erebus-labs/PSU-VOC-SENSOR-2K14/README.md

PSU VOC SENSOR PROJECT
==============

The PSU VOC SENSOR PROJECT is a multi-board and software approach to sensor data collection, specifically targetting K20 classrooms - All on an open source HW/SW stack.

The mutli-board solution allows for the independant and decoupled developement of custom sensors, while the open software stack allows custom interpolation of sensor readings. 

- [ ] Note that Some USB Drivers/custom communication drivers still need to be reworked before the entire project can be released under some flavor of Open Source Licensing (e.g. GPL v3?)

All of the Hardware and Software developed is available, keeping in mind that future revisions and use must maintain open source licensing.

#Schematics

##Main Board
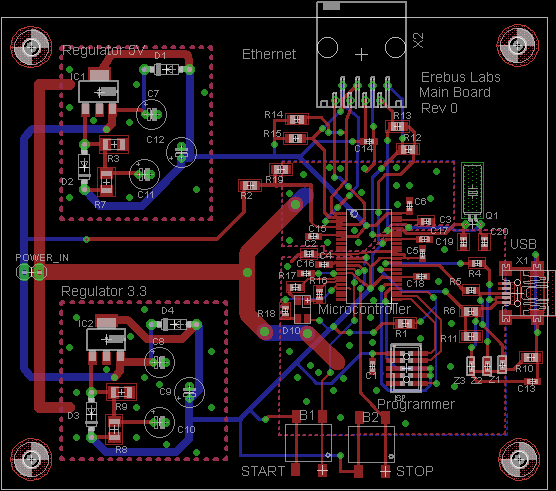
[picture p1: Schematics/LDO/LDO_Layout.png]
Main Board Main Board Schematic


##Sensor Boards
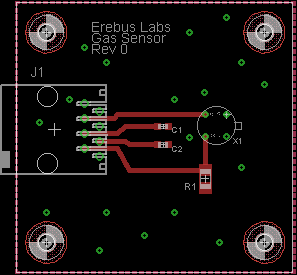
[picture p2: Schematics/Gas_Sensor/Gas_Sensor_layout.png]
Gas Sensor Gas Sensor Schematic


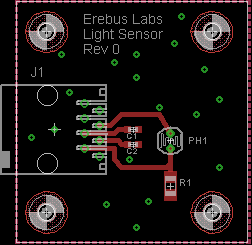
[picture p3: Schematics/Ligth_Sensor/Light_Sensor_Layout.png]
Light Sensor Light Sensor Schematic


#Code

##uC 

##GUI
