erebus-labs/PSU-VOC-SENSOR-2K14/Documents/Poster.pptx

Erebus Labs STEM Sensor

Department of Electrical and Computer Engineering

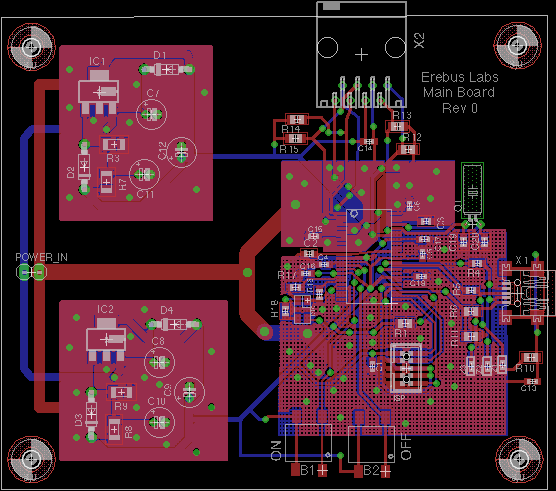
[picture p5: figure]
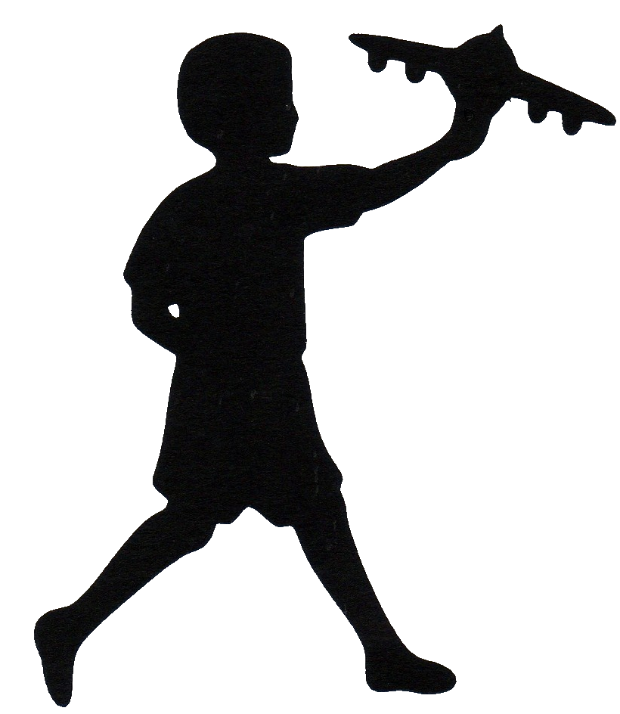
[picture p6: figure]
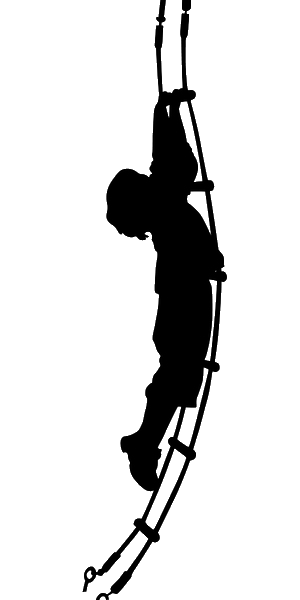
[picture p7: figure]
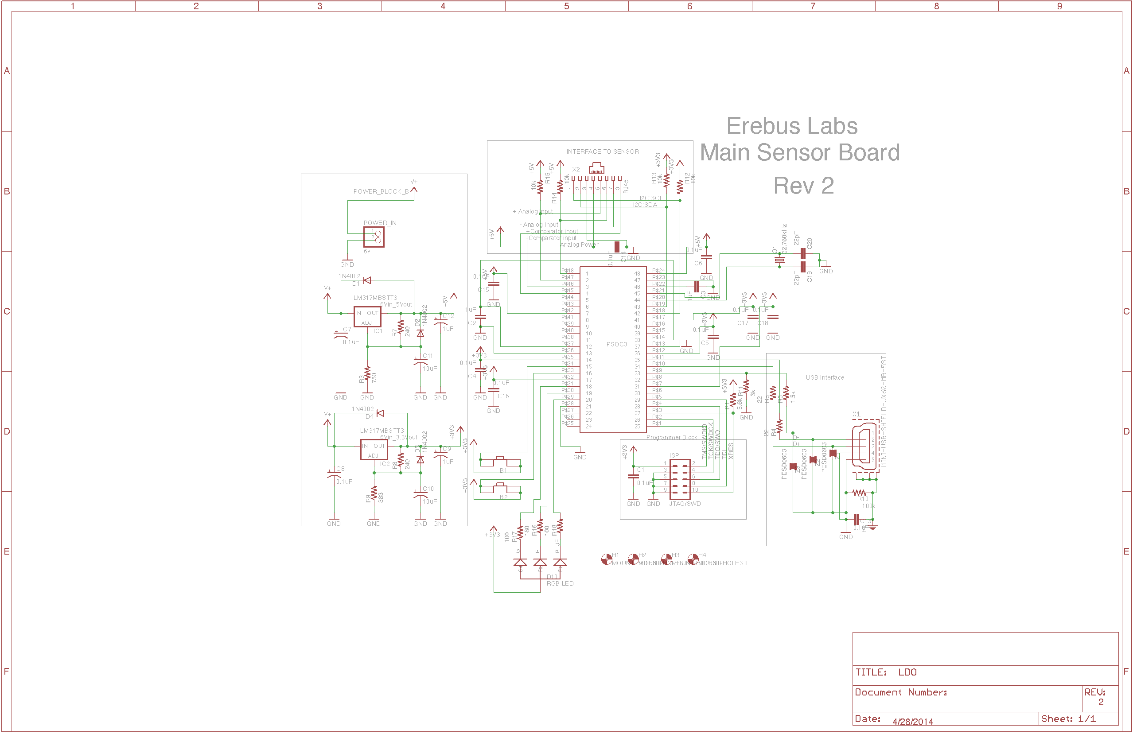
[picture p8: figure]

Meet The Team

Scott Lawson:
Computer Engineering
Max Cope:
Electrical Engineering
Chris Clary:
Electrical Engineering
Bryan Button:
Electrical Engineering
Mike Borowczak, Ph.D.:
Sponsor
Andrea Burrows, Ed.D.:
Assistant Professor of Secondary Education, UW
Sponsor
James E. Morris, Ph.D.:
Professor or Electrical and Computer Engineering
Advisor
