erebus-labs/PSU-VOC-SENSOR-2K14/Documents/source_documents/Presentation.pptx

## Erebus Labs STEM Sensor

Scott Lawson – CpE
Chris Clary – EE
Max Cope – EE
Bryan Button – EE

## Slide 2

Erebus Labs STEM Sensor

- Introduction

Objective
Hardware
Software
Lessons Learned
Thoughts for Rev. 2
Q&A

## Slide 3

- Introduction

- Objective

- Create an Environmental Sensor System
  - Hardware/Software
  - Documentation
- Keep it Simple
- Keep it Open
- Keep it Cheap
- Get Kids Interested in STEM!

Notes: Talking points:

%16 of American high school seniors are proficient in mathematics and interested in a STEM career

## Hardware

## Slide 5

- Hardware

- Hardware Overview

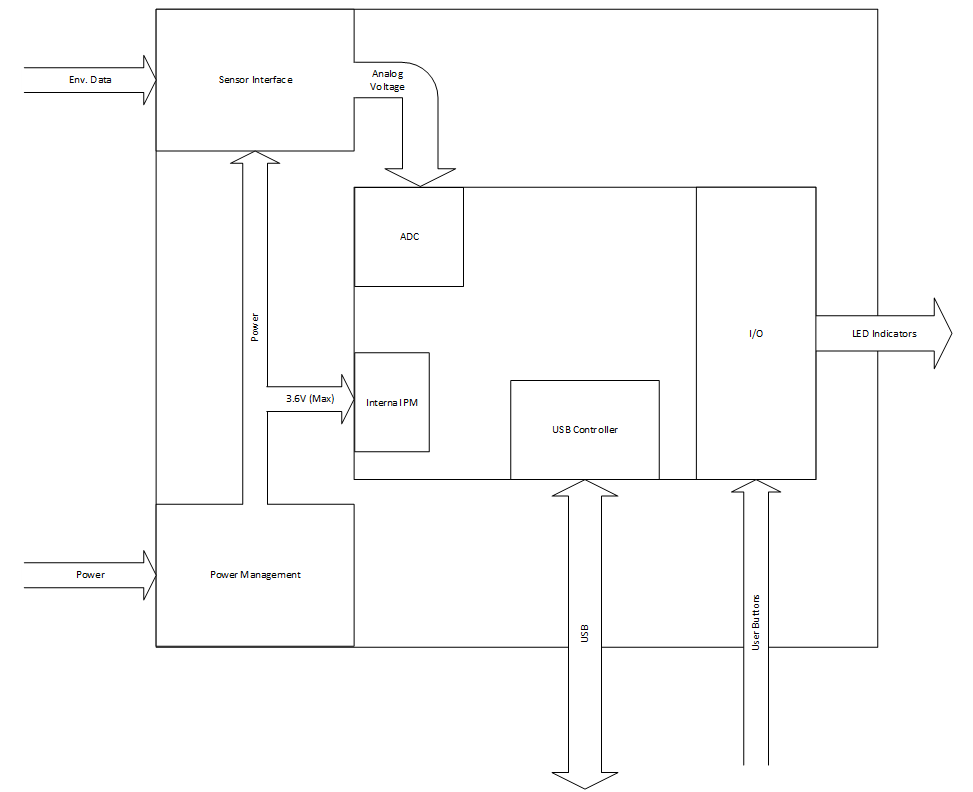
[picture p47: figure]

## Slide 6

- Hardware

- Main Board (Base Station)

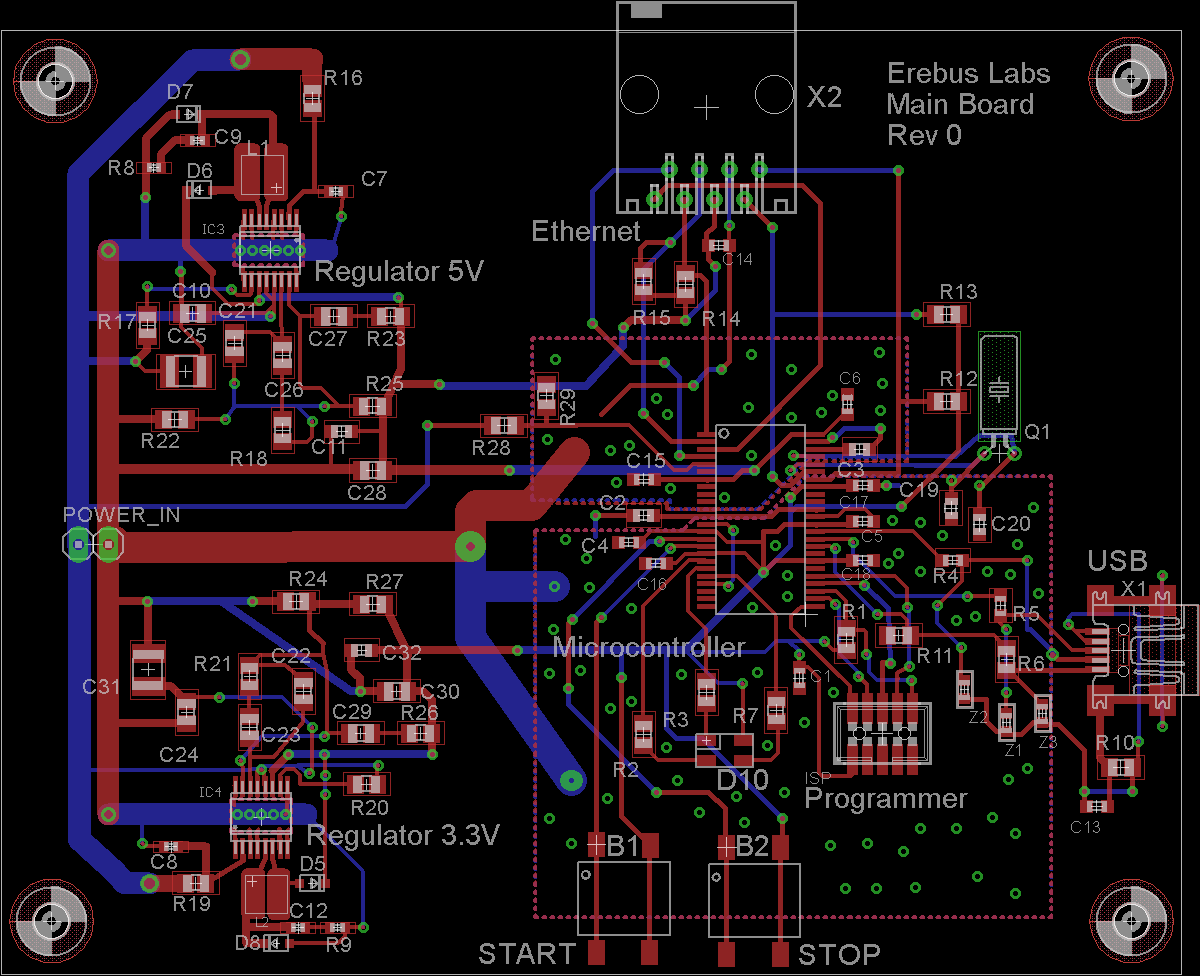
[picture p48: figure]

Sensor Port

PSoC 3 Microcontroller

USB Interface

Switching Power Supply

Notes: Chris starts
Discuss GPs
Note power and interface and discuss in detail when they come up

## Slide 7

- Hardware

- Power Supply

- Linear Power Supply
  - Less Noise
  - Lower Battery Life
- Switching Power Supply
  - Noise Not An Issue
  - Better Battery Life
  - One Part for 3V and 5V
  - More Complex

Notes: Tradeoffs (LDO vs Swiching)

Switching regulators didn’t work on breadboard

## Slide 8

- Hardware

- Interfaces

- Ethernet for Sensor Port
  - Cheap Cables
  - Easy to Work With
  - Many Lengths Available
- USB
  - Standard for Most Computer Interface Applications
  - Micro USB = Small Footprint


Notes: Ethernet:
Cheap cables are important for keeping costs low.
Easy to work with in consideration of use by children (not to hard to make your own cable).
Length kept in mind for future applications (e.g. sensor in a well)
More sensors could be put onto a single module

USB:

## Slide 9

- Hardware

- Low-Oxygen Sensor

- Figaro TGS 2600
- Technically “Air Contaminant Sensor”
- Resemblance to VOC Sensor
- Easy to Find Applications or Experiments


Notes: Labeled as an air contaminant sensor, the device senses contaminants due to the displacement of oxygen (or just normal breathing air) causing a change in the flow of electrons. Different sensitivity characteristics for different gasses.

Wanted to do a sensor that detected the quality of a substance similar to the original request for a VOC sensor for wells.

Experiments include things such as detecting change in air quality in high traffic areas over certain times or seeing how rapidly the quality of air changes when enclosed with a burning candle (and how long it takes for air to return to normal).

## Slide 10

- Hardware

- Light Sensor

- Easy to Implement
- Simple to Understand
- Many Use Cases
- Proof of Concept Sensor


## Slide 11

- Hardware

- Other

- Two Buttons (Start & Stop)
- LED System Indicator
  - Start Sampling
  - Stop Sampling
- Powered with 4x AA Batteries

## Slide 12

- Hardware

- Cypress PSoC 3

- One Chip Solution
  - Real Time Clock
  - USB Controller
  - Hardware Emulation
- Flexible Architecture
  - Universal Digital Blocks
  - Programmable Interconnects
- Development Kit – Rapid Prototyping

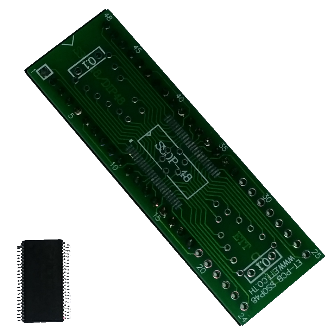
[picture p49: figure]
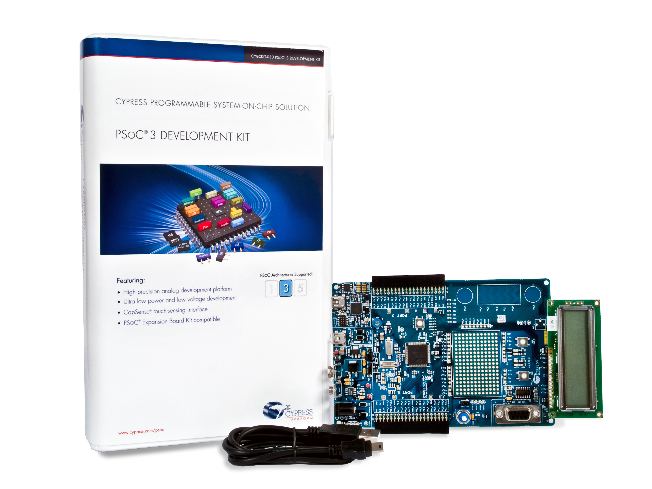
[picture p50: figure]

Notes: Max starts
One Comp E. Three with basic programming skills.
All had experience with Arduino. Simple IDEs
Needed something easy to program and could handle all we needed.

## Slide 13

- Hardware

- PSoC Architecture

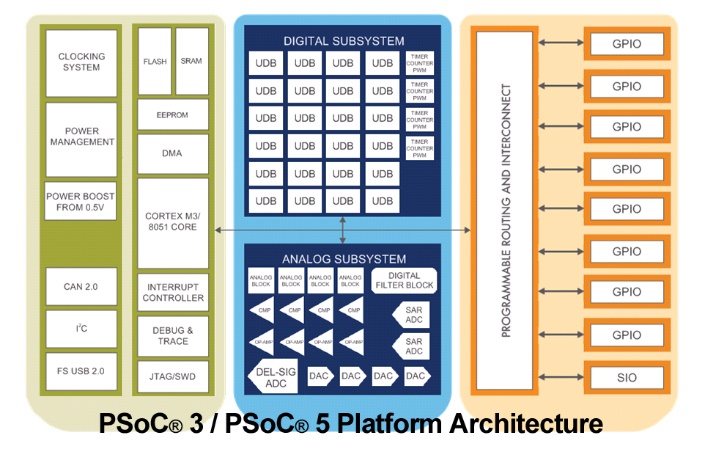
[picture p51: figure]

Notes: Universal GPIO
Analog Digital
Multiplexed ADC
Programmable Gain
Configurable Logic

## Software

## Slide 15

- Software

- PSoC Creator

- Free Development Environment
- Drag-and-Drop Programming
- Extensive APIs


Notes: EDE free to use. Graphical interface to simplify programming workload and design.
APIs. Option Windows. Build Project creates foundational code. Can modify from there.

## Slide 16

- Software

- Firmware

EX: Sample Every 3 Seconds
  - RTC Interrupts
  - Sample Counter Increments
  - If Counter == Sample Interval
    - Take Sample

Notes: Keep basic.
Wakes up every second to check for interrupt.

Pointers
Flash
Interrupts.
RTC Sampling

Buttons interrupt.
Once set up sleeps . Every second wakes up to check for flags.

## Slide 17

- Software

- Firmware

- Serial Over USB
- LED System Indicator
  - Sample
  - Error
  - USB Connected
- Max Speed 1 Sample Per Second

Notes: Will not show up as USB. Virtual COM Port.
Sample:
Blue blink
Errors:
* Low Battery (blink yellow)
Memory Full (red)
USB
Solid teal

1 Second check. No faster
Counter logic for timed samples

## Slide 18

- Software

- Firmware

- Emulated EEPROM
  - Emulated Inside Flash
  - Wear Leveling
- Power Management
  - No Power Switch
  - Minimal Current Use
- Timestamps Using Real Time Clock

Notes: Scott starts

## Slide 19

- Software

- GUI

- Simple & Minimalistic
- Sample Settings
- Reference and Documentation


## Slide 20

- Software

- Software/Hardware Interaction

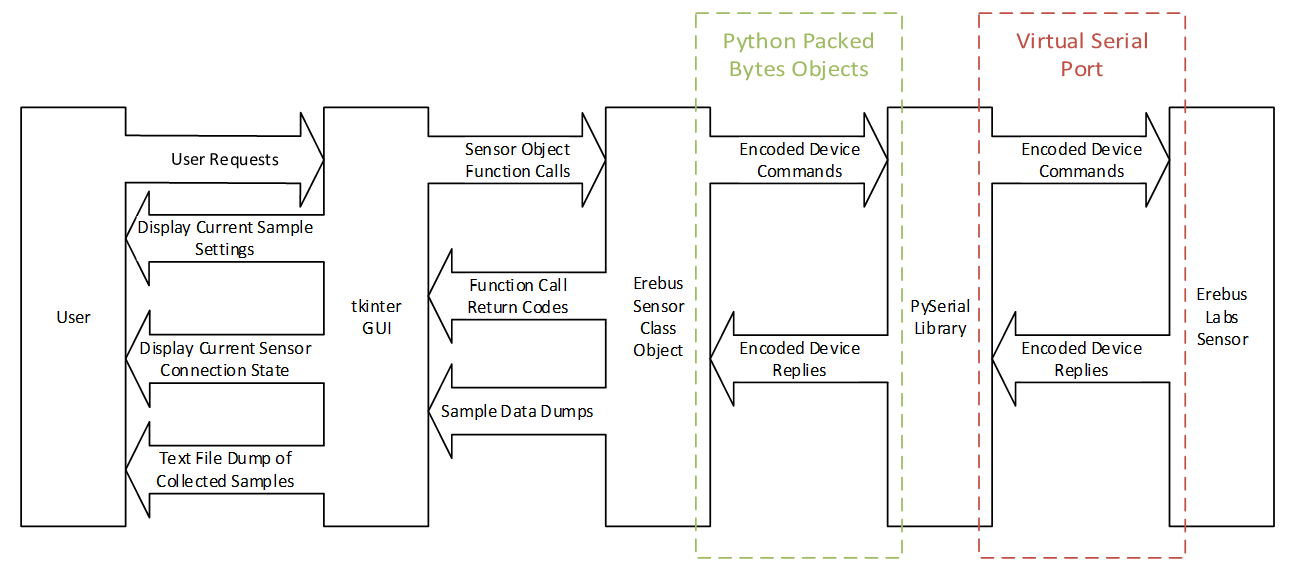
[picture p52: figure]

## Documentation

Notes: Hand out documents

Stop example experiment and process data

## Slide 22

- Documentation

- User Documents

- Technical Reference Manual
- System Architecture
- User Manual
- Fundamentals of Electronics

Notes: Start handing out documentation

## Slide 23

- Documentation

- Project Documents

- Design Specification
- Budget
- Timeline
- Requirements
- Test Plan

## Lessons Learned (Thoughts for Rev. 2)

Notes: Bryan starts

## Slide 25

- Thoughts

- Lessons Learned

- Don’t Focus on Single-Chip Solution
  - Distribution = Power Savings
- Use Separate EEPROM
  - Storage not Lost Due to Firmware Size
  - Wear Leveling
- Use Off-Chip RTC
  - Button-Cell Battery Backup

Notes: Current RTC loses time when power is lost

## Slide 26

- Thoughts

- Revision 2

- Critical Battery Shutdown
- Enclosure Mounted Buttons
- Power-Wire Strain Relief
- Weather Proof Box
- VOC Sensor
- Multiple Sensor Ports
- Jumper for Power

## Q&A

Notes: Answer questions
