erebus-labs/PSU-VOC-SENSOR-2K14/Documents/source_documents/Budget.docx

Erebus Labs

STEM Sensors

Budget

Version 1.6

6/4/2014

scott lawson

Bryan Button

Chris clary

max cope

VERSION HISTORY

Version # | Implemented By | Revision Date | Reason
1.5 | Scott Lawson | 6/4/2014 | Added Final BOM Costs
1.4 | Scott Lawson | 6/1/2014 | Removed 2.2 – Remaining Costs section Separated BOM section into Initial Estimation and Final
1.3 | Scott Lawson | 2/1/2014 | Fixed Header and cover sheet typos Split Total Anticipated Budge & Remaining Costs
1.2 | Scott Lawson | 1/31/2014 | Added development boards cost to section 2.2 Fixed type in BOM costs
1.1 | Scott Lawson | 1/30/2014 | Changed to Standardized Format Added microcontroller costs
1.0 | Scott Lawson | 1/28/2014 | Initial Release

NOTE TO READER

This is a template obtained from:

http://www2.cdc.gov/cdcup/library/templates/default.htm

Template Name: Product Design

UP Template Version: 12/31/07

TABLE OF CONTENTS

# 1 Introduction

## 1.1 Purpose of The Document

This document describes the budget allotted and cost estimations for the Erebus Labs STEM Sensor. This document is intended to be a living document. As such, it should be updated whenever new budget-related information is available. The reader should be aware that information contained in this document may change at any time.

## 1.2 Objective Statement

Encourage an interest in STEM in K-12 students by delivering a working prototype of an affordable, simple and flexible device to collect environmental data.

## 1.3 Overview

This document is divided into two sections:

1. Development Costs

This section contains estimated costs related to the development of the STEM Sensor. This section is further divided into two sections: a ledger to track purchases that have already been made, and a summary of the total anticipated development budget from the beginning of the project.

2. Bill of Materials Costs

These are costs associated with the production of a single sensor unit, excluding amortized development costs. This section contains both the final BOM cost as well as a copy of the initial estimation before many design decisions were made for comparison.

# 2 Development Costs

## 2.1 Ledger

## 2.2 Initial Estimation

Item | Cost (Ea) | Quantity | Ext. Cost | Cost Factors
Sensor | 1.00 – 25.00 | 5 – 8 | 5.00 – 50.001 | Type, Quantity of each type
μController | 1.50 – 5.00 | 5 – 8 | 7.50 – 40.00 | Onboard Features, power consumption
Batteries | 0.75 – 12.00 | 5 – 162 | 12.00 – 60.002 | Rechargeable, composition, form factor
Passives4 | 0.05 – 2.00 | 50 – 100 | 20.00 – 30.001 | Values and tolerances required
Interfaces5 | 0.50 – 8.00 | 16 – 25 | 8.00 – 50.00 | Wireless vs. Wired
PCBs6 | 4.00 – 18.00 | 4 – 6 | 24.00 – 48.00 | PCB Area, sensor requirements
Other SI7 | 0.50 – 2.00 | 16 – 30 | 8.00 – 50.001 | Battery selection, sensor output
Packaging | 3.00 – 75.00 | 2 – 3 | 9.00 – 225.00 | Materials: laser-cut acrylic vs. 3D-printer
Software | 0.00 | 0.00 | 0.00 | Only utilizing free development software
Development Boards | 10.00 – 60.00 | 4 | 40.00 – 240.00 | Options available for selected controller
| | | | | | 0.00 | 0.00 | 0.00 | Only utilizing free development software
Total: | | | | | 300.00 – 700.00

1. Extended cost does not scale linearly with quantity because it is assumed that the maximum quantity would not be entirely comprised of the most expensive components.
2. Quantity and extended cost assume either a small amount of expensive rechargeable proprietary batteries, or a larger amount of cheap (AA or 9V) batteries.
3. Resistors, capacitors, inductors, LEDs
4. Antennas, transceivers, receivers, cable jacks
5. Assumes a PCB for the base unit as well as separate PCBs for the interchangeable sensors.

Example: Minimum extended cost is based on a 2in x 2in base unit PCB with two 1in x 1in sensor PCBs at $2.00 per square inch, x2 prototypes.

6. Other semiconductors: op-amps, voltage regulators, discrete transistors

# 3 BOM Costs

## 3.1 Final

## 3.2 Initial Estimation

# Appendix A: Glossary

## A.1 Acronyms

Acronym | Meaning
ADC | Analog-to-Digital Converter
BOM | Bill of Materials
CO | Carbon Monoxide
CSV | Comma-separated-value formatted file
EEPROM | Electrically Erasable Programmable Read-Only Memory
EPL | The Portland State University Engineering and Prototyping Lab
I²C | The Inter-Integrated Circuit communication protocol
ISR | Interrupt Service Routine
K-12 | Kindergarten through 12th grade school
LED | Light Emanating Diode
PCB | Printed Circuit Board
PSoC | Programmable System On Chip
SI | Silicon
SPI | Serial Peripheral Interface Bus
STEM | Science, Technology, Engineering and Math
TRM | Technical Reference Manual
USB | Universal Serial Bus

Page 9 of 9 Portland State University ECE Capstone 2014

Portland State University ECE Capstone 2014

STEM Sensors Budget
