erebus-labs/PSU-VOC-SENSOR-2K14/Documents/System_Architecture.pdf

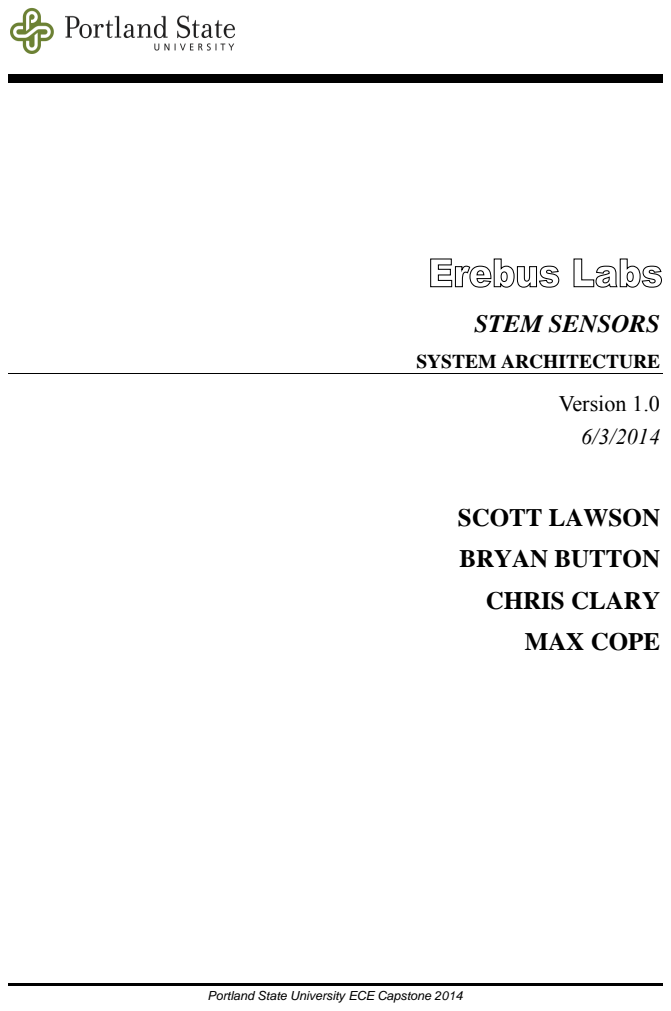
[picture p53: page 1]
STEM SENSORS; SYSTEM ARCHITECTURE; Version 1.0; SCOTT LAWSON; BRYAN BUTTON; CHRIS CLARY; MAX COPE

Portland State University ECE Capstone 2014

STEM Sensors System

SYSTEM ARCHITECTURE

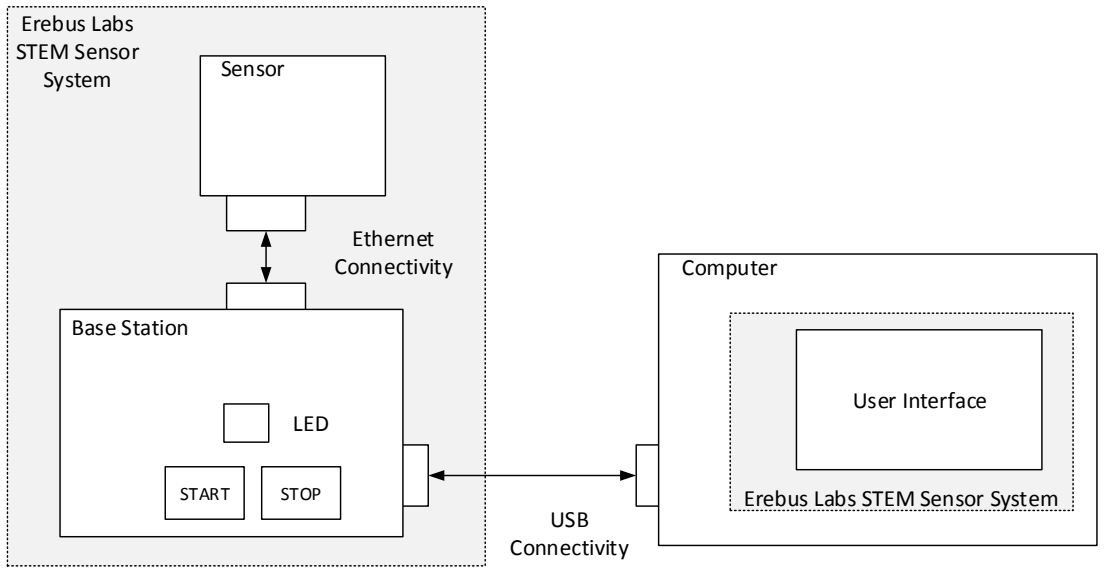
[picture p54: figure]
Ethernet Connectivity; Base Station; Sensor; Computer; USB Connectivity; Erebus Labs STEM Sensor System; START; STOP; LED; User Interface

System
The operational product comprised of base units with attached sensors and a user interface.
Base Unit
The central device that manages power, communication, and data storage, and has one or more sensors attached to it.
Sensor
The individual data collection devices such as VOC detectors and ambient light detectors that are attached to the base unit.

User Interface
The program that will be run on a laptop or desktop computer that allows the user to view and interact with the data collected.

STEM Sensors System

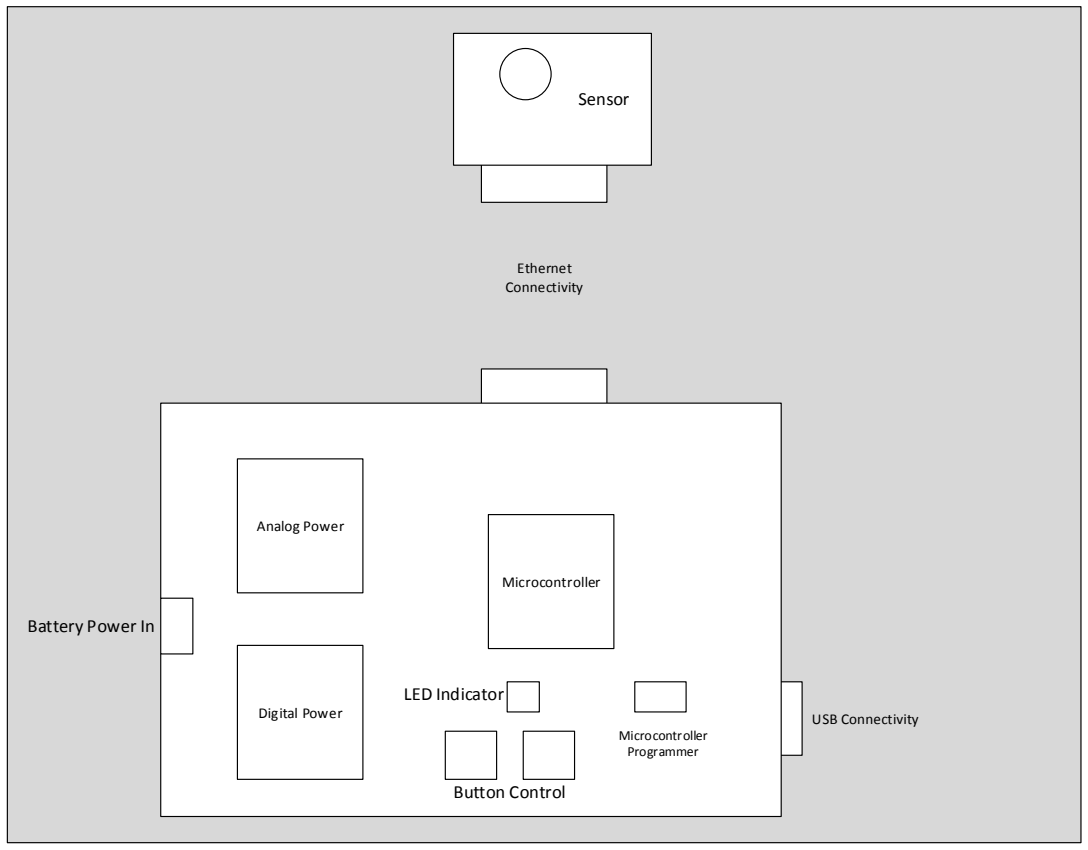
[picture p55: figure]
Microcontroller; Analog Power; Digital Power; Button Control; LED Indicator; Battery Power In; Microcontroller Programmer; Ethernet Connectivity; Sensor; USB Connectivity

Power
Provides 3.3V and 5V power for all peripherals both analog and digital. Sensors are powered from base station.
Microcontroller
System control including taking of samples and storing data. Reprogram capability.
User Control
User controllability with two buttons, Start and Stop sample collection, and an LED indicator.
