erebus-labs/PSU-VOC-SENSOR-2K14/Schematics/Board Enclosures/Erebus Labs Logo.pdf

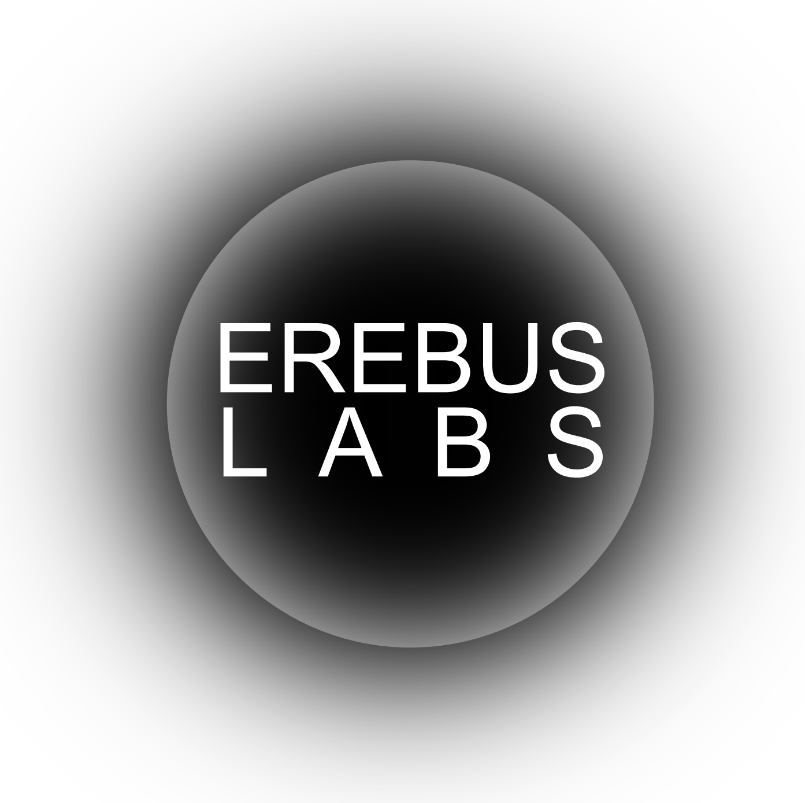
[picture p59: page 1]

L A B S

EREBUS
