erebus-labs/PSU-VOC-SENSOR-2K14/Documents/source_documents/images/schematic_MainBoard.png

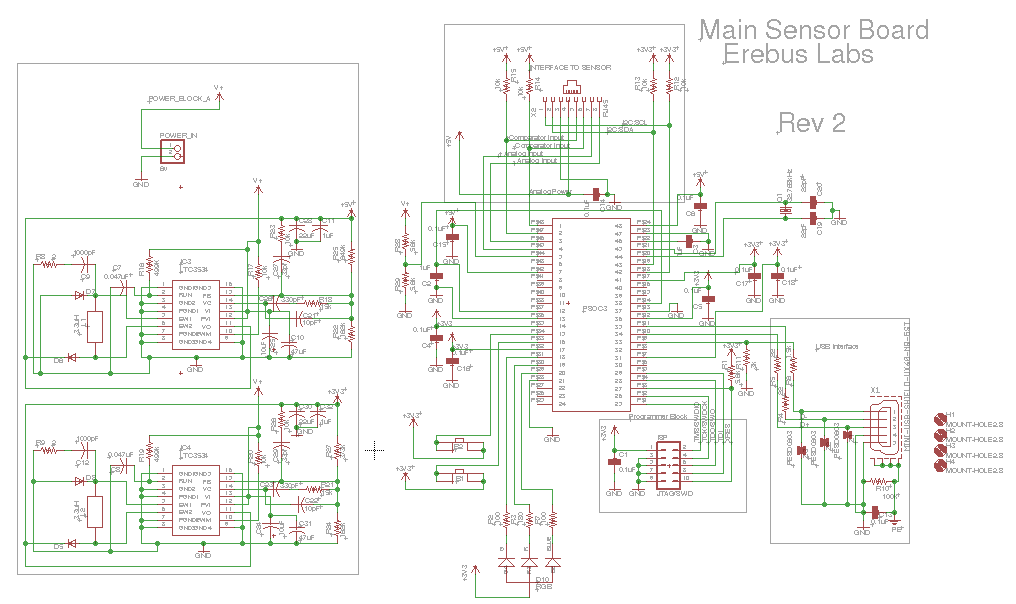
Documents/source_documents/images/schematic_MainBoard.png
