erebus-labs/PSU-VOC-SENSOR-2K14/Schematics/Dimensions/Gas Board.png

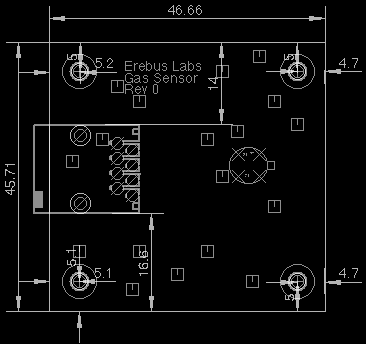
Schematics/Dimensions/Gas Board.png
