erebus-labs/PSU-VOC-SENSOR-2K14/Schematics/Dimensions/LDO.png

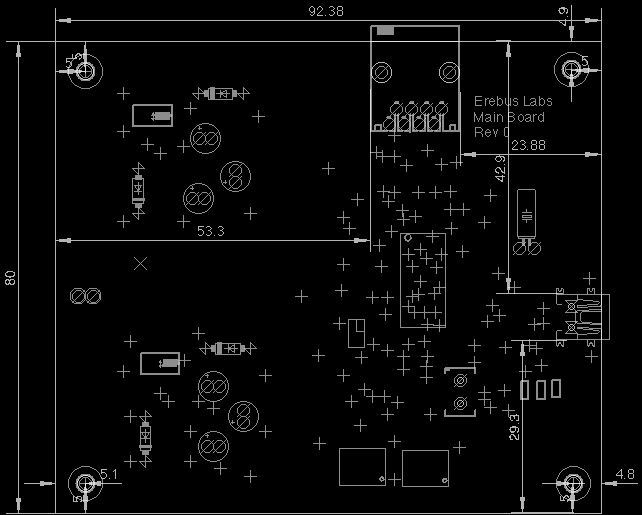
Schematics/Dimensions/LDO.png
