erebus-labs/PSU-VOC-SENSOR-2K14/Schematics/Dimensions/Light Sensor.png

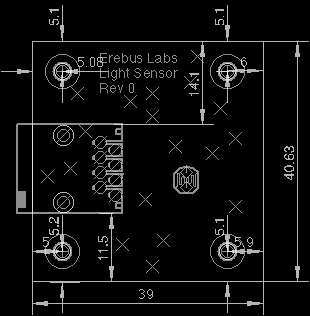
Schematics/Dimensions/Light Sensor.png
