erebus-labs/PSU-VOC-SENSOR-2K14/Schematics/Dimensions/Switching.png

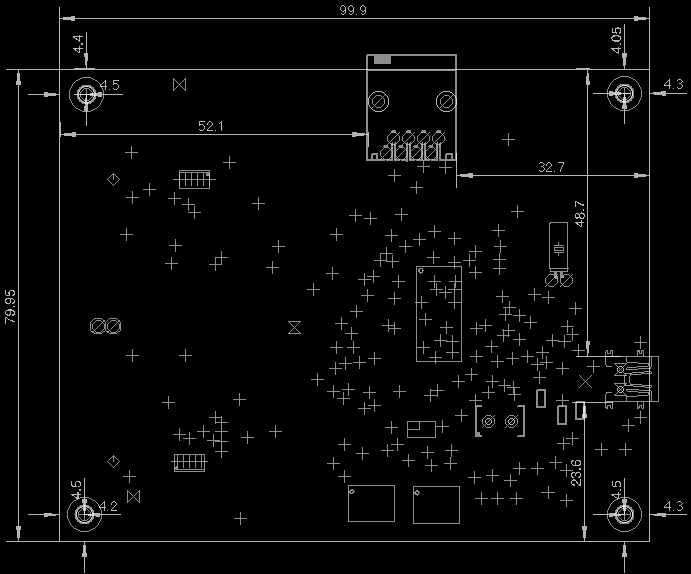
Schematics/Dimensions/Switching.png
