erebus-labs/PSU-VOC-SENSOR-2K14/Schematics/Gas_Sensor/Gas_Sensor.png

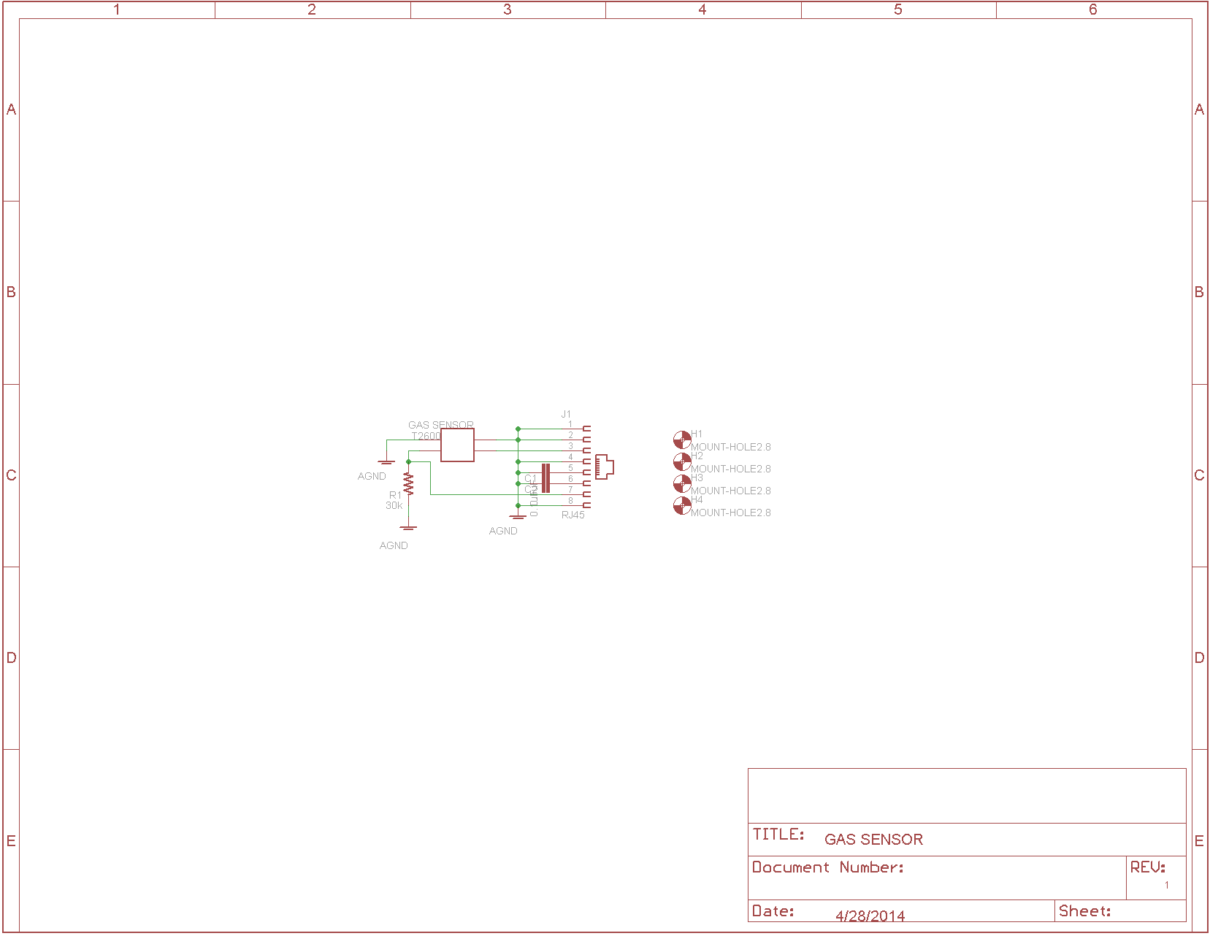
Schematics/Gas_Sensor/Gas_Sensor.png
