erebus-labs/PSU-VOC-SENSOR-2K14/Schematics/LDO/LDO_Schem.png

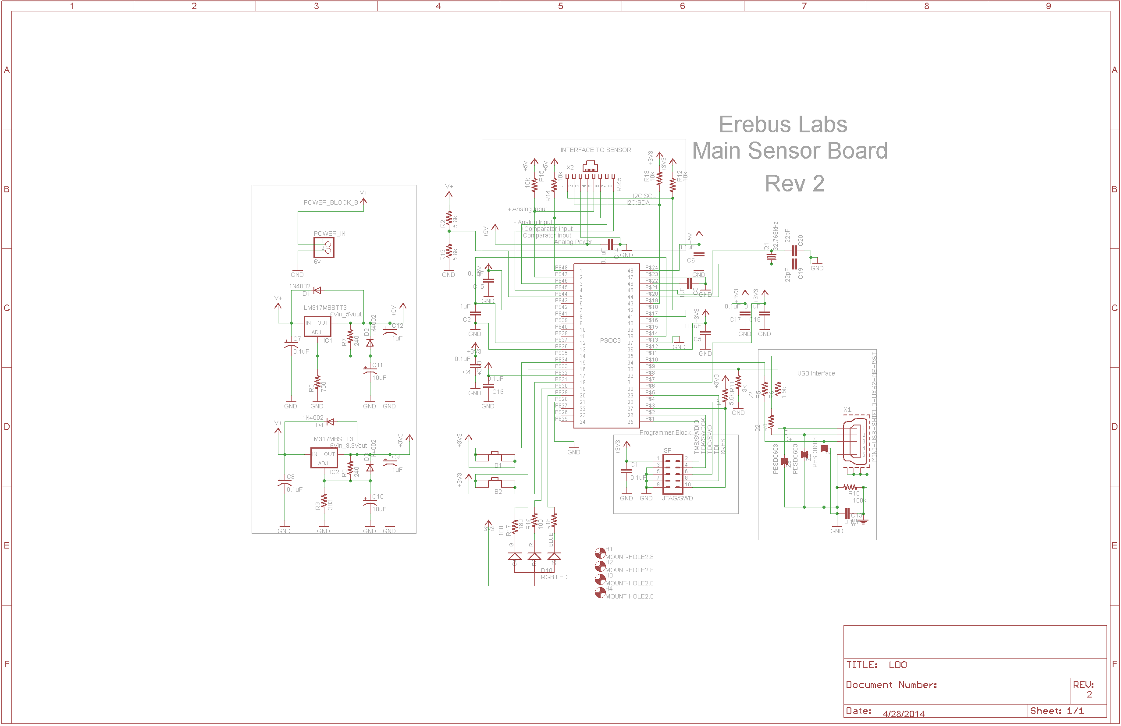
Schematics/LDO/LDO_Schem.png
