erebus-labs/PSU-VOC-SENSOR-2K14/Schematics/Ligth_Sensor/Light_Sensor_Board.png

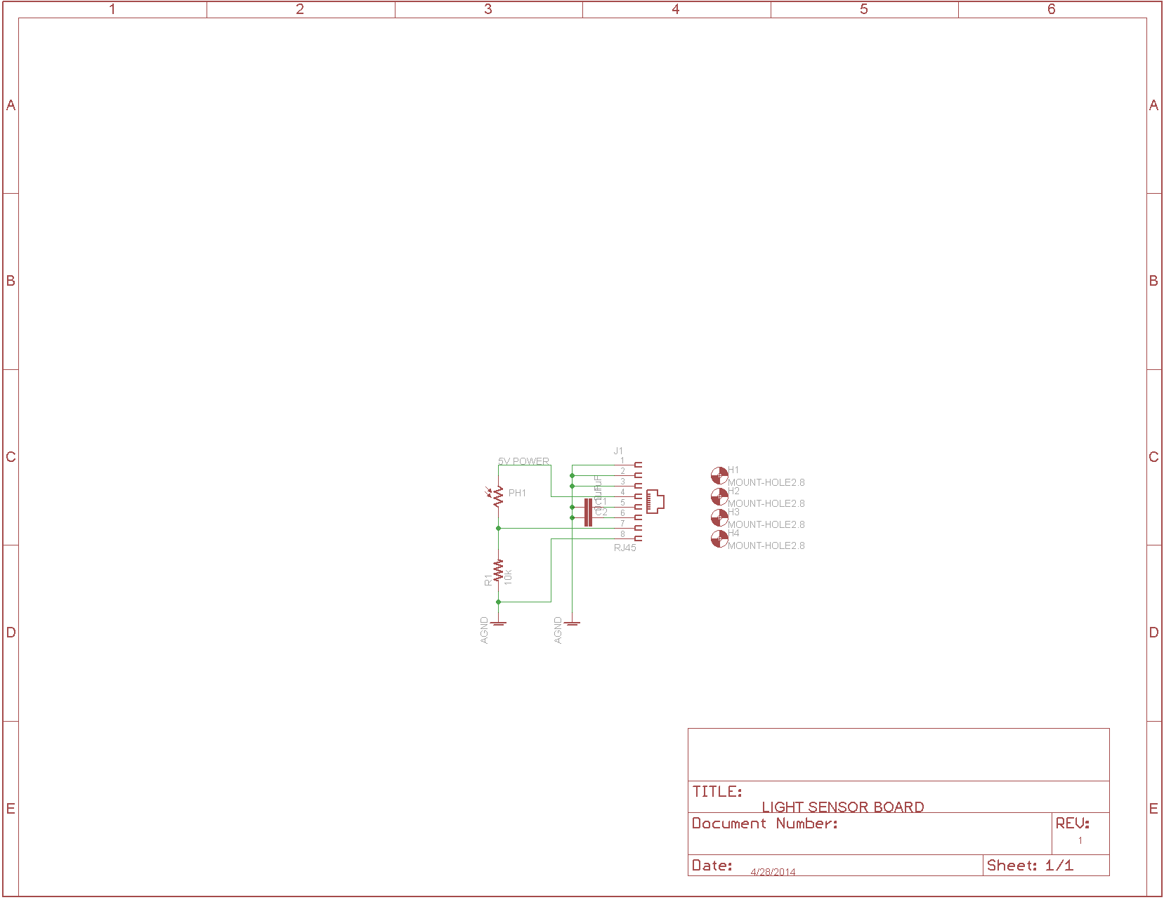
Schematics/Ligth_Sensor/Light_Sensor_Board.png
