erebus-labs/PSU-VOC-SENSOR-2K14/Schematics/Switching/Board.png

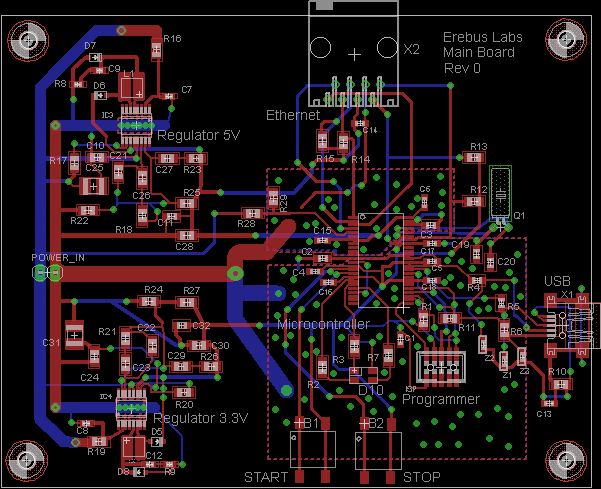
Schematics/Switching/Board.png
