erebus-labs/PSU-VOC-SENSOR-2K14/Schematics/Switching/Schematic.png

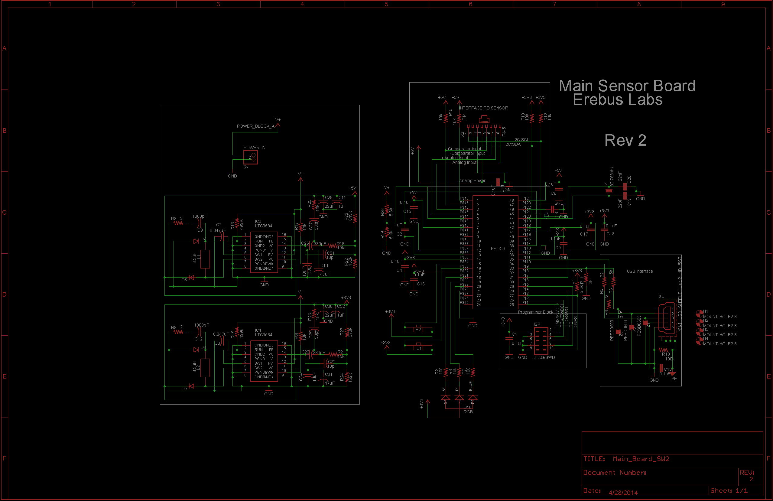
Schematics/Switching/Schematic.png
