erebus-labs/PSU-VOC-SENSOR-2K14/Documents/BOM.xls

Sheet: Switching
Erebus Labs Switching Supply BOM
Rev 1 Chris Clary Initial Build 4/1/2014
Rev 2 Chris Clary Spilt Up the Different Power Supplies 5/26/2014
Main CPU Block
Item | Qty | Reference | Value | Description | Manufacturer | Mfr Part Number
1 | 1 | PSOC3 |  | PSOC3 microprocessor | Cypress | CY8C3245PVI-150
2 | 2 | B1,B2 | SPST | SWITCH TACTILE SPST-NO 0.05A 12V | TE Connectivity | 2-1437565-9
3 | 2 | C19,C20 | 22pF | CAP CER 22pF 50V NP0 0603 | TDK | C1608C0G1H220J080AA
4 | 7 | C4,C5,C6,C15,C16,C17,C18 | 0.1uF | CAP CER 0.1uF 16V Y5V 0603 | Kemet | C0603C104Z4VACTU
5 | 2 | C2,C3 | 1uF | CAP CER 1uF 25V 10% X5R 0603 | Taiyo Yuden | TMK107BJ105KA-T
6 | 1 | D10 | RGB | WL-SBTW SMD RGB TOP LED | Wurth Electronics | 150141M173100
7 | 2 | R2,R17 | 100Ω | RES 100 OHM 1/8W 1% 0805 SMD | Yageo | RC0805FR-07100RL
8 | 1 | R3 | 180Ω | RES 180 OHM 1/8W 1% 0805 SMD | Yageo | RC0805FR-07180RL
9 | 1 | R11 | 3kΩ | RES 1.5k OHM 1/8W 5% 0805 SMD | Yageo | RC0805JR-073KL
10 | 3 | R1,R28,R29 | 5.6kΩ | RES 5.6k OHM 1/8W 5% 0805 SMD | Yageo | RC0805JR-075K6L
11 | 1 | Q1 | 32.768kHz | 32.768KHZ 12.5PF THRU | Abracon Corp. | AB38T-32.768KHZ
Programmer Block
Item | Qty | Reference | Value | Description | Manufacturer | Mfr Part Number
12 | 1 | C1 | 0.1uF | CAP CER 0.1uF 16V Y5V 0603 | Kemet | C0603C104Z4VACTU
13 | 1 | ISP |  | CON HEADER DUAL POSITION .05” SMD | Samtec | FTSH-105-01-L-DV-K
USB Interface
Item | Qty | Reference | Value | Description | Manufacturer | Mfr Part Number
14 | 1 | C13 | 0.1uF | CAP CER 0.1uF 16V Y5V 0603 | Kemet | C0603C104Z4VACTU
15 | 2 | R4,R5 | 22Ω | RES 22 OHM 1/10W 5% 0603 SMD | Yageo | RC0603JR-0722RL
16 | 1 | R6 | 1.5KΩ | RES 1.5k OHM 1/8W 5% 0805 SMD | Yageo | RC0805JR-071K5L
17 | 1 | R10 | 100KΩ | RES 100k OHM 1/8W 5% 0805 SMD | Yageo | RC0805JR-07100KL
18 | 1 | X1 | USB Mini B | CONN RECPT MINI USB2.0 5POS | Hirose | UX60-MB-5ST
19 | 1 | Z1,Z2,Z3 | ESD Diode | SUPRESSOR ESD 5VDC 0603 SMD | Bourne Inc. | CG0603MLC-05LE
Sensor Interface
Item | Qty | Reference | Value | Description | Manufacturer | Mfr Part Number
20 | 1 | C14 | 0.1uF | CAP CER 0.1uF 16V Y5V 0603 | Kemet | C0603C104Z4VACTU
21 | 4 | R12,R13,R14,R15 | 10KΩ | RES 1Ok OHM 1/8W 5% 0805 SMD | Yageo | RC0805JR-0710KL
22 | 1 | X2 | RJ-45 | CONN MOD R/A 8P8C | TE Connectivity | 5555167-1
Power Block Switching Supply
Item | Qty | Reference | Value | Description | Manufacturer | Mfr Part Number
23 | 2 | C21,C22 | 10pF | CAP CER 10pF 50V 5% NP0 0805 | Yageo | CC0805JRNPO9BN100
24 | 2 | C27,C29 | 33pF | CAP CER 33pF 50V 5% NP0 0805 | Yageo | CC0805JRNPO9BN330
25 | 2 | C23,C26 | 330pF | CAP CER 330pF 50V 10% X7R 0805 | Yageo | CC0805KRX7R9BB331
26 | 2 | C9,C12 | 1000pF | CAP CER 1000pF 50V 20% X7R 0402 | TDK Corporation | C1005X7R1H102M050BA
27 | 2 | C8,C7 | 0.047uF | CAP CER 0.047 16V 10% X5R 0402 | AVX Corporation | 0402YD473KAT2A
28 | 2 | C11,C32 | 1uF | CAP CER 1uF 6.3V 20% X5R 0603 | Murata Electronics | GRM188R60J105MA01D
29 | 2 | C24,C25 | 10uF | CAP CER 10uF 16V 10% X5R 0805 | TDK Corporation | C2012X5R1C106K085AC
30 | 2 | C28,C30 | 22uF | CAP CER 22uF 16V 10% X5R 0805 | TDK Corporation | C2012X5R1C226K125AC
31 | 2 | C10,C31 | 47uF | CAP TANT 47uF 10V 20% 1210 | AVX Corporation | TAJB476M010RNJ
32 | 4 | D5,D6,D7,D8 | Schottkey Diode | DIODE SCHOTTKY 20V 1 A SOD323 | NXP Semiconductor | PMEG2010EA,115
33 | 2 | IC3,IC4 | Switching Regulator | IC REG BUCK BOOST SYNC 0.5A 16SSOP | Linear Technology | LTC3534EGN#PBF
34 | 2 | L1,L2 | 3.3uH | INDUCTOR POWER 3.3UH 1.3A SMD | TDK Corporation | VLS3015ET-3R3M
35 | 2 | R8,R9 | 2Ω | RES 2 OHM 1/16 5% 0402 SMD | Vishay Dale | CRCW04022RD00JNED
36 | 4 | R17,R20,R23,R26 | 10KΩ | RES 10k OHM 1/8W 5% 0805 SMD | Yageo | RC0805JR-0710KL
37 | 2 | R18,R21 | 15KΩ | RES 15k OHM 1/8W 5% 0805 SMD | Yageo | RC0805JR-0715KL
38 | 2 | R22,R24 | 162KΩ | RES 162k OHM 1/8W 1% 0805 SMD | Yageo | RC0805FR-07162KL
39 | 2 | R16,R19 | 499KΩ | RES 499k OHM 1/8W 1% 0805 SMD | Yageo | RC0805FR-07499KL
40 | 1 | R27 | 374KΩ | RES 374k OHM 1/8W 1% 0805 SMD | Yageo | RC0805FR-07374KL
41 | 1 | R25 | 649kΩ | RES 649k OHM 1/8W 1% 0805 SMD | Yageo | RC0805FR-07649KL
42 | 4 |  | 1.5V | BATTERY IND ALKALINE AA SIZE | Panasonic | LR6XWA/2SB
43 | 1 |  | Batter Case | HOLDER 4AA BATTERY CELLS WILRE LDS | MPD | BC4AAw
Light Sensor
Item | Qty | Reference | Value | Description | Manufacturer | Mfr Part Number
44 | 2 | C33,C34 | 0.1uF | CAP CER 0.1uF 16V Y5V 0603 | Kemet | C0603C104Z4VACTU
45 | 1 | J2 | RJ-45 | CONN MOD R/A 8P8C | TE Connectivity | 5555167-1
46 | 1 | PH1 | Photo Cell | PHOTOCELL 4-11K OHM 4.20 MM | Advanced Photonix | PDV-P9001
47 | 1 | R31 | 10KΩ | YAGEO 10K OHM 1/4W 5% 1206 | Yageo | RC1206JR-0710KL
Gas Sensor
Item | Qty | Reference | Value | Description | Manufacturer | Mfr Part Number
48 | 2 | C35,C36 | 0.1uF | CAP CER 0.1uF 16V Y5V 0603 | Kemet | C0603C104Z4VACTU
49 | 1 | J3 | RJ-45 | CONN MOD R/A 8P8C | TE Connectivity | 5555167-1
50 | 1 | R30 | 30KΩ | RES 30.0K OHM1/4W 1% 1206 | Yageo | RC1206FR-0730KL
51 | 1 | X1 | T2600 | GAS SENSOR INDOOR POLLUTANT T-05 | Figaro | T200
Interconnects
Item | Qty | Reference | Value | Description | Manufacturer | Mfr Part Number
52 | 1 |  | Cat 5e | CABLE CAT 5E SHEILDED BLUE 1M | Assmann WSW Comp. | A-MCSP-80010/B-R
53 | 1 |  | A Male-Mini B | USB A MALE-MINI B 5 PIN 1M | CNC Tech | 102-1031-GR-00100

Sheet: LDO
Erebus Labs LDO BOM
Rev 1 Chris Clary Initial Build 4/1/2014
Rev 2 Chris Clary Spilt Up the Different Power Supplies 5/26/2014
Main CPU Block
Item | Qty | Reference | Value | Description | Manufacturer | Mfr Part Number
1 | 1 | PSOC3 |  | PSOC3 microprocessor | Cypress | CY8C3245PVI-150
2 | 2 | B1,B2 | SPST | SWITCH TACTILE SPST-NO 0.05A 12V | TE Connectivity | 2-1437565-9
3 | 2 | C19,C20 | 22pF | CAP CER 22pF 50V NP0 0603 | TDK | C1608C0G1H220J080AA
4 | 7 | C4,C5,C6,C15,C16,C17,C18 | 0.1uF | CAP CER 0.1uF 16V Y5V 0603 | Kemet | C0603C104Z4VACTU
5 | 2 | C2,C3 | 1uF | CAP CER 1uF 25V 10% X5R 0603 | Taiyo Yuden | TMK107BJ105KA-T
6 | 1 | D10 | RGB | WL-SBTW SMD RGB TOP LED | Wurth Electronics | 150141M173100
7 | 2 | R17,R18 | 100Ω | RES 100 OHM 1/8W 1% 0805 SMD | Yageo | RC0805FR-07100RL
8 | 1 | R16 | 180Ω | RES 180 OHM 1/8W 1% 0805 SMD | Yageo | RC0805FR-07180RL
9 | 1 | R11 | 3kΩ | RES 1.5k OHM 1/8W 5% 0805 SMD | Yageo | RC0805JR-073KL
10 | 3 | R1,R2,R19 | 5.6kΩ | RES 5.6k OHM 1/8W 5% 0805 SMD | Yageo | RC0805JR-075K6L
11 | 1 | Q1 | 32.768kHz | 32.768KHZ 12.5PF THRU | Abracon Corp. | AB38T-32.768KHZ
Programmer Block
Item | Qty | Reference | Value | Description | Manufacturer | Mfr Part Number
12 | 1 | C1 | 0.1uF | CAP CER 0.1uF 16V Y5V 0603 | Kemet | C0603C104Z4VACTU
13 | 1 | ISP |  | CON HEADER DUAL POSITION .05” SMD | Samtec | FTSH-105-01-L-DV-K
USB Interface
Item | Qty | Reference | Value | Description | Manufacturer | Mfr Part Number
14 | 1 | C13 | 0.1uF | CAP CER 0.1uF 16V Y5V 0603 | Kemet | C0603C104Z4VACTU
15 | 2 | R4,R5 | 22Ω | RES 22 OHM 1/10W 5% 0603 SMD | Yageo | RC0603JR-0722RL
16 | 1 | R6 | 1.5KΩ | RES 1.5k OHM 1/8W 5% 0805 SMD | Yageo | RC0805JR-071K5L
17 | 1 | R10 | 100KΩ | RES 100k OHM 1/8W 5% 0805 SMD | Yageo | RC0805JR-07100KL
18 | 1 | X1 | USB Mini B | CONN RECPT MINI USB2.0 5POS | Hirose | UX60-MB-5ST
19 | 1 | Z1,Z2,Z3 | ESD Diode | SUPRESSOR ESD 5VDC 0603 SMD | Bourne Inc. | CG0603MLC-05LE
Sensor Interface
Item | Qty | Reference | Value | Description | Manufacturer | Mfr Part Number
20 | 1 | C14 | 0.1uF | CAP CER 0.1uF 16V Y5V 0603 | Kemet | C0603C104Z4VACTU
21 | 4 | R12,R13,R14,R15 | 10KΩ | RES 1Ok OHM 1/8W 5% 0805 SMD | Yageo | RC0805JR-0710KL
22 | 1 | X2 | RJ-45 | CONN MOD R/A 8P8C | TE Connectivity | 5555167-1
Power Block LDO
Item | Qty | Reference | Value | Description | Manufacturer | Mfr Part Number
23 | 2 | C8,C7 | 0.1uF | CAP ALUM 0.1uF 50V 20% RADIAL | Nichicon | UVR1H0R1MDD
24 | 2 | C9,C12 | 1uF | CAP ALUM 1uF 100V 20% RADIAL | Nichicon | UPS2A010MDD1TD
25 | 2 | C10,C11 | 10uF | CAP ALUM 10uF 50V 20% RADIAL | Panasonic | ECA1HHG100
26 | 4 | D1,D2,D3,D4 | Diode | DIODE GEN PURPOSE 100V 1A DO-41 | Fairchild Semi. | 1N4002
27 | 2 | IC1,IC2 | LDO | IC REG LDO ADJ 0.5A SOT-223 | On Semiconductor | LM317MBSTT3GOSCT-ND
28 | 2 | R7,R8 | 240Ω | RES 240 OHM 1/4W 5% 1206 SMD | Yageo | RC1206JR-07240RL
29 | 1 | R9 | 383Ω | RES 383 OHM 1/4W 1% 1206 SMD | Yageo | RC1206FR-07383RL
30 | 1 | R3 | 750Ω | RES 750 OHM 1/4W 5% 1206 SMD | Yageo | RC1206JR-07750RL
31 | 4 |  | 1.5V | BATTERY IND ALKALINE AA SIZE | Panasonic | lLR6WA/B
32 | 1 |  | Battery Case | HOLDER 4AA BATTERY CELLS WIRE LDS | MPD | BC4AAW
Light Sensor
Item | Qty | Reference | Value | Description | Manufacturer | Mfr Part Number
33 | 2 | C33,C34 | 0.1uF | CAP CER 0.1uF 16V Y5V 0603 | Kemet | C0603C104Z4VACTU
34 | 1 | J1 | RJ-45 | CONN MOD R/A 8P8C | TE Connectivity | 5555167-1
35 | 1 | PH1 | Photo Cell | PHOTOCELL 4-11K OHM 4.20 MM | Advanced Photonix | PDV-P9001
36 | 1 | R31 | 10KΩ | YAGEO 10K OHM 1/4W 5% 1206 | Yageo | RC1206JR-0710KL
Gas Sensor
Item | Qty | Reference | Value | Description | Manufacturer | Mfr Part Number
37 | 2 | C35,C36 | 0.1uF | CAP CER 0.1uF 16V Y5V 0603 | Kemet | C0603C104Z4VACTU
38 | 1 | J1 | RJ-45 | CONN MOD R/A 8P8C | TE Connectivity | 5555167-1
39 | 1 | R30 | 30KΩ | RES 30.0K OHM1/4W 1% 1206 | Yageo | RC1206FR-0730KL
40 | 1 | X1 | T2600 | GAS SENSOR INDOOR POLLUTANT T-05 | Figaro | T200
Interconnects
Item | Qty | Reference | Value | Description | Manufacturer | Mfr Part Number
41 | 1 |  | Cat 5e | CABLE CAT 5E SHEILDED BLUE 1M | Assmann WSW Comp. | A-MCSP-80010/B-R
42 | 1 |  | A Male-Mini B | USB A MALE-MINI B 5 PIN 1M | CNC Tech | 102-1031-GR-00100
