erebus-labs/PSU-VOC-SENSOR-2K14/Documents/source_documents/TestPlanTestSheets.xlsx

Sheet: 5.1.1
Test Writer: Max Cope
Test Case Name: |  | Power Supply Voltage |  |  |  | Test ID #: | 5.1.1
Description: |  | Checks to make sure that Power is being supplied to the board at the correct voltages. All measured voltages must be +- 5% of desired voltage to pass test. A multimeter will be used to measure voltage. |  |  |  | Type: | White Box
Tester Information
Name of Tester: |  |  |  |  |  | Date
Hardware Ver: |  |  |  |  |  | Time
Setup: |  | Power section on PCB should be set up with power supply attached and switch on. Set power supply voltage to 7V
Step | Action | Expected Results | Pass | Fail | N/A | Comments
1 | With the supply at 7V, Measure voltage out of 5V regulator | Voltage of 4.75-5.25V
2 | Measure voltage out of 3.3V regulator | Voltage of 3.14-3.47V
3 | With the supply at 6V, Measure voltage out of 5V regulator | Voltage of 4.75-5.25V
 | Measure voltage out of 3.3V regulator | Voltage of 3.14-3.47V
 | With the supply at 5V, Measure voltage out of 5V regulator | Voltage of 4.75-5.25V
 | Measure voltage out of 3.3V regulator | Voltage of 3.14-3.47V
 | With the supply at 4V, Measure voltage out of 5V regulator | Voltage of 4.75-5.25V
 | Measure voltage out of 3.3V regulator | Voltage of 3.14-3.47V
 | With the supply at 3V, Measure voltage out of 5V regulator | Voltage of 4.75-5.25V
 | Measure voltage out of 3.3V regulator | Voltage of 3.14-3.47V
 | With the supply at 3V, observe the LED | Low Battery Indicator should be illuminated.
Overall test result:

Sheet: 5.2.1
Test Writer: Max Cope
Test Case Name: |  | Button Power and Function |  |  |  | Test ID #: | 5.2.1
Description: |  | This tests measures for the correct voltage supplied to the push buttons and if they are functioning correctly. |  |  |  | Type: | Black Box
Tester Information
Name of Tester: |  |  |  |  |  | Date
Hardware Ver: |  |  |  |  |  | Time
Setup: |  | Board is fully powered on and microcontroller programmed.
Step | Action | Expected Results | Pass | Fail | N/A | Comments
1 | Measure the Voltage on both the start and stop buttons | A voltage of 0 volts
2 | Engage each button to verify and active high response | a Voltage of 3.3V
Overall test result:

Sheet: 5.3.1
Test Writer: Max Cope
Test Case Name: |  | LED Indication |  |  |  | Test ID #: | 5.3.1
Description: |  | This test is to make sure that the LED indicator is fully functional. |  |  |  | Type: | White Box
Tester Information
Name of Tester: |  |  |  |  |  | Date
Hardware Ver: |  |  |  |  |  | Time
Setup: |  | Board is powered with power supply and set to 5.5 Volts.
Step | Action | Expected Results | Pass | Fail | N/A | Comments
1 | With unit stopped, engage start button. | LED should flash green.
2 | With unit started, engage stop button | LED should flash red.
3 | Attach unit to a computer via USB | LED should display purple.
4 | With User Interface Select a sample time of 1 second then disconnect USB and engage start | LED should flash blue every second to indicate sample taken.
5 | Set power supply voltage to 3V | LED should flash yellow to indicate low battery.
Overall test result:

Sheet: 5.4.1
Test Writer: Max Cope
Test Case Name: |  | Power to and from Sensor Module |  |  |  | Test ID #: | 5.4.1
Description: |  | This test will measure the voltage being supplied to the sensor modules via Ethernet connectivity. It will also measure the return voltage being sent back to the base station. |  |  |  | Type: | Black Box
Tester Information
Name of Tester: |  |  |  |  |  | Date
Hardware Ver: |  |  |  |  |  | Time
Setup: |  | Board is powered and the photocell is connected to the base via Ethernet.
Step | Action | Expected Results | Pass | Fail | N/A | Comments
1 | Measure the Inputted voltage on the sensor module at pin 3 of the Ethernet connector. | A measured Voltage of 5 Volts.
2 | Measure returning sensor voltage on pin 7 of connector with varying levels of light being exposed to the photocell | A changing voltage between 0 and 5 volts with notable response from light exposure to photocell.
Overall test result:

Sheet: 5.4.2
Test Writer: Max Cope
Test Case Name: |  | Start/Stop Button Operation |  |  |  | Test ID #: | 5.4.2
Description: |  | Tests start and stop button's influence on device performance. |  |  |  | Type: | Black Box
Tester Information
Name of Tester: |  |  |  |  |  | Date
Hardware Ver: |  |  |  |  |  | Time
Setup: |  | Board should be fully operational with battery or test bench power.
Step | Action | Expected Results | Pass | Fail | N/A | Comments
1 | With unit in stopped mode, briefly engage start button. | Unit LED should indicate start.
2 | With unit started, briefly engage stop button. | Unit LED should indicate stop.
3 | Unit stopped, engage and hold start button for 5 seconds. | Unit LED should indicate start.
4 | Unit started, engage and hold stop button for 5 seconds. | Unit LED should indicate stop.
5 | Unit started, engage start button. | Unit should not change operation or restart.
6 | Unit started, engage and hold start button for 5 seconds | Unit should not change operation or restart.
7 | Unit stopped, engage start button. | Unit should not change operation or restart.
8 | Unit stopped, engage and hold start button for 5 seconds | Unit should not change operation or restart.
Overall test result:

Sheet: 5.4.3
Test Writer: Max Cope
Test Case Name: |  | USB and User Interface |  |  |  | Test ID #: | 5.4.3
Description: |  | Test module’s ability to both send and receive data between computer and base station via USB. Utilizes User Interface for GUI validation. |  |  |  | Type: | Black Box
Tester Information
Name of Tester: |  |  |  |  |  | Date
Hardware Ver: |  |  |  |  |  | Time
Setup: |  | Board fully powered and a computer loaded with GUI
Step | Action | Expected Results | Pass | Fail | N/A | Comments
1 | With board on and not running, connect base station to computer via USB. | LED Indicator should display Teal
2 | Disconnect USB and engage stop button | LED should stop displaying Teal
3 | With board stopped, connect USB cable with computer. | LED Indicator should display Teal
4 | With USB disconnected, open the Erebus Labs Sensor GUI | GUI window should open and display a "sensor not connected" display.
5 | Connect the base station and computer via USB. Then, engage the connect to Erebus Sensor button on the GUI. | GUI window should display a yellow "Connecting…." indicator then eventually turn green and display "Connected".
6 | Set the Sensor to "Light" with a time interval of 3 seconds and "Apply Settings" in the Sensor dropdown menu. | Popup should display "Update Successful"
7 | Disconnect USB. Connect the light sensor via Ethernet and engage start button. | LED Indicator should display Teal in 3 second increment flashes.
8 | Let sensor run and take samples for 1 minute. Then reconnect the sensor to computer. Once connected select the "Get Data" option from the sensor dropdown. menu. | Data.txt should be created with sampled data stored. Should display the correct sensor used, date, and time of operation.
9
Overall test result:
