erebus-labs/PSU-VOC-SENSOR-2K14/Documents/Timeline_GanttChart.pdf

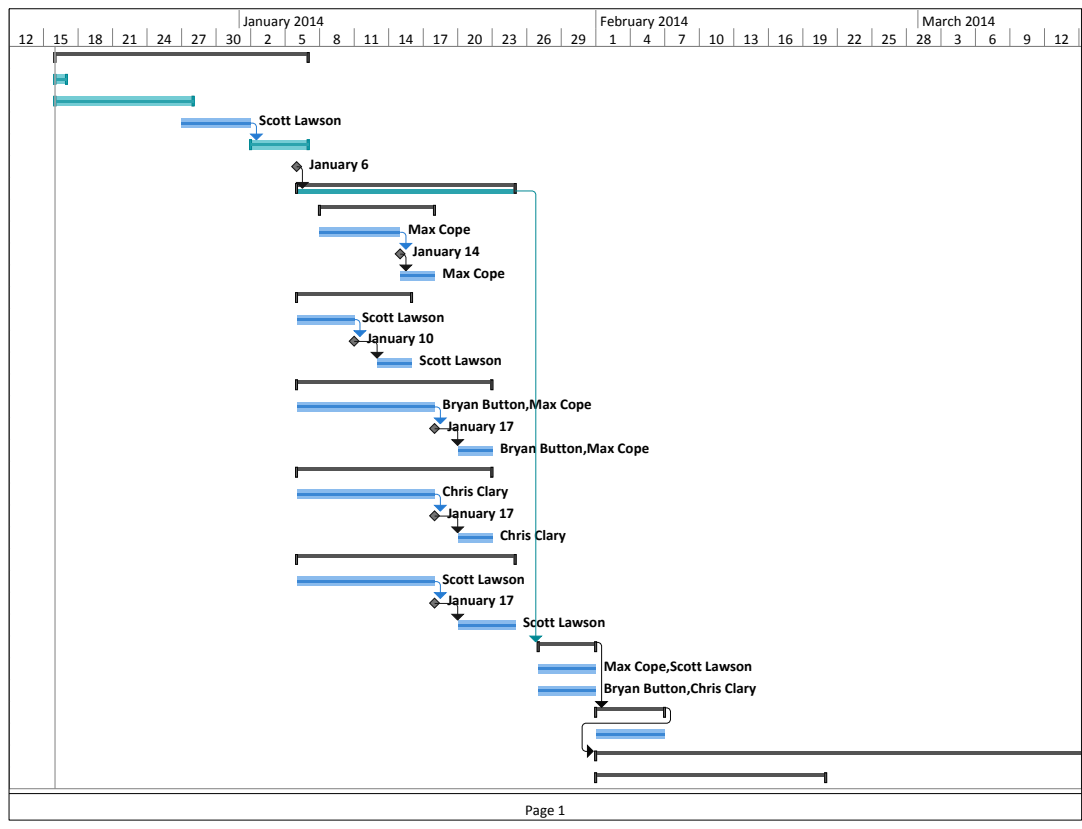
[picture p71: page 1]
Scott Lawson; January 6; Max Cope January 14 Max Cope; Scott Lawson January 10 Scott Lawson; Chris Clary January 17 Chris Clary; Scott Lawson January 17; January 2014; February 2014; March 2014

Bryan Button,Max Cope
January 17

Max Cope,Scott Lawson
Bryan Button,Chris Clary

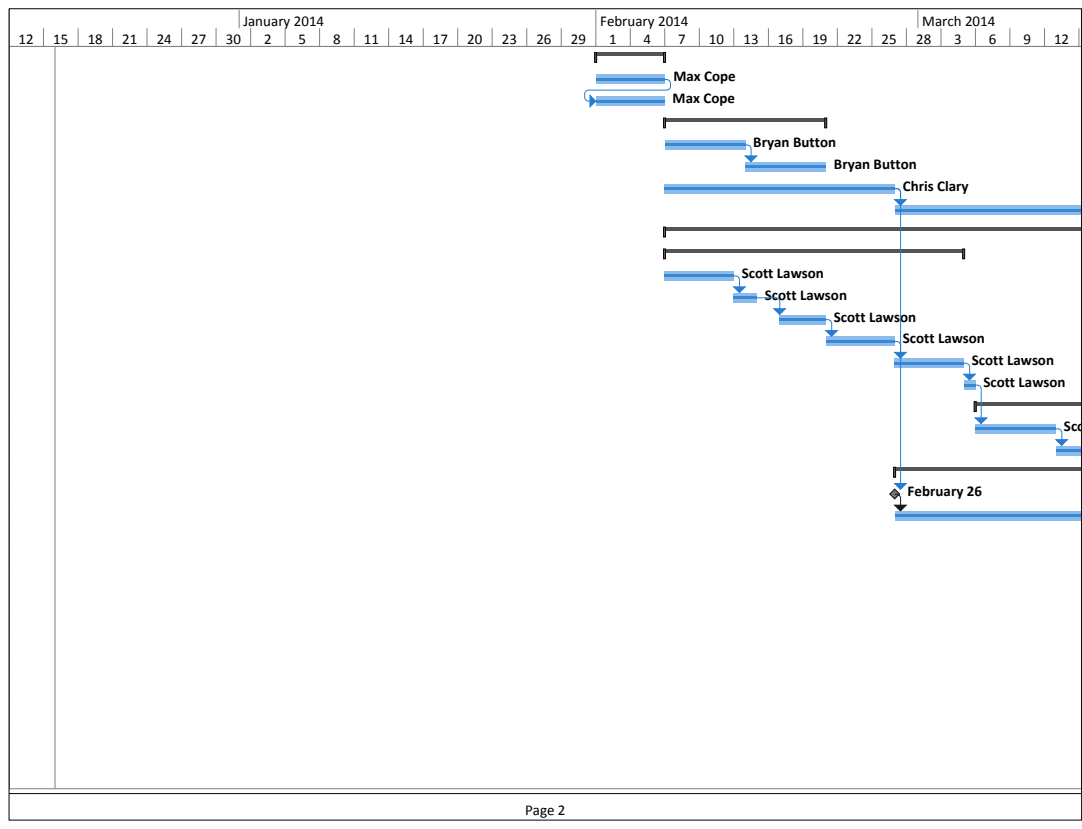
[picture p72: page 2]
Max Cope Max Cope; Bryan Button Bryan Button Chris Clary; Scott Lawson Scott Lawson Scott Lawson Scott Lawson Scott Lawson Scott Lawson; February 26

Scott Lawson,Bryan Button

15 | 18 | 21 | 24 | 27 | 30 | 2 | 5 | 8 | 11 | 14 | 17 | 20 | 23 | 26 | 29 | 2 | 5 | 8 | 11 | 14 | 17 | 20 | 23 | 26 | 29 | 1 | 4 | 7 | 10 | 13
April 2014 | May 2014 | June 2014

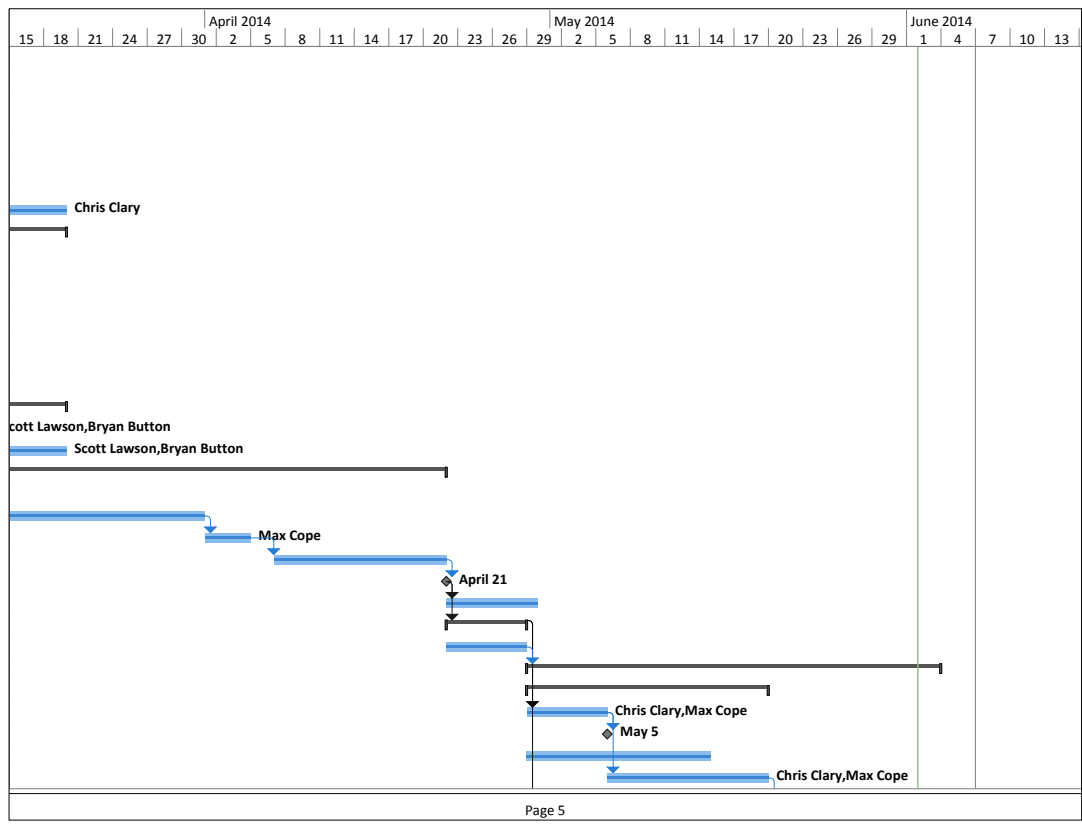
[picture p73: page 5]
Chris Clary; Scott Lawson Scott Lawson; Max Cope; April 21

Scott Lawson,Bryan Button

Chris Clary,Max Cope
May 5

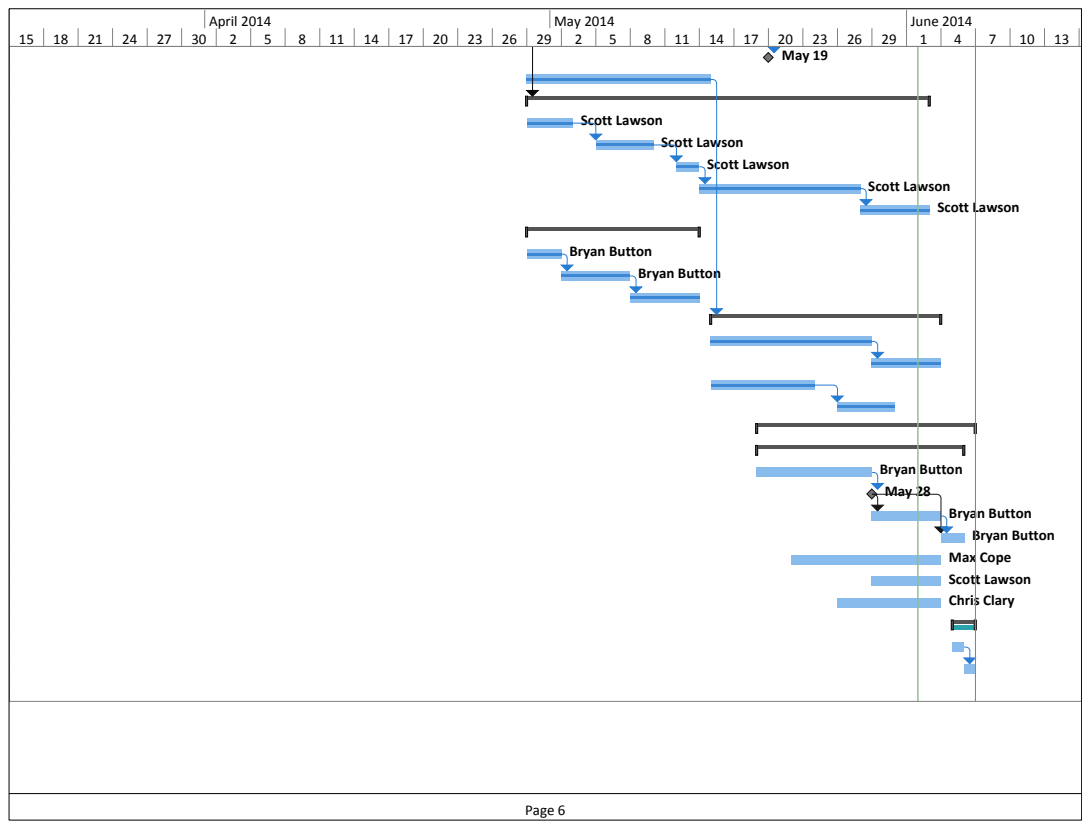
[picture p74: page 6]
Scott Lawson; Bryan Button Bryan Button; Bryan Button May 28; Bryan Button Bryan Button Max Cope Scott Lawson Chris Clary

May 19

Scott Lawson Scott Lawson Scott Lawson

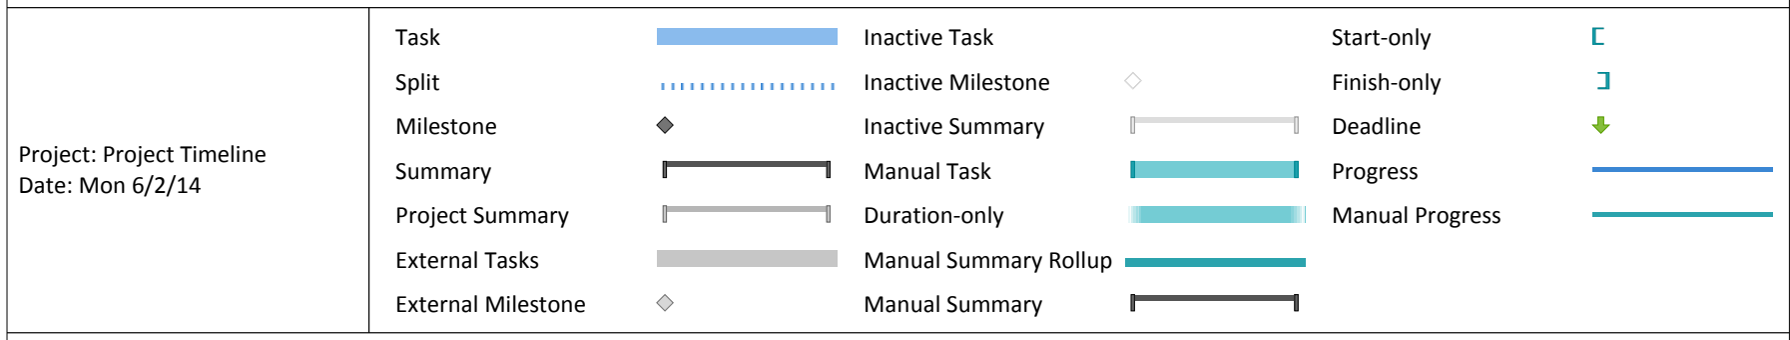
[picture p75: figure]
Task; Split; Milestone; Summary; Project Summary; External Tasks; External Milestone; Inactive Task; Inactive Milestone; Inactive Summary; Manual Task; Duration-only; Manual Summary Rollup; Manual Summary; Start-only; Finish-only; Deadline; Progress; Manual Progress; Project: Project Timeline Date: Mon 6/2/14
