erebus-labs/PSU-VOC-SENSOR-2K14/Schematics/Switching/Main_Board_SW2.pdf

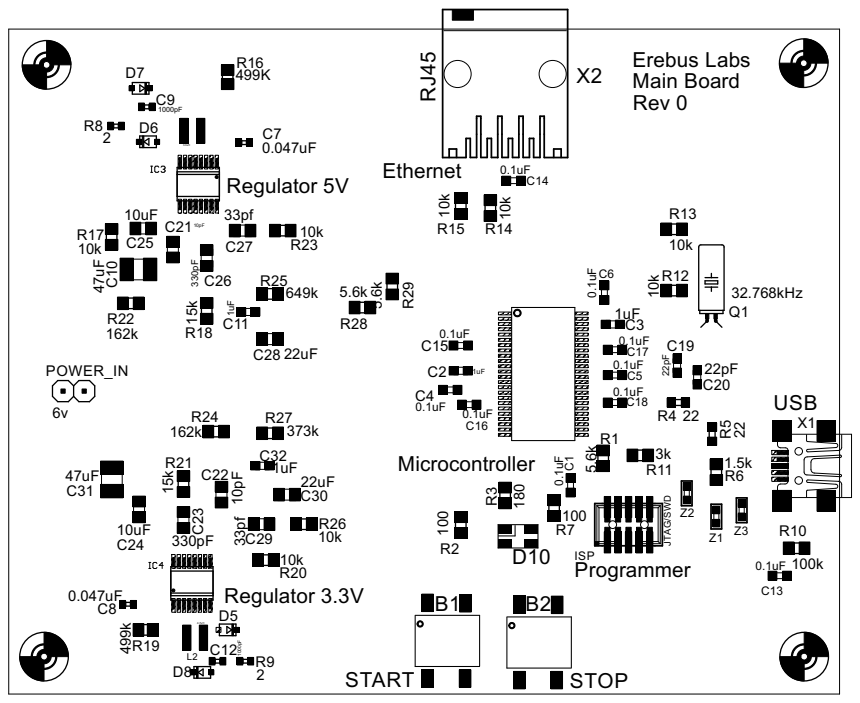
[picture p76: page 1]
