erebus-labs/PSU-VOC-SENSOR-2K14/Schematics/Switcher.asc

10pF: cap; 10pF
330pF: cap; 330pF
C2: cap; 10µF
C3: cap; 33pF
C4: cap; 22µF
C6: cap; 10µF
C7: cap; 33pF
C8: cap; 22µF
C9: cap; 330pF
C10: cap; 10pF
D1: schottky; 1N5817
D2: schottky; 1N5817
D3: schottky; 1N5817
D4: schottky; 1N5817
I1: load2; 500m
I2: load2; 500m
L1: ind; 5.5µH
L2: ind; 5.6µH
R1: res; 200k
R2: res; 10k
R3: res; 15k
R4: res; 649k
R5: res; 162k
R6: res; 200k
R7: res; 10k
R8: res; 15k
R9: res; 373k
R10: res; 162k
R11: res; 10k
R12: res; 10k
U1: LTC3534
U2: LTC3534
V1: voltage; 6
V2: voltage; 6
Named nets: 0, OUT5, OUT
.tran 10m startup
