erebus-labs/PSU-VOC-SENSOR-2K14/Schematics/Gas_Sensor/Gas_Sensor.brd

## EAGLE design Schematics/Gas_Sensor/Gas_Sensor.brd (2014-06-06)

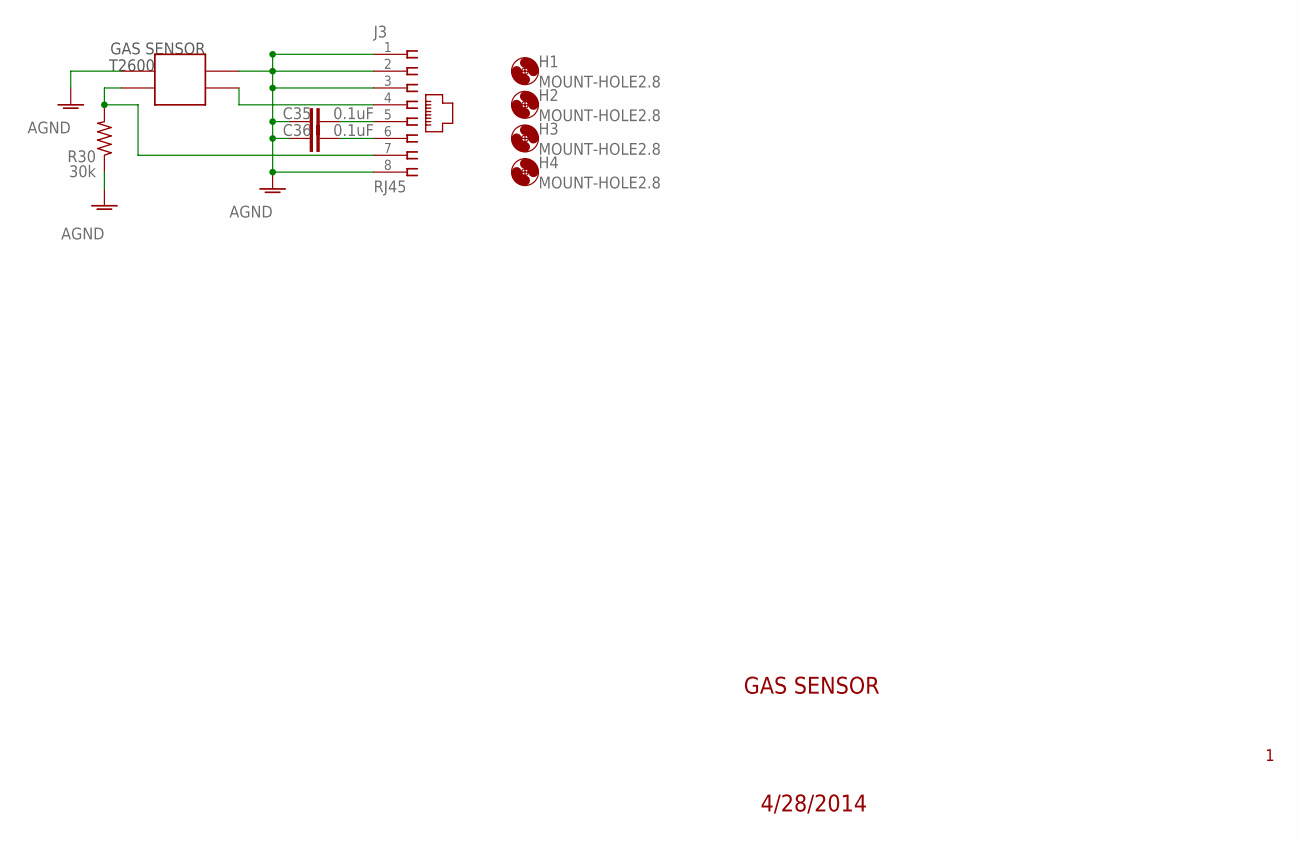
[picture p77: schematic Gas_Sensor.sch]

Parts:
C35, C36: 0.1uF; C0603K
H1, H2, H3, H4: MOUNT-HOLE2.8; 2,8
J3: RJ45; 555167-1
R30: 30k; R1206
X1: GAS_SENSOR

Connections:
AGND: C35.2, C36.2, J3.1, J3.2, J3.3, J3.8, R30.1, X1.P$1, X1.P$2
unnamed: J3.4, X1.P$3
unnamed: J3.7, R30.2, X1.P$4
unnamed: C36.1, J3.6
unnamed: C35.1, J3.5

Notes on the sheet:
GAS SENSOR
T2600
4/28/2014

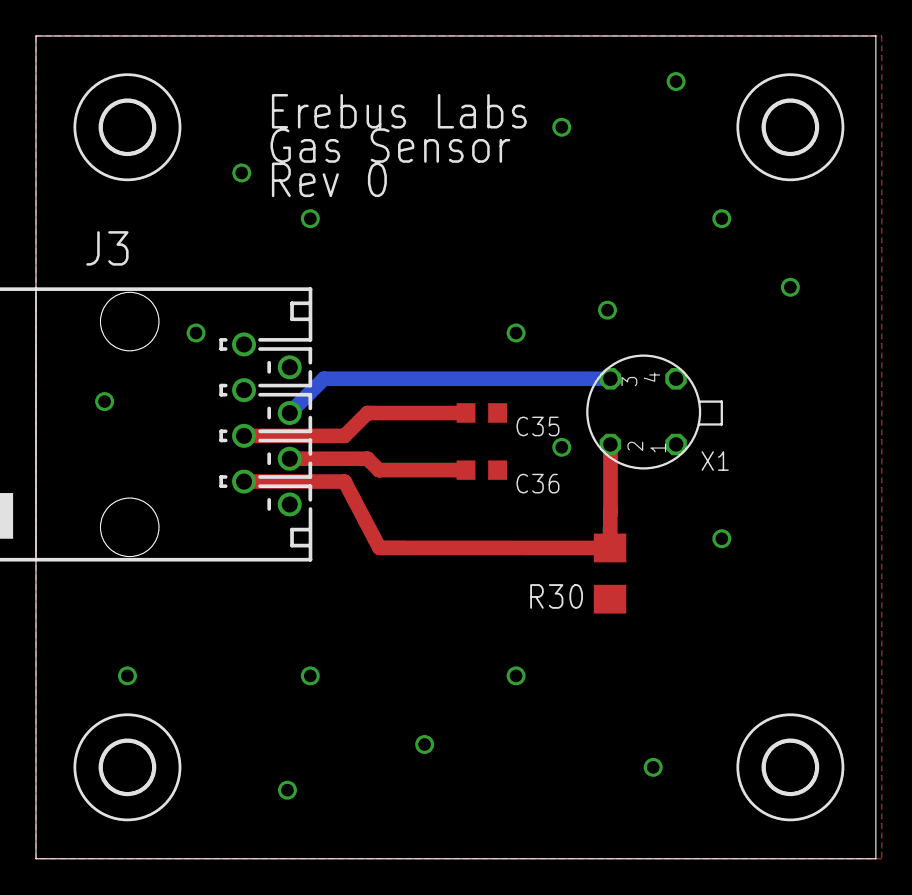
[picture p78: board Gas_Sensor.brd from above]

Board: 2 copper layers, 46.7 x 45.7 mm, 9 parts (0 on the bottom side), 5 nets.
