erebus-labs/PSU-VOC-SENSOR-2K14/Schematics/Ligth_Sensor/Light_Sensor_Layout.brd

## EAGLE design Schematics/Ligth_Sensor/Light_Sensor_Layout.brd (2014-05-26)

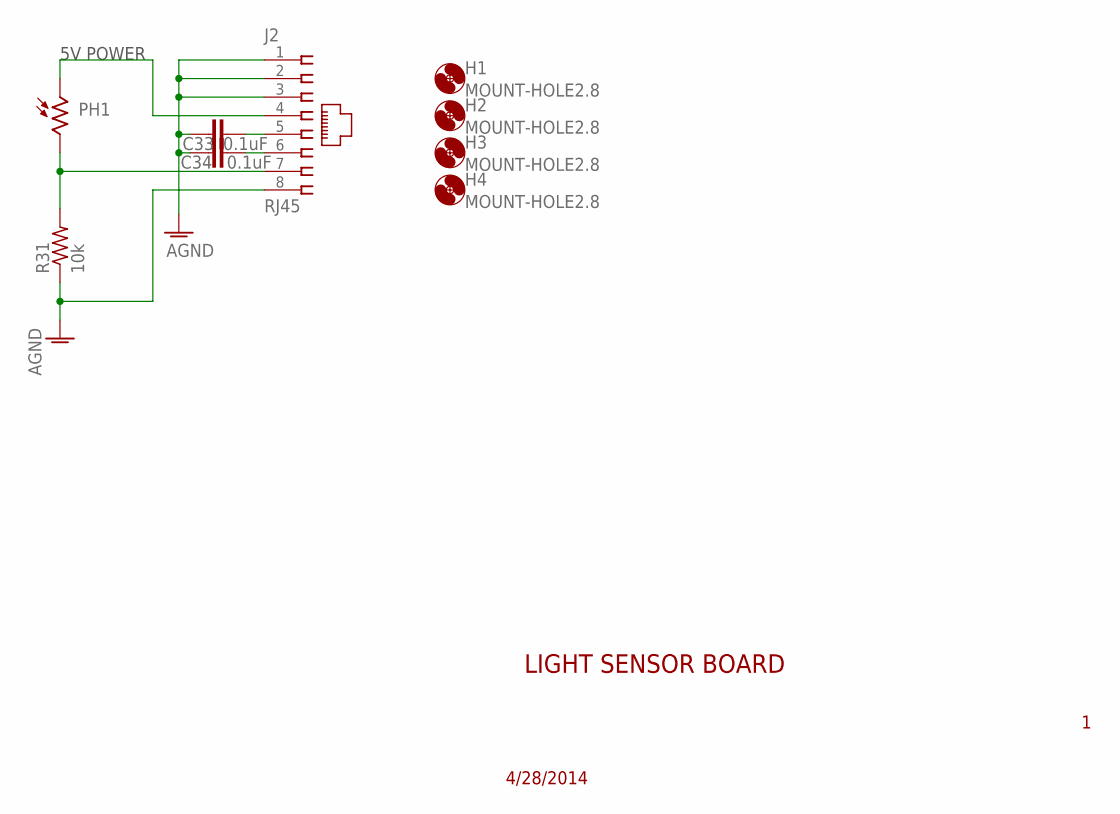
[picture p79: schematic Light_Sensor_Layout.sch]

Parts:
C33, C34: 0.1uF; C0603K
H1, H2, H3, H4: MOUNT-HOLE2.8; 2,8
J2: RJ45; 555167-1
PH1: VT90N2; VT900
R31: 10k; R1206

Connections:
AGND: C33.1, C34.1, J2.1, J2.2, J2.3, J2.8, R31.1
unnamed: J2.4, PH1.1
unnamed: J2.7, PH1.2, R31.2
unnamed: C33.2, J2.5
unnamed: C34.2, J2.6

Notes on the sheet:
5V POWER
LIGHT SENSOR BOARD
4/28/2014

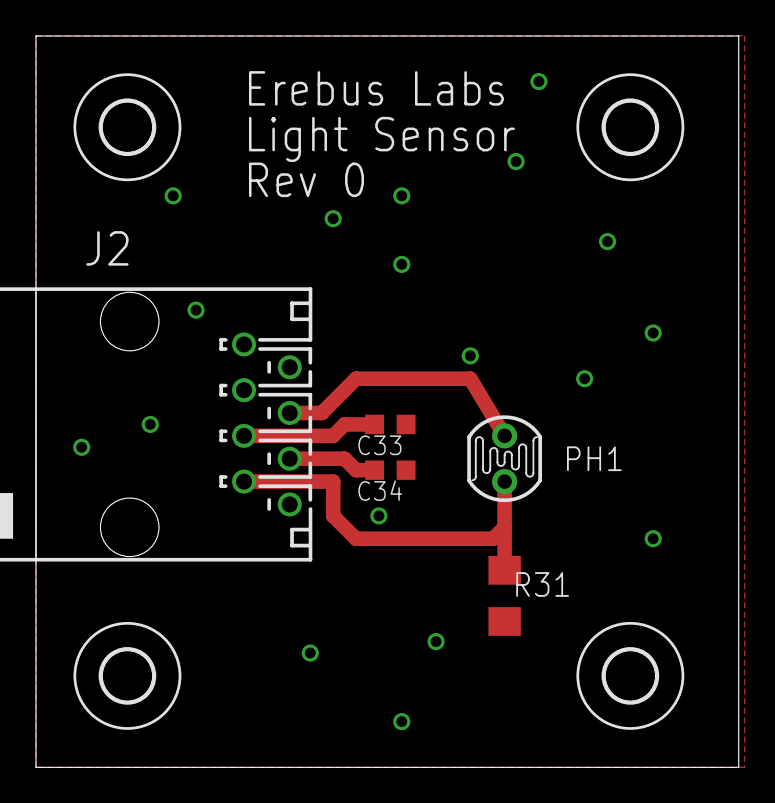
[picture p80: board Light_Sensor_Layout.brd from above]

Board: 2 copper layers, 39.0 x 40.6 mm, 9 parts (0 on the bottom side), 5 nets.
