erebus-labs/PSU-VOC-SENSOR-2K14/Schematics/LDO/LDO.brd

## EAGLE design Schematics/LDO/LDO.brd (2014-05-13)

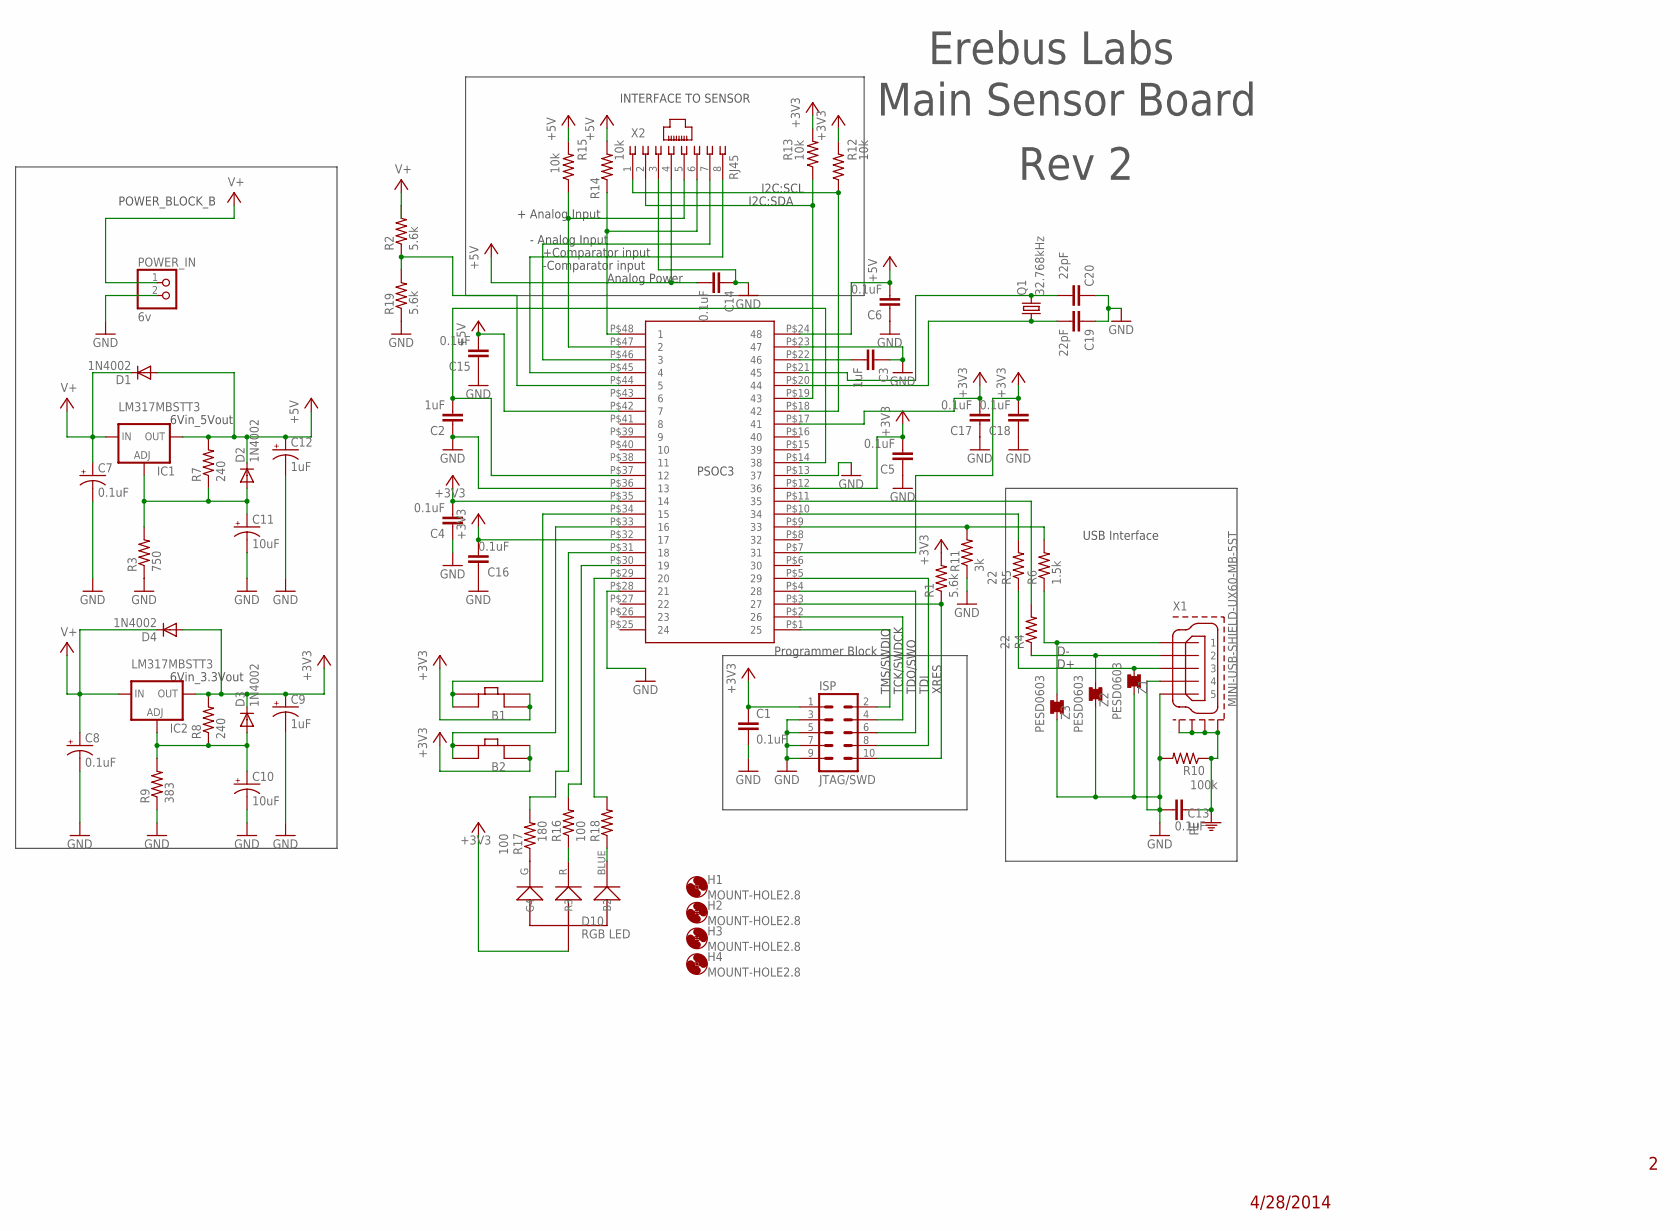
[picture p81: schematic LDO.sch]

Parts:
C1, C4, C5, C6, C13, C14, C15, C16, C17, C18: 0.1uF; C0603K
C2, C3: 1uF; C0603
C7, C8: 0.1uF; E2-5
C9, C12: 1uF; E2-5
C10, C11: 10uF; E2-5
C19, C20: 22pF; C0603
D1, D2, D3, D4: 1N4002; DO41-7.6
D6: RGB_LED
H1, H2, H3, H4: MOUNT-HOLE2.8; 2,8
IC1, IC2: LM317MBSTT3; SOT223
ISP: JTAG/SWD; FTSH-105-01-L-DV-K
POWER_IN: 6v; 1X02
Q1: 32.768kHz; TC38H
R1, R2, R19: 5.6k; R0805
R3: 750; M1206
R4, R5: 22; R0603
R6: 1.5k; R0805
R7, R8: 240; M1206
R9: 383; M1206
R10: 100k; R0805
R11: 3k; R0805
R12, R13, R14, R15: 10k; R0805
R16: 180; R0603
R17, R18: 100; R0603
U$1: PSOC_3_48PIN_SSOP
U$5, U$6: SPST
X1: MINI-USB-SHIELD-UX60-MB-5ST; UX60-MB-5ST
X2: RJ45; 555167-1
Z1, Z2, Z3: PESD0603; SMD-0603

Connections:
+3V3: C1.1, C4.2, C5.2, C9.+, C16.2, C17.2, C18.2, D3.C, D4.A, D6.VCC (VCC1), IC2.4 (OUT), ISP.1, R1.2, R8.2, R12.2, R13.2, U$1.P$7 (31), U$1.P$12 (36), U$1.P$17 (41), U$1.P$32 (17), U$1.P$35 (14), U$5.B1, U$5.B2, U$6.B1, U$6.B2
+5V: C6.2, C12.+, C14.2, C15.2, D1.A, D2.C, IC1.4 (OUT), R7.2, R14.2, R15.2, U$1.P$24 (48), U$1.P$42 (7), X2.4
ANALOGINPUT: U$1.P$46 (3), X2.7
GND: C1.2, C2.1, C3.1, C4.1, C5.1, C6.1, C7.-, C8.-, C9.-, C10.-, C11.-, C12.-, C13.2, C14.1, C15.1, C16.1, C17.1, C18.1, C19.1, C20.1, ISP.3, ISP.5, ISP.7, ISP.9, POWER_IN.2, R3.1, R9.1, R10.2, R11.1, R19.1, U$1.P$13 (37), U$1.P$23 (47), U$1.P$28 (21), U$1.P$36 (13), X1.4, X1.5, X2.3, Z1.1, Z2.1, Z3.1
unnamed: R4.2, U$1.P$11 (35)
unnamed: R5.2, U$1.P$10 (34)
unnamed: R6.2, R11.2, U$1.P$9 (33)
unnamed: ISP.2, U$1.P$1 (25)
unnamed: ISP.4, U$1.P$2 (26)
unnamed: ISP.6, U$1.P$4 (28)
unnamed: ISP.8, U$1.P$5 (29)
unnamed: ISP.10, R1.1, U$1.P$3 (27)
unnamed: C2.2, U$1.P$14 (38), U$1.P$37 (12)
unnamed: C11.+, D2.A, IC1.1 (ADJ), R3.2, R7.1
unnamed: C3.2, U$1.P$22 (46)
unnamed: R2.1, R19.2, U$1.P$44 (5)
unnamed: R5.1, X1.3, Z1.2
unnamed: R4.1, X1.2, Z2.2
unnamed: C10.+, D3.A, IC2.1 (ADJ), R8.1, R9.2
unnamed: C20.2, Q1.2, U$1.P$21 (45)
unnamed: R6.1, X1.1, Z3.2
unnamed: R15.1, U$1.P$47 (2), X2.5
unnamed: R14.1, U$1.P$48 (1), X2.6
unnamed: R13.1, U$1.P$19 (43), X2.2
unnamed: R12.1, U$1.P$18 (42), X2.1
unnamed: C19.2, Q1.1, U$1.P$20 (44)
unnamed: D6.G (G4), R17.1
unnamed: D6.R (R3), R16.1
unnamed: D6.BLUE (B2), R18.1
unnamed: U$1.P$34 (15), U$5.A1, U$5.A2
unnamed: U$1.P$45 (4), X2.8
unnamed: R17.2, U$1.P$31 (18)
unnamed: U$1.P$33 (16), U$6.A1, U$6.A2
unnamed: R16.2, U$1.P$30 (19)
unnamed: R18.2, U$1.P$29 (20)
PE: C13.1, R10.1, X1.M1 (GND1), X1.M2 (GND2), X1.M3 (GND3), X1.M4 (GND4)
V+: C7.+, C8.+, D1.C, D4.C, IC1.3 (IN), IC2.3 (IN), POWER_IN.1, R2.2

Notes on the sheet:
PSOC3
TMS/SWDIO
TCK/SWDCK
TDO/SWO
TDI
XRES
Programmer Block
POWER_BLOCK_B
6Vin_5Vout
6Vin_3.3Vout
INTERFACE TO SENSOR
USB Interface
+Comparator input
-Comparator input
- Analog Input
I2C:SCL
I2C:SDA
Erebus Labs
Main Sensor Board
Rev 2
Analog Power
+ Analog Input
4/28/2014
D10
RGB LED

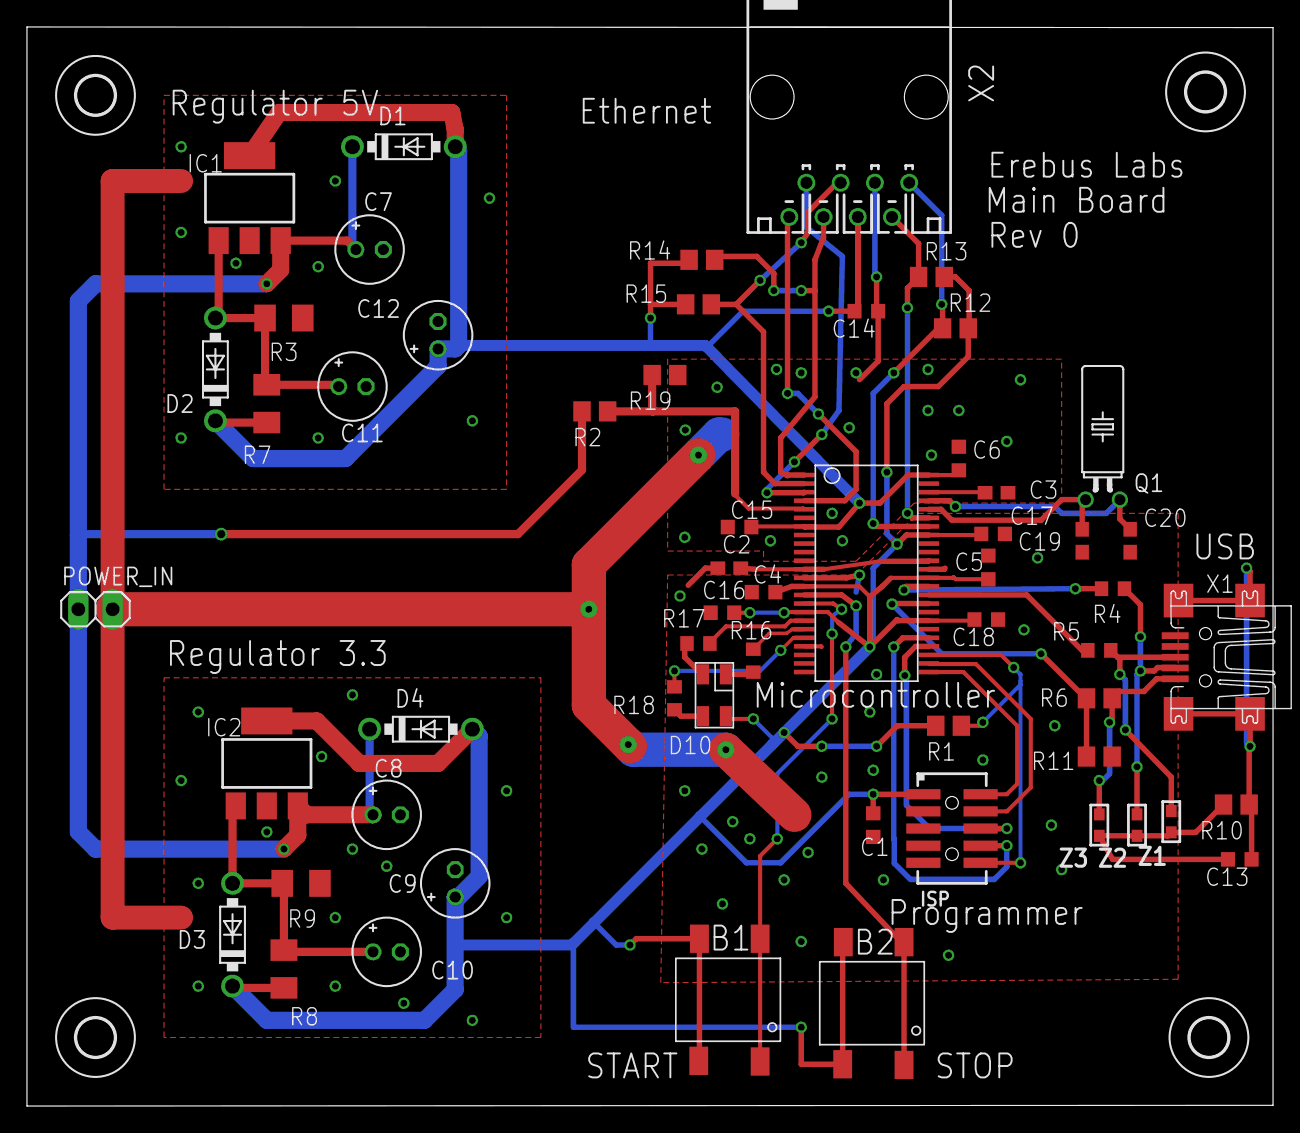
[picture p82: board LDO.brd from above]

Board: 2 copper layers, 92.4 x 80.0 mm, 61 parts (0 on the bottom side), 37 nets.
