erebus-labs/PSU-VOC-SENSOR-2K14/Code/master_pcb/Erebus_Sensor.cydsn/codegentemp/PWM0_CTRL.c

/*******************************************************************************
* File Name: PWM0_CTRL.c  
* Version 1.70
*
* Description:
*  This file contains API to enable firmware control of a Control Register.
*
* Note:
*
********************************************************************************
* Copyright 2008-2012, Cypress Semiconductor Corporation.  All rights reserved.
* You may use this file only in accordance with the license, terms, conditions, 
* disclaimers, and limitations in the end user license agreement accompanying 
* the software package with which this file was provided.
*******************************************************************************/

#include "PWM0_CTRL.h"

#if !defined(PWM0_CTRL_Sync_ctrl_reg__REMOVED) /* Check for removal by optimization */

/*******************************************************************************
* Function Name: PWM0_CTRL_Write
********************************************************************************
*
* Summary:
*  Write a byte to the Control Register.
*
* Parameters:
*  control:  The value to be assigned to the Control Register.
*
* Return:
*  None.
*
*******************************************************************************/
void PWM0_CTRL_Write(uint8 control) 
{
    PWM0_CTRL_Control = control;
}


/*******************************************************************************
* Function Name: PWM0_CTRL_Read
********************************************************************************
*
* Summary:
*  Reads the current value assigned to the Control Register.
*
* Parameters:
*  None.
*
* Return:
*  Returns the current value in the Control Register.
*
*******************************************************************************/
uint8 PWM0_CTRL_Read(void) 
{
    return PWM0_CTRL_Control;
}

#endif /* End check for removal by optimization */


/* [] END OF FILE */
