erebus-labs/PSU-VOC-SENSOR-2K14/Code/master_pcb/Erebus_Sensor.cydsn/codegentemp/USBUART.h

/*******************************************************************************
* File Name: USBUART.h
* Version 2.60
*
* Description:
*  Header File for the USFS component. Contains prototypes and constant values.
*
********************************************************************************
* Copyright 2008-2013, Cypress Semiconductor Corporation.  All rights reserved.
* You may use this file only in accordance with the license, terms, conditions,
* disclaimers, and limitations in the end user license agreement accompanying
* the software package with which this file was provided.
*******************************************************************************/

#if !defined(CY_USBFS_USBUART_H)
#define CY_USBFS_USBUART_H

#include "cytypes.h"
#include "cydevice_trm.h"
#include "cyfitter.h"
#include "CyLib.h"


/***************************************
* Conditional Compilation Parameters
***************************************/

/* Check to see if required defines such as CY_PSOC5LP are available */
/* They are defined starting with cy_boot v3.0 */
#if !defined (CY_PSOC5LP)
    #error Component USBFS_v2_60 requires cy_boot v3.0 or later
#endif /* (CY_PSOC5LP) */


/***************************************
*  Memory Type Definitions
***************************************/

/* Renamed Type Definitions for backward compatibility.
*  Should not be used in new designs.
*/
#define USBUART_CODE CYCODE
#define USBUART_FAR CYFAR
#if defined(__C51__) || defined(__CX51__)
    #define USBUART_DATA data
    #define USBUART_XDATA xdata
#else
    #define USBUART_DATA
    #define USBUART_XDATA
#endif /* End __C51__ */
#define USBUART_NULL       NULL


/***************************************
* Enumerated Types and Parameters
***************************************/

#define USBUART__EP_MANUAL 0
#define USBUART__EP_DMAMANUAL 1
#define USBUART__EP_DMAAUTO 2

#define USBUART__MA_STATIC 0
#define USBUART__MA_DYNAMIC 1



/***************************************
*    Initial Parameter Constants
***************************************/

#define USBUART_NUM_DEVICES   (1u)
#define USBUART_ENABLE_CDC_CLASS   
#define USBUART_ENABLE_DESCRIPTOR_STRINGS   
#define USBUART_ENABLE_MSOS_STRING   
#define USBUART_ENABLE_SN_STRING   
#define USBUART_ENABLE_IDSN_STRING   
#define USBUART_ENABLE_STRINGS   
#define USBUART_MAX_REPORTID_NUMBER   (0u)

#define USBUART_MON_VBUS                       (0u)
#define USBUART_EXTERN_VBUS                    (0u)
#define USBUART_EXTERN_VND                     (0u)
#define USBUART_EXTERN_CLS                     (0u)
#define USBUART_MAX_INTERFACES_NUMBER          (2u)
#define USBUART_EP0_ISR_REMOVE                 (0u)
#define USBUART_EP1_ISR_REMOVE                 (0u)
#define USBUART_EP2_ISR_REMOVE                 (0u)
#define USBUART_EP3_ISR_REMOVE                 (0u)
#define USBUART_EP4_ISR_REMOVE                 (1u)
#define USBUART_EP5_ISR_REMOVE                 (1u)
#define USBUART_EP6_ISR_REMOVE                 (1u)
#define USBUART_EP7_ISR_REMOVE                 (1u)
#define USBUART_EP8_ISR_REMOVE                 (1u)
#define USBUART_EP_MM                          (0u)
#define USBUART_EP_MA                          (0u)
#define USBUART_DMA1_REMOVE                    (1u)
#define USBUART_DMA2_REMOVE                    (1u)
#define USBUART_DMA3_REMOVE                    (1u)
#define USBUART_DMA4_REMOVE                    (1u)
#define USBUART_DMA5_REMOVE                    (1u)
#define USBUART_DMA6_REMOVE                    (1u)
#define USBUART_DMA7_REMOVE                    (1u)
#define USBUART_DMA8_REMOVE                    (1u)
#define USBUART_SOF_ISR_REMOVE                 (0u)
#define USBUART_ARB_ISR_REMOVE                 (0u)
#define USBUART_DP_ISR_REMOVE                  (0u)
#define USBUART_ENABLE_CDC_CLASS_API           (1u)
#define USBUART_ENABLE_MIDI_API                (1u)
#define USBUART_MIDI_EXT_MODE                  (0u)


/***************************************
*    Data Struct Definition
***************************************/

typedef struct
{
    uint8  attrib;
    uint8  apiEpState;
    uint8  hwEpState;
    uint8  epToggle;
    uint8  addr;
    uint8  epMode;
    uint16 buffOffset;
    uint16 bufferSize;
    uint8  interface;
} T_USBUART_EP_CTL_BLOCK;

typedef struct
{
    uint8  interface;
    uint8  altSetting;
    uint8  addr;
    uint8  attributes;
    uint16 bufferSize;
    uint8  bMisc;
} T_USBUART_EP_SETTINGS_BLOCK;

typedef struct
{
    uint8  status;
    uint16 length;
} T_USBUART_XFER_STATUS_BLOCK;

typedef struct
{
    uint16  count;
    volatile uint8 *pData;
    T_USBUART_XFER_STATUS_BLOCK *pStatusBlock;
} T_USBUART_TD;


typedef struct
{
    uint8   c;
    const void *p_list;
} T_USBUART_LUT;

/* Resume/Suspend API Support */
typedef struct
{
    uint8 enableState;
    uint8 mode;
} USBUART_BACKUP_STRUCT;


/* Renamed structure fields for backward compatibility.
*  Should not be used in new designs.
*/
#define wBuffOffset         buffOffset
#define wBufferSize         bufferSize
#define bStatus             status
#define wLength             length
#define wCount              count

/* Renamed global variable for backward compatibility.
*  Should not be used in new designs.
*/
#define CurrentTD           USBUART_currentTD


/***************************************
*       Function Prototypes
***************************************/

void   USBUART_Start(uint8 device, uint8 mode) ;
void   USBUART_Init(void) ;
void   USBUART_InitComponent(uint8 device, uint8 mode) ;
void   USBUART_Stop(void) ;
uint8  USBUART_CheckActivity(void) ;
uint8  USBUART_GetConfiguration(void) ;
uint8  USBUART_IsConfigurationChanged(void) ;
uint8  USBUART_GetInterfaceSetting(uint8 interfaceNumber)
                                                        ;
uint8  USBUART_GetEPState(uint8 epNumber) ;
uint16 USBUART_GetEPCount(uint8 epNumber) ;
void   USBUART_LoadInEP(uint8 epNumber, const uint8 pData[], uint16 length)
                                                                    ;
uint16 USBUART_ReadOutEP(uint8 epNumber, uint8 pData[], uint16 length)
                                                                    ;
void   USBUART_EnableOutEP(uint8 epNumber) ;
void   USBUART_DisableOutEP(uint8 epNumber) ;
void   USBUART_Force(uint8 bState) ;
uint8  USBUART_GetEPAckState(uint8 epNumber) ;
void   USBUART_SetPowerStatus(uint8 powerStatus) ;
uint8  USBUART_RWUEnabled(void) ;
void   USBUART_TerminateEP(uint8 ep) ;

void   USBUART_Suspend(void) ;
void   USBUART_Resume(void) ;

#if defined(USBUART_ENABLE_FWSN_STRING)
    void   USBUART_SerialNumString(uint8 snString[]) ;
#endif  /* USBUART_ENABLE_FWSN_STRING */
#if (USBUART_MON_VBUS == 1u)
    uint8  USBUART_VBusPresent(void) ;
#endif /* End USBUART_MON_VBUS */

#if defined(CYDEV_BOOTLOADER_IO_COMP) && ((CYDEV_BOOTLOADER_IO_COMP == CyBtldr_USBUART) || \
                                          (CYDEV_BOOTLOADER_IO_COMP == CyBtldr_Custom_Interface))

    void USBUART_CyBtldrCommStart(void) ;
    void USBUART_CyBtldrCommStop(void) ;
    void USBUART_CyBtldrCommReset(void) ;
    cystatus USBUART_CyBtldrCommWrite(uint8 *pData, uint16 size, uint16 *count, uint8 timeOut) CYSMALL
                                                        ;
    cystatus USBUART_CyBtldrCommRead( uint8 *pData, uint16 size, uint16 *count, uint8 timeOut) CYSMALL
                                                        ;

    #define USBUART_BTLDR_SIZEOF_WRITE_BUFFER      (64u)    /* EP 1 OUT */
    #define USBUART_BTLDR_SIZEOF_READ_BUFFER       (64u)    /* EP 2 IN */
    #define USBUART_BTLDR_MAX_PACKET_SIZE          USBUART_BTLDR_SIZEOF_WRITE_BUFFER

    /* These defines active if used USBFS interface as an
    *  IO Component for bootloading. When Custom_Interface selected
    *  in Bootloder configuration as the IO Component, user must
    *  provide these functions
    */
    #if (CYDEV_BOOTLOADER_IO_COMP == CyBtldr_USBUART)
        #define CyBtldrCommStart        USBUART_CyBtldrCommStart
        #define CyBtldrCommStop         USBUART_CyBtldrCommStop
        #define CyBtldrCommReset        USBUART_CyBtldrCommReset
        #define CyBtldrCommWrite        USBUART_CyBtldrCommWrite
        #define CyBtldrCommRead         USBUART_CyBtldrCommRead
    #endif  /*End   CYDEV_BOOTLOADER_IO_COMP == CyBtldr_USBUART */

#endif /* End CYDEV_BOOTLOADER_IO_COMP  */

#if(USBUART_EP_MM != USBUART__EP_MANUAL)
    void USBUART_InitEP_DMA(uint8 epNumber, const uint8 *pData)
                                                    ;
    void USBUART_Stop_DMA(uint8 epNumber) ;
#endif /* End USBUART_EP_MM != USBUART__EP_MANUAL) */

#if defined(USBUART_ENABLE_MIDI_STREAMING) && (USBUART_ENABLE_MIDI_API != 0u)
    void USBUART_MIDI_EP_Init(void) ;

    #if (USBUART_MIDI_IN_BUFF_SIZE > 0)
        void USBUART_MIDI_IN_Service(void) ;
        uint8 USBUART_PutUsbMidiIn(uint8 ic, const uint8 midiMsg[], uint8 cable)
                                                                ;
    #endif /* USBUART_MIDI_IN_BUFF_SIZE > 0 */

    #if (USBUART_MIDI_OUT_BUFF_SIZE > 0)
        void USBUART_MIDI_OUT_EP_Service(void) ;
    #endif /* USBUART_MIDI_OUT_BUFF_SIZE > 0 */

#endif /* End USBUART_ENABLE_MIDI_API != 0u */

/* Renamed Functions for backward compatibility.
*  Should not be used in new designs.
*/

#define USBUART_bCheckActivity             USBUART_CheckActivity
#define USBUART_bGetConfiguration          USBUART_GetConfiguration
#define USBUART_bGetInterfaceSetting       USBUART_GetInterfaceSetting
#define USBUART_bGetEPState                USBUART_GetEPState
#define USBUART_wGetEPCount                USBUART_GetEPCount
#define USBUART_bGetEPAckState             USBUART_GetEPAckState
#define USBUART_bRWUEnabled                USBUART_RWUEnabled
#define USBUART_bVBusPresent               USBUART_VBusPresent

#define USBUART_bConfiguration             USBUART_configuration
#define USBUART_bInterfaceSetting          USBUART_interfaceSetting
#define USBUART_bDeviceAddress             USBUART_deviceAddress
#define USBUART_bDeviceStatus              USBUART_deviceStatus
#define USBUART_bDevice                    USBUART_device
#define USBUART_bTransferState             USBUART_transferState
#define USBUART_bLastPacketSize            USBUART_lastPacketSize

#define USBUART_LoadEP                     USBUART_LoadInEP
#define USBUART_LoadInISOCEP               USBUART_LoadInEP
#define USBUART_EnableOutISOCEP            USBUART_EnableOutEP

#define USBUART_SetVector                  CyIntSetVector
#define USBUART_SetPriority                CyIntSetPriority
#define USBUART_EnableInt                  CyIntEnable


/***************************************
*          API Constants
***************************************/

#define USBUART_EP0                        (0u)
#define USBUART_EP1                        (1u)
#define USBUART_EP2                        (2u)
#define USBUART_EP3                        (3u)
#define USBUART_EP4                        (4u)
#define USBUART_EP5                        (5u)
#define USBUART_EP6                        (6u)
#define USBUART_EP7                        (7u)
#define USBUART_EP8                        (8u)
#define USBUART_MAX_EP                     (9u)

#define USBUART_TRUE                       (1u)
#define USBUART_FALSE                      (0u)

#define USBUART_NO_EVENT_ALLOWED           (2u)
#define USBUART_EVENT_PENDING              (1u)
#define USBUART_NO_EVENT_PENDING           (0u)

#define USBUART_IN_BUFFER_FULL             USBUART_NO_EVENT_PENDING
#define USBUART_IN_BUFFER_EMPTY            USBUART_EVENT_PENDING
#define USBUART_OUT_BUFFER_FULL            USBUART_EVENT_PENDING
#define USBUART_OUT_BUFFER_EMPTY           USBUART_NO_EVENT_PENDING

#define USBUART_FORCE_J                    (0xA0u)
#define USBUART_FORCE_K                    (0x80u)
#define USBUART_FORCE_SE0                  (0xC0u)
#define USBUART_FORCE_NONE                 (0x00u)

#define USBUART_IDLE_TIMER_RUNNING         (0x02u)
#define USBUART_IDLE_TIMER_EXPIRED         (0x01u)
#define USBUART_IDLE_TIMER_INDEFINITE      (0x00u)

#define USBUART_DEVICE_STATUS_BUS_POWERED  (0x00u)
#define USBUART_DEVICE_STATUS_SELF_POWERED (0x01u)

#define USBUART_3V_OPERATION               (0x00u)
#define USBUART_5V_OPERATION               (0x01u)
#define USBUART_DWR_VDDD_OPERATION         (0x02u)

#define USBUART_MODE_DISABLE               (0x00u)
#define USBUART_MODE_NAK_IN_OUT            (0x01u)
#define USBUART_MODE_STATUS_OUT_ONLY       (0x02u)
#define USBUART_MODE_STALL_IN_OUT          (0x03u)
#define USBUART_MODE_RESERVED_0100         (0x04u)
#define USBUART_MODE_ISO_OUT               (0x05u)
#define USBUART_MODE_STATUS_IN_ONLY        (0x06u)
#define USBUART_MODE_ISO_IN                (0x07u)
#define USBUART_MODE_NAK_OUT               (0x08u)
#define USBUART_MODE_ACK_OUT               (0x09u)
#define USBUART_MODE_RESERVED_1010         (0x0Au)
#define USBUART_MODE_ACK_OUT_STATUS_IN     (0x0Bu)
#define USBUART_MODE_NAK_IN                (0x0Cu)
#define USBUART_MODE_ACK_IN                (0x0Du)
#define USBUART_MODE_RESERVED_1110         (0x0Eu)
#define USBUART_MODE_ACK_IN_STATUS_OUT     (0x0Fu)
#define USBUART_MODE_MASK                  (0x0Fu)
#define USBUART_MODE_STALL_DATA_EP         (0x80u)

#define USBUART_MODE_ACKD                  (0x10u)
#define USBUART_MODE_OUT_RCVD              (0x20u)
#define USBUART_MODE_IN_RCVD               (0x40u)
#define USBUART_MODE_SETUP_RCVD            (0x80u)

#define USBUART_RQST_TYPE_MASK             (0x60u)
#define USBUART_RQST_TYPE_STD              (0x00u)
#define USBUART_RQST_TYPE_CLS              (0x20u)
#define USBUART_RQST_TYPE_VND              (0x40u)
#define USBUART_RQST_DIR_MASK              (0x80u)
#define USBUART_RQST_DIR_D2H               (0x80u)
#define USBUART_RQST_DIR_H2D               (0x00u)
#define USBUART_RQST_RCPT_MASK             (0x03u)
#define USBUART_RQST_RCPT_DEV              (0x00u)
#define USBUART_RQST_RCPT_IFC              (0x01u)
#define USBUART_RQST_RCPT_EP               (0x02u)
#define USBUART_RQST_RCPT_OTHER            (0x03u)

/* USB Class Codes */
#define USBUART_CLASS_DEVICE               (0x00u)     /* Use class code info from Interface Descriptors */
#define USBUART_CLASS_AUDIO                (0x01u)     /* Audio device */
#define USBUART_CLASS_CDC                  (0x02u)     /* Communication device class */
#define USBUART_CLASS_HID                  (0x03u)     /* Human Interface Device */
#define USBUART_CLASS_PDC                  (0x05u)     /* Physical device class */
#define USBUART_CLASS_IMAGE                (0x06u)     /* Still Imaging device */
#define USBUART_CLASS_PRINTER              (0x07u)     /* Printer device  */
#define USBUART_CLASS_MSD                  (0x08u)     /* Mass Storage device  */
#define USBUART_CLASS_HUB                  (0x09u)     /* Full/Hi speed Hub */
#define USBUART_CLASS_CDC_DATA             (0x0Au)     /* CDC data device */
#define USBUART_CLASS_SMART_CARD           (0x0Bu)     /* Smart Card device */
#define USBUART_CLASS_CSD                  (0x0Du)     /* Content Security device */
#define USBUART_CLASS_VIDEO                (0x0Eu)     /* Video device */
#define USBUART_CLASS_PHD                  (0x0Fu)     /* Personal Healthcare device */
#define USBUART_CLASS_WIRELESSD            (0xDCu)     /* Wireless Controller */
#define USBUART_CLASS_MIS                  (0xE0u)     /* Miscellaneous */
#define USBUART_CLASS_APP                  (0xEFu)     /* Application Specific */
#define USBUART_CLASS_VENDOR               (0xFFu)     /* Vendor specific */


/* Standard Request Types (Table 9-4) */
#define USBUART_GET_STATUS                 (0x00u)
#define USBUART_CLEAR_FEATURE              (0x01u)
#define USBUART_SET_FEATURE                (0x03u)
#define USBUART_SET_ADDRESS                (0x05u)
#define USBUART_GET_DESCRIPTOR             (0x06u)
#define USBUART_SET_DESCRIPTOR             (0x07u)
#define USBUART_GET_CONFIGURATION          (0x08u)
#define USBUART_SET_CONFIGURATION          (0x09u)
#define USBUART_GET_INTERFACE              (0x0Au)
#define USBUART_SET_INTERFACE              (0x0Bu)
#define USBUART_SYNCH_FRAME                (0x0Cu)

/* Vendor Specific Request Types */
/* Request for Microsoft OS String Descriptor */
#define USBUART_GET_EXTENDED_CONFIG_DESCRIPTOR (0x01u)

/* Descriptor Types (Table 9-5) */
#define USBUART_DESCR_DEVICE                   (1u)
#define USBUART_DESCR_CONFIG                   (2u)
#define USBUART_DESCR_STRING                   (3u)
#define USBUART_DESCR_INTERFACE                (4u)
#define USBUART_DESCR_ENDPOINT                 (5u)
#define USBUART_DESCR_DEVICE_QUALIFIER         (6u)
#define USBUART_DESCR_OTHER_SPEED              (7u)
#define USBUART_DESCR_INTERFACE_POWER          (8u)

/* Device Descriptor Defines */
#define USBUART_DEVICE_DESCR_LENGTH            (18u)
#define USBUART_DEVICE_DESCR_SN_SHIFT          (16u)

/* Config Descriptor Shifts and Masks */
#define USBUART_CONFIG_DESCR_LENGTH                (0u)
#define USBUART_CONFIG_DESCR_TYPE                  (1u)
#define USBUART_CONFIG_DESCR_TOTAL_LENGTH_LOW      (2u)
#define USBUART_CONFIG_DESCR_TOTAL_LENGTH_HI       (3u)
#define USBUART_CONFIG_DESCR_NUM_INTERFACES        (4u)
#define USBUART_CONFIG_DESCR_CONFIG_VALUE          (5u)
#define USBUART_CONFIG_DESCR_CONFIGURATION         (6u)
#define USBUART_CONFIG_DESCR_ATTRIB                (7u)
#define USBUART_CONFIG_DESCR_ATTRIB_SELF_POWERED   (0x40u)
#define USBUART_CONFIG_DESCR_ATTRIB_RWU_EN         (0x20u)

/* Feature Selectors (Table 9-6) */
#define USBUART_DEVICE_REMOTE_WAKEUP           (0x01u)
#define USBUART_ENDPOINT_HALT                  (0x00u)
#define USBUART_TEST_MODE                      (0x02u)

/* USB Device Status (Figure 9-4) */
#define USBUART_DEVICE_STATUS_BUS_POWERED      (0x00u)
#define USBUART_DEVICE_STATUS_SELF_POWERED     (0x01u)
#define USBUART_DEVICE_STATUS_REMOTE_WAKEUP    (0x02u)

/* USB Endpoint Status (Figure 9-4) */
#define USBUART_ENDPOINT_STATUS_HALT           (0x01u)

/* USB Endpoint Directions */
#define USBUART_DIR_IN                         (0x80u)
#define USBUART_DIR_OUT                        (0x00u)
#define USBUART_DIR_UNUSED                     (0x7Fu)

/* USB Endpoint Attributes */
#define USBUART_EP_TYPE_CTRL                   (0x00u)
#define USBUART_EP_TYPE_ISOC                   (0x01u)
#define USBUART_EP_TYPE_BULK                   (0x02u)
#define USBUART_EP_TYPE_INT                    (0x03u)
#define USBUART_EP_TYPE_MASK                   (0x03u)

#define USBUART_EP_SYNC_TYPE_NO_SYNC           (0x00u)
#define USBUART_EP_SYNC_TYPE_ASYNC             (0x04u)
#define USBUART_EP_SYNC_TYPE_ADAPTIVE          (0x08u)
#define USBUART_EP_SYNC_TYPE_SYNCHRONOUS       (0x0Cu)
#define USBUART_EP_SYNC_TYPE_MASK              (0x0Cu)

#define USBUART_EP_USAGE_TYPE_DATA             (0x00u)
#define USBUART_EP_USAGE_TYPE_FEEDBACK         (0x10u)
#define USBUART_EP_USAGE_TYPE_IMPLICIT         (0x20u)
#define USBUART_EP_USAGE_TYPE_RESERVED         (0x30u)
#define USBUART_EP_USAGE_TYPE_MASK             (0x30u)

/* Endpoint Status defines */
#define USBUART_EP_STATUS_LENGTH               (0x02u)

/* Endpoint Device defines */
#define USBUART_DEVICE_STATUS_LENGTH           (0x02u)

#define USBUART_STATUS_LENGTH_MAX \
                 ( (USBUART_EP_STATUS_LENGTH > USBUART_DEVICE_STATUS_LENGTH) ? \
                    USBUART_EP_STATUS_LENGTH : USBUART_DEVICE_STATUS_LENGTH )
/* Transfer Completion Notification */
#define USBUART_XFER_IDLE                      (0x00u)
#define USBUART_XFER_STATUS_ACK                (0x01u)
#define USBUART_XFER_PREMATURE                 (0x02u)
#define USBUART_XFER_ERROR                     (0x03u)

/* Driver State defines */
#define USBUART_TRANS_STATE_IDLE               (0x00u)
#define USBUART_TRANS_STATE_CONTROL_READ       (0x02u)
#define USBUART_TRANS_STATE_CONTROL_WRITE      (0x04u)
#define USBUART_TRANS_STATE_NO_DATA_CONTROL    (0x06u)

/* String Descriptor defines */
#define USBUART_STRING_MSOS                    (0xEEu)
#define USBUART_MSOS_DESCRIPTOR_LENGTH         (18u)
#define USBUART_MSOS_CONF_DESCR_LENGTH         (40u)

#if(USBUART_EP_MM == USBUART__EP_DMAMANUAL)
    /* DMA manual mode defines */
    #define USBUART_DMA_BYTES_PER_BURST        (0u)
    #define USBUART_DMA_REQUEST_PER_BURST      (0u)
#endif /* End USBUART_EP_MM == USBUART__EP_DMAMANUAL */
#if(USBUART_EP_MM == USBUART__EP_DMAAUTO)
    /* DMA automatic mode defines */
    #define USBUART_DMA_BYTES_PER_BURST        (32u)
    /* BUF_SIZE-BYTES_PER_BURST examples: 55-32 bytes  44-16 bytes 33-8 bytes 22-4 bytes 11-2 bytes */
    #define USBUART_DMA_BUF_SIZE               (0x55u)
    #define USBUART_DMA_REQUEST_PER_BURST      (1u)
#endif /* End USBUART_EP_MM == USBUART__EP_DMAAUTO */

/* DIE ID string descriptor defines */
#if defined(USBUART_ENABLE_IDSN_STRING)
    #define USBUART_IDSN_DESCR_LENGTH          (0x22u)
#endif /* USBUART_ENABLE_IDSN_STRING */


/***************************************
* External data references
***************************************/

extern uint8 USBUART_initVar;
extern volatile uint8 USBUART_device;
extern volatile uint8 USBUART_transferState;
extern volatile uint8 USBUART_configuration;
extern volatile uint8 USBUART_configurationChanged;
extern volatile uint8 USBUART_deviceStatus;

/* HID Variables */
#if defined(USBUART_ENABLE_HID_CLASS)
    extern volatile uint8 USBUART_hidProtocol[USBUART_MAX_INTERFACES_NUMBER];
    extern volatile uint8 USBUART_hidIdleRate[USBUART_MAX_INTERFACES_NUMBER];
    extern volatile uint8 USBUART_hidIdleTimer[USBUART_MAX_INTERFACES_NUMBER];
#endif /* USBUART_ENABLE_HID_CLASS */


/***************************************
*              Registers
***************************************/

#define USBUART_ARB_CFG_PTR        (  (reg8 *) USBUART_USB__ARB_CFG)
#define USBUART_ARB_CFG_REG        (* (reg8 *) USBUART_USB__ARB_CFG)

#define USBUART_ARB_EP1_CFG_PTR    (  (reg8 *) USBUART_USB__ARB_EP1_CFG)
#define USBUART_ARB_EP1_CFG_REG    (* (reg8 *) USBUART_USB__ARB_EP1_CFG)
#define USBUART_ARB_EP1_CFG_IND    USBUART_USB__ARB_EP1_CFG
#define USBUART_ARB_EP1_INT_EN_PTR (  (reg8 *) USBUART_USB__ARB_EP1_INT_EN)
#define USBUART_ARB_EP1_INT_EN_REG (* (reg8 *) USBUART_USB__ARB_EP1_INT_EN)
#define USBUART_ARB_EP1_INT_EN_IND USBUART_USB__ARB_EP1_INT_EN
#define USBUART_ARB_EP1_SR_PTR     (  (reg8 *) USBUART_USB__ARB_EP1_SR)
#define USBUART_ARB_EP1_SR_REG     (* (reg8 *) USBUART_USB__ARB_EP1_SR)
#define USBUART_ARB_EP1_SR_IND     USBUART_USB__ARB_EP1_SR

#define USBUART_ARB_EP2_CFG_PTR    (  (reg8 *) USBUART_USB__ARB_EP2_CFG)
#define USBUART_ARB_EP2_CFG_REG    (* (reg8 *) USBUART_USB__ARB_EP2_CFG)
#define USBUART_ARB_EP2_INT_EN_PTR (  (reg8 *) USBUART_USB__ARB_EP2_INT_EN)
#define USBUART_ARB_EP2_INT_EN_REG (* (reg8 *) USBUART_USB__ARB_EP2_INT_EN)
#define USBUART_ARB_EP2_SR_PTR     (  (reg8 *) USBUART_USB__ARB_EP2_SR)
#define USBUART_ARB_EP2_SR_REG     (* (reg8 *) USBUART_USB__ARB_EP2_SR)

#define USBUART_ARB_EP3_CFG_PTR    (  (reg8 *) USBUART_USB__ARB_EP3_CFG)
#define USBUART_ARB_EP3_CFG_REG    (* (reg8 *) USBUART_USB__ARB_EP3_CFG)
#define USBUART_ARB_EP3_INT_EN_PTR (  (reg8 *) USBUART_USB__ARB_EP3_INT_EN)
#define USBUART_ARB_EP3_INT_EN_REG (* (reg8 *) USBUART_USB__ARB_EP3_INT_EN)
#define USBUART_ARB_EP3_SR_PTR     (  (reg8 *) USBUART_USB__ARB_EP3_SR)
#define USBUART_ARB_EP3_SR_REG     (* (reg8 *) USBUART_USB__ARB_EP3_SR)

#define USBUART_ARB_EP4_CFG_PTR    (  (reg8 *) USBUART_USB__ARB_EP4_CFG)
#define USBUART_ARB_EP4_CFG_REG    (* (reg8 *) USBUART_USB__ARB_EP4_CFG)
#define USBUART_ARB_EP4_INT_EN_PTR (  (reg8 *) USBUART_USB__ARB_EP4_INT_EN)
#define USBUART_ARB_EP4_INT_EN_REG (* (reg8 *) USBUART_USB__ARB_EP4_INT_EN)
#define USBUART_ARB_EP4_SR_PTR     (  (reg8 *) USBUART_USB__ARB_EP4_SR)
#define USBUART_ARB_EP4_SR_REG     (* (reg8 *) USBUART_USB__ARB_EP4_SR)

#define USBUART_ARB_EP5_CFG_PTR    (  (reg8 *) USBUART_USB__ARB_EP5_CFG)
#define USBUART_ARB_EP5_CFG_REG    (* (reg8 *) USBUART_USB__ARB_EP5_CFG)
#define USBUART_ARB_EP5_INT_EN_PTR (  (reg8 *) USBUART_USB__ARB_EP5_INT_EN)
#define USBUART_ARB_EP5_INT_EN_REG (* (reg8 *) USBUART_USB__ARB_EP5_INT_EN)
#define USBUART_ARB_EP5_SR_PTR     (  (reg8 *) USBUART_USB__ARB_EP5_SR)
#define USBUART_ARB_EP5_SR_REG     (* (reg8 *) USBUART_USB__ARB_EP5_SR)

#define USBUART_ARB_EP6_CFG_PTR    (  (reg8 *) USBUART_USB__ARB_EP6_CFG)
#define USBUART_ARB_EP6_CFG_REG    (* (reg8 *) USBUART_USB__ARB_EP6_CFG)
#define USBUART_ARB_EP6_INT_EN_PTR (  (reg8 *) USBUART_USB__ARB_EP6_INT_EN)
#define USBUART_ARB_EP6_INT_EN_REG (* (reg8 *) USBUART_USB__ARB_EP6_INT_EN)
#define USBUART_ARB_EP6_SR_PTR     (  (reg8 *) USBUART_USB__ARB_EP6_SR)
#define USBUART_ARB_EP6_SR_REG     (* (reg8 *) USBUART_USB__ARB_EP6_SR)

#define USBUART_ARB_EP7_CFG_PTR    (  (reg8 *) USBUART_USB__ARB_EP7_CFG)
#define USBUART_ARB_EP7_CFG_REG    (* (reg8 *) USBUART_USB__ARB_EP7_CFG)
#define USBUART_ARB_EP7_INT_EN_PTR (  (reg8 *) USBUART_USB__ARB_EP7_INT_EN)
#define USBUART_ARB_EP7_INT_EN_REG (* (reg8 *) USBUART_USB__ARB_EP7_INT_EN)
#define USBUART_ARB_EP7_SR_PTR     (  (reg8 *) USBUART_USB__ARB_EP7_SR)
#define USBUART_ARB_EP7_SR_REG     (* (reg8 *) USBUART_USB__ARB_EP7_SR)

#define USBUART_ARB_EP8_CFG_PTR    (  (reg8 *) USBUART_USB__ARB_EP8_CFG)
#define USBUART_ARB_EP8_CFG_REG    (* (reg8 *) USBUART_USB__ARB_EP8_CFG)
#define USBUART_ARB_EP8_INT_EN_PTR (  (reg8 *) USBUART_USB__ARB_EP8_INT_EN)
#define USBUART_ARB_EP8_INT_EN_REG (* (reg8 *) USBUART_USB__ARB_EP8_INT_EN)
#define USBUART_ARB_EP8_SR_PTR     (  (reg8 *) USBUART_USB__ARB_EP8_SR)
#define USBUART_ARB_EP8_SR_REG     (* (reg8 *) USBUART_USB__ARB_EP8_SR)

#define USBUART_ARB_INT_EN_PTR     (  (reg8 *) USBUART_USB__ARB_INT_EN)
#define USBUART_ARB_INT_EN_REG     (* (reg8 *) USBUART_USB__ARB_INT_EN)
#define USBUART_ARB_INT_SR_PTR     (  (reg8 *) USBUART_USB__ARB_INT_SR)
#define USBUART_ARB_INT_SR_REG     (* (reg8 *) USBUART_USB__ARB_INT_SR)

#define USBUART_ARB_RW1_DR_PTR     ((reg8 *) USBUART_USB__ARB_RW1_DR)
#define USBUART_ARB_RW1_DR_IND     USBUART_USB__ARB_RW1_DR
#define USBUART_ARB_RW1_RA_PTR     ((reg8 *) USBUART_USB__ARB_RW1_RA)
#define USBUART_ARB_RW1_RA_IND     USBUART_USB__ARB_RW1_RA
#define USBUART_ARB_RW1_RA_MSB_PTR ((reg8 *) USBUART_USB__ARB_RW1_RA_MSB)
#define USBUART_ARB_RW1_RA_MSB_IND USBUART_USB__ARB_RW1_RA_MSB
#define USBUART_ARB_RW1_WA_PTR     ((reg8 *) USBUART_USB__ARB_RW1_WA)
#define USBUART_ARB_RW1_WA_IND     USBUART_USB__ARB_RW1_WA
#define USBUART_ARB_RW1_WA_MSB_PTR ((reg8 *) USBUART_USB__ARB_RW1_WA_MSB)
#define USBUART_ARB_RW1_WA_MSB_IND USBUART_USB__ARB_RW1_WA_MSB

#define USBUART_ARB_RW2_DR_PTR     ((reg8 *) USBUART_USB__ARB_RW2_DR)
#define USBUART_ARB_RW2_RA_PTR     ((reg8 *) USBUART_USB__ARB_RW2_RA)
#define USBUART_ARB_RW2_RA_MSB_PTR ((reg8 *) USBUART_USB__ARB_RW2_RA_MSB)
#define USBUART_ARB_RW2_WA_PTR     ((reg8 *) USBUART_USB__ARB_RW2_WA)
#define USBUART_ARB_RW2_WA_MSB_PTR ((reg8 *) USBUART_USB__ARB_RW2_WA_MSB)

#define USBUART_ARB_RW3_DR_PTR     ((reg8 *) USBUART_USB__ARB_RW3_DR)
#define USBUART_ARB_RW3_RA_PTR     ((reg8 *) USBUART_USB__ARB_RW3_RA)
#define USBUART_ARB_RW3_RA_MSB_PTR ((reg8 *) USBUART_USB__ARB_RW3_RA_MSB)
#define USBUART_ARB_RW3_WA_PTR     ((reg8 *) USBUART_USB__ARB_RW3_WA)
#define USBUART_ARB_RW3_WA_MSB_PTR ((reg8 *) USBUART_USB__ARB_RW3_WA_MSB)

#define USBUART_ARB_RW4_DR_PTR     ((reg8 *) USBUART_USB__ARB_RW4_DR)
#define USBUART_ARB_RW4_RA_PTR     ((reg8 *) USBUART_USB__ARB_RW4_RA)
#define USBUART_ARB_RW4_RA_MSB_PTR ((reg8 *) USBUART_USB__ARB_RW4_RA_MSB)
#define USBUART_ARB_RW4_WA_PTR     ((reg8 *) USBUART_USB__ARB_RW4_WA)
#define USBUART_ARB_RW4_WA_MSB_PTR ((reg8 *) USBUART_USB__ARB_RW4_WA_MSB)

#define USBUART_ARB_RW5_DR_PTR     ((reg8 *) USBUART_USB__ARB_RW5_DR)
#define USBUART_ARB_RW5_RA_PTR     ((reg8 *) USBUART_USB__ARB_RW5_RA)
#define USBUART_ARB_RW5_RA_MSB_PTR ((reg8 *) USBUART_USB__ARB_RW5_RA_MSB)
#define USBUART_ARB_RW5_WA_PTR     ((reg8 *) USBUART_USB__ARB_RW5_WA)
#define USBUART_ARB_RW5_WA_MSB_PTR ((reg8 *) USBUART_USB__ARB_RW5_WA_MSB)

#define USBUART_ARB_RW6_DR_PTR     ((reg8 *) USBUART_USB__ARB_RW6_DR)
#define USBUART_ARB_RW6_RA_PTR     ((reg8 *) USBUART_USB__ARB_RW6_RA)
#define USBUART_ARB_RW6_RA_MSB_PTR ((reg8 *) USBUART_USB__ARB_RW6_RA_MSB)
#define USBUART_ARB_RW6_WA_PTR     ((reg8 *) USBUART_USB__ARB_RW6_WA)
#define USBUART_ARB_RW6_WA_MSB_PTR ((reg8 *) USBUART_USB__ARB_RW6_WA_MSB)

#define USBUART_ARB_RW7_DR_PTR     ((reg8 *) USBUART_USB__ARB_RW7_DR)
#define USBUART_ARB_RW7_RA_PTR     ((reg8 *) USBUART_USB__ARB_RW7_RA)
#define USBUART_ARB_RW7_RA_MSB_PTR ((reg8 *) USBUART_USB__ARB_RW7_RA_MSB)
#define USBUART_ARB_RW7_WA_PTR     ((reg8 *) USBUART_USB__ARB_RW7_WA)
#define USBUART_ARB_RW7_WA_MSB_PTR ((reg8 *) USBUART_USB__ARB_RW7_WA_MSB)

#define USBUART_ARB_RW8_DR_PTR     ((reg8 *) USBUART_USB__ARB_RW8_DR)
#define USBUART_ARB_RW8_RA_PTR     ((reg8 *) USBUART_USB__ARB_RW8_RA)
#define USBUART_ARB_RW8_RA_MSB_PTR ((reg8 *) USBUART_USB__ARB_RW8_RA_MSB)
#define USBUART_ARB_RW8_WA_PTR     ((reg8 *) USBUART_USB__ARB_RW8_WA)
#define USBUART_ARB_RW8_WA_MSB_PTR ((reg8 *) USBUART_USB__ARB_RW8_WA_MSB)

#define USBUART_BUF_SIZE_PTR       (  (reg8 *) USBUART_USB__BUF_SIZE)
#define USBUART_BUF_SIZE_REG       (* (reg8 *) USBUART_USB__BUF_SIZE)
#define USBUART_BUS_RST_CNT_PTR    (  (reg8 *) USBUART_USB__BUS_RST_CNT)
#define USBUART_BUS_RST_CNT_REG    (* (reg8 *) USBUART_USB__BUS_RST_CNT)
#define USBUART_CWA_PTR            (  (reg8 *) USBUART_USB__CWA)
#define USBUART_CWA_REG            (* (reg8 *) USBUART_USB__CWA)
#define USBUART_CWA_MSB_PTR        (  (reg8 *) USBUART_USB__CWA_MSB)
#define USBUART_CWA_MSB_REG        (* (reg8 *) USBUART_USB__CWA_MSB)
#define USBUART_CR0_PTR            (  (reg8 *) USBUART_USB__CR0)
#define USBUART_CR0_REG            (* (reg8 *) USBUART_USB__CR0)
#define USBUART_CR1_PTR            (  (reg8 *) USBUART_USB__CR1)
#define USBUART_CR1_REG            (* (reg8 *) USBUART_USB__CR1)

#define USBUART_DMA_THRES_PTR      (  (reg8 *) USBUART_USB__DMA_THRES)
#define USBUART_DMA_THRES_REG      (* (reg8 *) USBUART_USB__DMA_THRES)
#define USBUART_DMA_THRES_MSB_PTR  (  (reg8 *) USBUART_USB__DMA_THRES_MSB)
#define USBUART_DMA_THRES_MSB_REG  (* (reg8 *) USBUART_USB__DMA_THRES_MSB)

#define USBUART_EP_ACTIVE_PTR      (  (reg8 *) USBUART_USB__EP_ACTIVE)
#define USBUART_EP_ACTIVE_REG      (* (reg8 *) USBUART_USB__EP_ACTIVE)
#define USBUART_EP_TYPE_PTR        (  (reg8 *) USBUART_USB__EP_TYPE)
#define USBUART_EP_TYPE_REG        (* (reg8 *) USBUART_USB__EP_TYPE)

#define USBUART_EP0_CNT_PTR        (  (reg8 *) USBUART_USB__EP0_CNT)
#define USBUART_EP0_CNT_REG        (* (reg8 *) USBUART_USB__EP0_CNT)
#define USBUART_EP0_CR_PTR         (  (reg8 *) USBUART_USB__EP0_CR)
#define USBUART_EP0_CR_REG         (* (reg8 *) USBUART_USB__EP0_CR)
#define USBUART_EP0_DR0_PTR        (  (reg8 *) USBUART_USB__EP0_DR0)
#define USBUART_EP0_DR0_REG        (* (reg8 *) USBUART_USB__EP0_DR0)
#define USBUART_EP0_DR0_IND        USBUART_USB__EP0_DR0
#define USBUART_EP0_DR1_PTR        (  (reg8 *) USBUART_USB__EP0_DR1)
#define USBUART_EP0_DR1_REG        (* (reg8 *) USBUART_USB__EP0_DR1)
#define USBUART_EP0_DR2_PTR        (  (reg8 *) USBUART_USB__EP0_DR2)
#define USBUART_EP0_DR2_REG        (* (reg8 *) USBUART_USB__EP0_DR2)
#define USBUART_EP0_DR3_PTR        (  (reg8 *) USBUART_USB__EP0_DR3)
#define USBUART_EP0_DR3_REG        (* (reg8 *) USBUART_USB__EP0_DR3)
#define USBUART_EP0_DR4_PTR        (  (reg8 *) USBUART_USB__EP0_DR4)
#define USBUART_EP0_DR4_REG        (* (reg8 *) USBUART_USB__EP0_DR4)
#define USBUART_EP0_DR5_PTR        (  (reg8 *) USBUART_USB__EP0_DR5)
#define USBUART_EP0_DR5_REG        (* (reg8 *) USBUART_USB__EP0_DR5)
#define USBUART_EP0_DR6_PTR        (  (reg8 *) USBUART_USB__EP0_DR6)
#define USBUART_EP0_DR6_REG        (* (reg8 *) USBUART_USB__EP0_DR6)
#define USBUART_EP0_DR7_PTR        (  (reg8 *) USBUART_USB__EP0_DR7)
#define USBUART_EP0_DR7_REG        (* (reg8 *) USBUART_USB__EP0_DR7)

#define USBUART_OSCLK_DR0_PTR      (  (reg8 *) USBUART_USB__OSCLK_DR0)
#define USBUART_OSCLK_DR0_REG      (* (reg8 *) USBUART_USB__OSCLK_DR0)
#define USBUART_OSCLK_DR1_PTR      (  (reg8 *) USBUART_USB__OSCLK_DR1)
#define USBUART_OSCLK_DR1_REG      (* (reg8 *) USBUART_USB__OSCLK_DR1)

#define USBUART_PM_ACT_CFG_PTR     (  (reg8 *) USBUART_USB__PM_ACT_CFG)
#define USBUART_PM_ACT_CFG_REG     (* (reg8 *) USBUART_USB__PM_ACT_CFG)
#define USBUART_PM_STBY_CFG_PTR    (  (reg8 *) USBUART_USB__PM_STBY_CFG)
#define USBUART_PM_STBY_CFG_REG    (* (reg8 *) USBUART_USB__PM_STBY_CFG)

#define USBUART_SIE_EP_INT_EN_PTR  (  (reg8 *) USBUART_USB__SIE_EP_INT_EN)
#define USBUART_SIE_EP_INT_EN_REG  (* (reg8 *) USBUART_USB__SIE_EP_INT_EN)
#define USBUART_SIE_EP_INT_SR_PTR  (  (reg8 *) USBUART_USB__SIE_EP_INT_SR)
#define USBUART_SIE_EP_INT_SR_REG  (* (reg8 *) USBUART_USB__SIE_EP_INT_SR)

#define USBUART_SIE_EP1_CNT0_PTR   (  (reg8 *) USBUART_USB__SIE_EP1_CNT0)
#define USBUART_SIE_EP1_CNT0_REG   (* (reg8 *) USBUART_USB__SIE_EP1_CNT0)
#define USBUART_SIE_EP1_CNT0_IND   USBUART_USB__SIE_EP1_CNT0
#define USBUART_SIE_EP1_CNT1_PTR   (  (reg8 *) USBUART_USB__SIE_EP1_CNT1)
#define USBUART_SIE_EP1_CNT1_REG   (* (reg8 *) USBUART_USB__SIE_EP1_CNT1)
#define USBUART_SIE_EP1_CNT1_IND   USBUART_USB__SIE_EP1_CNT1
#define USBUART_SIE_EP1_CR0_PTR    (  (reg8 *) USBUART_USB__SIE_EP1_CR0)
#define USBUART_SIE_EP1_CR0_REG    (* (reg8 *) USBUART_USB__SIE_EP1_CR0)
#define USBUART_SIE_EP1_CR0_IND    USBUART_USB__SIE_EP1_CR0

#define USBUART_SIE_EP2_CNT0_PTR   (  (reg8 *) USBUART_USB__SIE_EP2_CNT0)
#define USBUART_SIE_EP2_CNT0_REG   (* (reg8 *) USBUART_USB__SIE_EP2_CNT0)
#define USBUART_SIE_EP2_CNT1_PTR   (  (reg8 *) USBUART_USB__SIE_EP2_CNT1)
#define USBUART_SIE_EP2_CNT1_REG   (* (reg8 *) USBUART_USB__SIE_EP2_CNT1)
#define USBUART_SIE_EP2_CR0_PTR    (  (reg8 *) USBUART_USB__SIE_EP2_CR0)
#define USBUART_SIE_EP2_CR0_REG    (* (reg8 *) USBUART_USB__SIE_EP2_CR0)

#define USBUART_SIE_EP3_CNT0_PTR   (  (reg8 *) USBUART_USB__SIE_EP3_CNT0)
#define USBUART_SIE_EP3_CNT0_REG   (* (reg8 *) USBUART_USB__SIE_EP3_CNT0)
#define USBUART_SIE_EP3_CNT1_PTR   (  (reg8 *) USBUART_USB__SIE_EP3_CNT1)
#define USBUART_SIE_EP3_CNT1_REG   (* (reg8 *) USBUART_USB__SIE_EP3_CNT1)
#define USBUART_SIE_EP3_CR0_PTR    (  (reg8 *) USBUART_USB__SIE_EP3_CR0)
#define USBUART_SIE_EP3_CR0_REG    (* (reg8 *) USBUART_USB__SIE_EP3_CR0)

#define USBUART_SIE_EP4_CNT0_PTR   (  (reg8 *) USBUART_USB__SIE_EP4_CNT0)
#define USBUART_SIE_EP4_CNT0_REG   (* (reg8 *) USBUART_USB__SIE_EP4_CNT0)
#define USBUART_SIE_EP4_CNT1_PTR   (  (reg8 *) USBUART_USB__SIE_EP4_CNT1)
#define USBUART_SIE_EP4_CNT1_REG   (* (reg8 *) USBUART_USB__SIE_EP4_CNT1)
#define USBUART_SIE_EP4_CR0_PTR    (  (reg8 *) USBUART_USB__SIE_EP4_CR0)
#define USBUART_SIE_EP4_CR0_REG    (* (reg8 *) USBUART_USB__SIE_EP4_CR0)

#define USBUART_SIE_EP5_CNT0_PTR   (  (reg8 *) USBUART_USB__SIE_EP5_CNT0)
#define USBUART_SIE_EP5_CNT0_REG   (* (reg8 *) USBUART_USB__SIE_EP5_CNT0)
#define USBUART_SIE_EP5_CNT1_PTR   (  (reg8 *) USBUART_USB__SIE_EP5_CNT1)
#define USBUART_SIE_EP5_CNT1_REG   (* (reg8 *) USBUART_USB__SIE_EP5_CNT1)
#define USBUART_SIE_EP5_CR0_PTR    (  (reg8 *) USBUART_USB__SIE_EP5_CR0)
#define USBUART_SIE_EP5_CR0_REG    (* (reg8 *) USBUART_USB__SIE_EP5_CR0)

#define USBUART_SIE_EP6_CNT0_PTR   (  (reg8 *) USBUART_USB__SIE_EP6_CNT0)
#define USBUART_SIE_EP6_CNT0_REG   (* (reg8 *) USBUART_USB__SIE_EP6_CNT0)
#define USBUART_SIE_EP6_CNT1_PTR   (  (reg8 *) USBUART_USB__SIE_EP6_CNT1)
#define USBUART_SIE_EP6_CNT1_REG   (* (reg8 *) USBUART_USB__SIE_EP6_CNT1)
#define USBUART_SIE_EP6_CR0_PTR    (  (reg8 *) USBUART_USB__SIE_EP6_CR0)
#define USBUART_SIE_EP6_CR0_REG    (* (reg8 *) USBUART_USB__SIE_EP6_CR0)

#define USBUART_SIE_EP7_CNT0_PTR   (  (reg8 *) USBUART_USB__SIE_EP7_CNT0)
#define USBUART_SIE_EP7_CNT0_REG   (* (reg8 *) USBUART_USB__SIE_EP7_CNT0)
#define USBUART_SIE_EP7_CNT1_PTR   (  (reg8 *) USBUART_USB__SIE_EP7_CNT1)
#define USBUART_SIE_EP7_CNT1_REG   (* (reg8 *) USBUART_USB__SIE_EP7_CNT1)
#define USBUART_SIE_EP7_CR0_PTR    (  (reg8 *) USBUART_USB__SIE_EP7_CR0)
#define USBUART_SIE_EP7_CR0_REG    (* (reg8 *) USBUART_USB__SIE_EP7_CR0)

#define USBUART_SIE_EP8_CNT0_PTR   (  (reg8 *) USBUART_USB__SIE_EP8_CNT0)
#define USBUART_SIE_EP8_CNT0_REG   (* (reg8 *) USBUART_USB__SIE_EP8_CNT0)
#define USBUART_SIE_EP8_CNT1_PTR   (  (reg8 *) USBUART_USB__SIE_EP8_CNT1)
#define USBUART_SIE_EP8_CNT1_REG   (* (reg8 *) USBUART_USB__SIE_EP8_CNT1)
#define USBUART_SIE_EP8_CR0_PTR    (  (reg8 *) USBUART_USB__SIE_EP8_CR0)
#define USBUART_SIE_EP8_CR0_REG    (* (reg8 *) USBUART_USB__SIE_EP8_CR0)

#define USBUART_SOF0_PTR           (  (reg8 *) USBUART_USB__SOF0)
#define USBUART_SOF0_REG           (* (reg8 *) USBUART_USB__SOF0)
#define USBUART_SOF1_PTR           (  (reg8 *) USBUART_USB__SOF1)
#define USBUART_SOF1_REG           (* (reg8 *) USBUART_USB__SOF1)

#define USBUART_USB_CLK_EN_PTR     (  (reg8 *) USBUART_USB__USB_CLK_EN)
#define USBUART_USB_CLK_EN_REG     (* (reg8 *) USBUART_USB__USB_CLK_EN)

#define USBUART_USBIO_CR0_PTR      (  (reg8 *) USBUART_USB__USBIO_CR0)
#define USBUART_USBIO_CR0_REG      (* (reg8 *) USBUART_USB__USBIO_CR0)
#define USBUART_USBIO_CR1_PTR      (  (reg8 *) USBUART_USB__USBIO_CR1)
#define USBUART_USBIO_CR1_REG      (* (reg8 *) USBUART_USB__USBIO_CR1)
#if(!CY_PSOC5LP)
    #define USBUART_USBIO_CR2_PTR      (  (reg8 *) USBUART_USB__USBIO_CR2)
    #define USBUART_USBIO_CR2_REG      (* (reg8 *) USBUART_USB__USBIO_CR2)
#endif /* End CY_PSOC5LP */

#define USBUART_DIE_ID             CYDEV_FLSHID_CUST_TABLES_BASE

#define USBUART_PM_USB_CR0_PTR     (  (reg8 *) CYREG_PM_USB_CR0)
#define USBUART_PM_USB_CR0_REG     (* (reg8 *) CYREG_PM_USB_CR0)
#define USBUART_DYN_RECONFIG_PTR   (  (reg8 *) USBUART_USB__DYN_RECONFIG)
#define USBUART_DYN_RECONFIG_REG   (* (reg8 *) USBUART_USB__DYN_RECONFIG)

#define USBUART_DM_INP_DIS_PTR     (  (reg8 *) USBUART_Dm__INP_DIS)
#define USBUART_DM_INP_DIS_REG     (* (reg8 *) USBUART_Dm__INP_DIS)
#define USBUART_DP_INP_DIS_PTR     (  (reg8 *) USBUART_Dp__INP_DIS)
#define USBUART_DP_INP_DIS_REG     (* (reg8 *) USBUART_Dp__INP_DIS)
#define USBUART_DP_INTSTAT_PTR     (  (reg8 *) USBUART_Dp__INTSTAT)
#define USBUART_DP_INTSTAT_REG     (* (reg8 *) USBUART_Dp__INTSTAT)

#if (USBUART_MON_VBUS == 1u)
    #if (USBUART_EXTERN_VBUS == 0u)
        #define USBUART_VBUS_DR_PTR        (  (reg8 *) USBUART_VBUS__DR)
        #define USBUART_VBUS_DR_REG        (* (reg8 *) USBUART_VBUS__DR)
        #define USBUART_VBUS_PS_PTR        (  (reg8 *) USBUART_VBUS__PS)
        #define USBUART_VBUS_PS_REG        (* (reg8 *) USBUART_VBUS__PS)
        #define USBUART_VBUS_MASK          USBUART_VBUS__MASK
    #else
        #define USBUART_VBUS_PS_PTR        (  (reg8 *) USBUART_Vbus_ps_sts_sts_reg__STATUS_REG )
        #define USBUART_VBUS_MASK          (0x01u)
    #endif /* End USBUART_EXTERN_VBUS == 0u */
#endif /* End USBUART_MON_VBUS */

/* Renamed Registers for backward compatibility.
*  Should not be used in new designs.
*/
#define USBUART_ARB_CFG        USBUART_ARB_CFG_PTR

#define USBUART_ARB_EP1_CFG    USBUART_ARB_EP1_CFG_PTR
#define USBUART_ARB_EP1_INT_EN USBUART_ARB_EP1_INT_EN_PTR
#define USBUART_ARB_EP1_SR     USBUART_ARB_EP1_SR_PTR

#define USBUART_ARB_EP2_CFG    USBUART_ARB_EP2_CFG_PTR
#define USBUART_ARB_EP2_INT_EN USBUART_ARB_EP2_INT_EN_PTR
#define USBUART_ARB_EP2_SR     USBUART_ARB_EP2_SR_PTR

#define USBUART_ARB_EP3_CFG    USBUART_ARB_EP3_CFG_PTR
#define USBUART_ARB_EP3_INT_EN USBUART_ARB_EP3_INT_EN_PTR
#define USBUART_ARB_EP3_SR     USBUART_ARB_EP3_SR_PTR

#define USBUART_ARB_EP4_CFG    USBUART_ARB_EP4_CFG_PTR
#define USBUART_ARB_EP4_INT_EN USBUART_ARB_EP4_INT_EN_PTR
#define USBUART_ARB_EP4_SR     USBUART_ARB_EP4_SR_PTR

#define USBUART_ARB_EP5_CFG    USBUART_ARB_EP5_CFG_PTR
#define USBUART_ARB_EP5_INT_EN USBUART_ARB_EP5_INT_EN_PTR
#define USBUART_ARB_EP5_SR     USBUART_ARB_EP5_SR_PTR

#define USBUART_ARB_EP6_CFG    USBUART_ARB_EP6_CFG_PTR
#define USBUART_ARB_EP6_INT_EN USBUART_ARB_EP6_INT_EN_PTR
#define USBUART_ARB_EP6_SR     USBUART_ARB_EP6_SR_PTR

#define USBUART_ARB_EP7_CFG    USBUART_ARB_EP7_CFG_PTR
#define USBUART_ARB_EP7_INT_EN USBUART_ARB_EP7_INT_EN_PTR
#define USBUART_ARB_EP7_SR     USBUART_ARB_EP7_SR_PTR

#define USBUART_ARB_EP8_CFG    USBUART_ARB_EP8_CFG_PTR
#define USBUART_ARB_EP8_INT_EN USBUART_ARB_EP8_INT_EN_PTR
#define USBUART_ARB_EP8_SR     USBUART_ARB_EP8_SR_PTR

#define USBUART_ARB_INT_EN     USBUART_ARB_INT_EN_PTR
#define USBUART_ARB_INT_SR     USBUART_ARB_INT_SR_PTR

#define USBUART_ARB_RW1_DR     USBUART_ARB_RW1_DR_PTR
#define USBUART_ARB_RW1_RA     USBUART_ARB_RW1_RA_PTR
#define USBUART_ARB_RW1_RA_MSB USBUART_ARB_RW1_RA_MSB_PTR
#define USBUART_ARB_RW1_WA     USBUART_ARB_RW1_WA_PTR
#define USBUART_ARB_RW1_WA_MSB USBUART_ARB_RW1_WA_MSB_PTR

#define USBUART_ARB_RW2_DR     USBUART_ARB_RW2_DR_PTR
#define USBUART_ARB_RW2_RA     USBUART_ARB_RW2_RA_PTR
#define USBUART_ARB_RW2_RA_MSB USBUART_ARB_RW2_RA_MSB_PTR
#define USBUART_ARB_RW2_WA     USBUART_ARB_RW2_WA_PTR
#define USBUART_ARB_RW2_WA_MSB USBUART_ARB_RW2_WA_MSB_PTR

#define USBUART_ARB_RW3_DR     USBUART_ARB_RW3_DR_PTR
#define USBUART_ARB_RW3_RA     USBUART_ARB_RW3_RA_PTR
#define USBUART_ARB_RW3_RA_MSB USBUART_ARB_RW3_RA_MSB_PTR
#define USBUART_ARB_RW3_WA     USBUART_ARB_RW3_WA_PTR
#define USBUART_ARB_RW3_WA_MSB USBUART_ARB_RW3_WA_MSB_PTR

#define USBUART_ARB_RW4_DR     USBUART_ARB_RW4_DR_PTR
#define USBUART_ARB_RW4_RA     USBUART_ARB_RW4_RA_PTR
#define USBUART_ARB_RW4_RA_MSB USBUART_ARB_RW4_RA_MSB_PTR
#define USBUART_ARB_RW4_WA     USBUART_ARB_RW4_WA_PTR
#define USBUART_ARB_RW4_WA_MSB USBUART_ARB_RW4_WA_MSB_PTR

#define USBUART_ARB_RW5_DR     USBUART_ARB_RW5_DR_PTR
#define USBUART_ARB_RW5_RA     USBUART_ARB_RW5_RA_PTR
#define USBUART_ARB_RW5_RA_MSB USBUART_ARB_RW5_RA_MSB_PTR
#define USBUART_ARB_RW5_WA     USBUART_ARB_RW5_WA_PTR
#define USBUART_ARB_RW5_WA_MSB USBUART_ARB_RW5_WA_MSB_PTR

#define USBUART_ARB_RW6_DR     USBUART_ARB_RW6_DR_PTR
#define USBUART_ARB_RW6_RA     USBUART_ARB_RW6_RA_PTR
#define USBUART_ARB_RW6_RA_MSB USBUART_ARB_RW6_RA_MSB_PTR
#define USBUART_ARB_RW6_WA     USBUART_ARB_RW6_WA_PTR
#define USBUART_ARB_RW6_WA_MSB USBUART_ARB_RW6_WA_MSB_PTR

#define USBUART_ARB_RW7_DR     USBUART_ARB_RW7_DR_PTR
#define USBUART_ARB_RW7_RA     USBUART_ARB_RW7_RA_PTR
#define USBUART_ARB_RW7_RA_MSB USBUART_ARB_RW7_RA_MSB_PTR
#define USBUART_ARB_RW7_WA     USBUART_ARB_RW7_WA_PTR
#define USBUART_ARB_RW7_WA_MSB USBUART_ARB_RW7_WA_MSB_PTR

#define USBUART_ARB_RW8_DR     USBUART_ARB_RW8_DR_PTR
#define USBUART_ARB_RW8_RA     USBUART_ARB_RW8_RA_PTR
#define USBUART_ARB_RW8_RA_MSB USBUART_ARB_RW8_RA_MSB_PTR
#define USBUART_ARB_RW8_WA     USBUART_ARB_RW8_WA_PTR
#define USBUART_ARB_RW8_WA_MSB USBUART_ARB_RW8_WA_MSB_PTR

#define USBUART_BUF_SIZE       USBUART_BUF_SIZE_PTR
#define USBUART_BUS_RST_CNT    USBUART_BUS_RST_CNT_PTR
#define USBUART_CR0            USBUART_CR0_PTR
#define USBUART_CR1            USBUART_CR1_PTR
#define USBUART_CWA            USBUART_CWA_PTR
#define USBUART_CWA_MSB        USBUART_CWA_MSB_PTR

#define USBUART_DMA_THRES      USBUART_DMA_THRES_PTR
#define USBUART_DMA_THRES_MSB  USBUART_DMA_THRES_MSB_PTR

#define USBUART_EP_ACTIVE      USBUART_EP_ACTIVE_PTR
#define USBUART_EP_TYPE        USBUART_EP_TYPE_PTR

#define USBUART_EP0_CNT        USBUART_EP0_CNT_PTR
#define USBUART_EP0_CR         USBUART_EP0_CR_PTR
#define USBUART_EP0_DR0        USBUART_EP0_DR0_PTR
#define USBUART_EP0_DR1        USBUART_EP0_DR1_PTR
#define USBUART_EP0_DR2        USBUART_EP0_DR2_PTR
#define USBUART_EP0_DR3        USBUART_EP0_DR3_PTR
#define USBUART_EP0_DR4        USBUART_EP0_DR4_PTR
#define USBUART_EP0_DR5        USBUART_EP0_DR5_PTR
#define USBUART_EP0_DR6        USBUART_EP0_DR6_PTR
#define USBUART_EP0_DR7        USBUART_EP0_DR7_PTR

#define USBUART_OSCLK_DR0      USBUART_OSCLK_DR0_PTR
#define USBUART_OSCLK_DR1      USBUART_OSCLK_DR1_PTR

#define USBUART_PM_ACT_CFG     USBUART_PM_ACT_CFG_PTR
#define USBUART_PM_STBY_CFG    USBUART_PM_STBY_CFG_PTR

#define USBUART_SIE_EP_INT_EN  USBUART_SIE_EP_INT_EN_PTR
#define USBUART_SIE_EP_INT_SR  USBUART_SIE_EP_INT_SR_PTR

#define USBUART_SIE_EP1_CNT0   USBUART_SIE_EP1_CNT0_PTR
#define USBUART_SIE_EP1_CNT1   USBUART_SIE_EP1_CNT1_PTR
#define USBUART_SIE_EP1_CR0    USBUART_SIE_EP1_CR0_PTR

#define USBUART_SIE_EP2_CNT0   USBUART_SIE_EP2_CNT0_PTR
#define USBUART_SIE_EP2_CNT1   USBUART_SIE_EP2_CNT1_PTR
#define USBUART_SIE_EP2_CR0    USBUART_SIE_EP2_CR0_PTR

#define USBUART_SIE_EP3_CNT0   USBUART_SIE_EP3_CNT0_PTR
#define USBUART_SIE_EP3_CNT1   USBUART_SIE_EP3_CNT1_PTR
#define USBUART_SIE_EP3_CR0    USBUART_SIE_EP3_CR0_PTR

#define USBUART_SIE_EP4_CNT0   USBUART_SIE_EP4_CNT0_PTR
#define USBUART_SIE_EP4_CNT1   USBUART_SIE_EP4_CNT1_PTR
#define USBUART_SIE_EP4_CR0    USBUART_SIE_EP4_CR0_PTR

#define USBUART_SIE_EP5_CNT0   USBUART_SIE_EP5_CNT0_PTR
#define USBUART_SIE_EP5_CNT1   USBUART_SIE_EP5_CNT1_PTR
#define USBUART_SIE_EP5_CR0    USBUART_SIE_EP5_CR0_PTR

#define USBUART_SIE_EP6_CNT0   USBUART_SIE_EP6_CNT0_PTR
#define USBUART_SIE_EP6_CNT1   USBUART_SIE_EP6_CNT1_PTR
#define USBUART_SIE_EP6_CR0    USBUART_SIE_EP6_CR0_PTR

#define USBUART_SIE_EP7_CNT0   USBUART_SIE_EP7_CNT0_PTR
#define USBUART_SIE_EP7_CNT1   USBUART_SIE_EP7_CNT1_PTR
#define USBUART_SIE_EP7_CR0    USBUART_SIE_EP7_CR0_PTR

#define USBUART_SIE_EP8_CNT0   USBUART_SIE_EP8_CNT0_PTR
#define USBUART_SIE_EP8_CNT1   USBUART_SIE_EP8_CNT1_PTR
#define USBUART_SIE_EP8_CR0    USBUART_SIE_EP8_CR0_PTR

#define USBUART_SOF0           USBUART_SOF0_PTR
#define USBUART_SOF1           USBUART_SOF1_PTR

#define USBUART_USB_CLK_EN     USBUART_USB_CLK_EN_PTR

#define USBUART_USBIO_CR0      USBUART_USBIO_CR0_PTR
#define USBUART_USBIO_CR1      USBUART_USBIO_CR1_PTR
#define USBUART_USBIO_CR2      USBUART_USBIO_CR2_PTR

#define USBUART_USB_MEM        ((reg8 *) CYDEV_USB_MEM_BASE)

#if(CYDEV_CHIP_DIE_EXPECT == CYDEV_CHIP_DIE_LEOPARD)
    /* PSoC3 interrupt registers*/
    #define USBUART_USB_ISR_PRIOR  ((reg8 *) CYDEV_INTC_PRIOR0)
    #define USBUART_USB_ISR_SET_EN ((reg8 *) CYDEV_INTC_SET_EN0)
    #define USBUART_USB_ISR_CLR_EN ((reg8 *) CYDEV_INTC_CLR_EN0)
    #define USBUART_USB_ISR_VECT   ((cyisraddress *) CYDEV_INTC_VECT_MBASE)
#elif(CYDEV_CHIP_DIE_EXPECT == CYDEV_CHIP_DIE_PANTHER)
    /* PSoC5 interrupt registers*/
    #define USBUART_USB_ISR_PRIOR  ((reg8 *) CYDEV_NVIC_PRI_0)
    #define USBUART_USB_ISR_SET_EN ((reg8 *) CYDEV_NVIC_SETENA0)
    #define USBUART_USB_ISR_CLR_EN ((reg8 *) CYDEV_NVIC_CLRENA0)
    #define USBUART_USB_ISR_VECT   ((cyisraddress *) CYDEV_NVIC_VECT_OFFSET)
#endif /* End CYDEV_CHIP_DIE_EXPECT */


/***************************************
* Interrupt vectors, masks and priorities
***************************************/

#define USBUART_BUS_RESET_PRIOR    USBUART_bus_reset__INTC_PRIOR_NUM
#define USBUART_BUS_RESET_MASK     USBUART_bus_reset__INTC_MASK
#define USBUART_BUS_RESET_VECT_NUM USBUART_bus_reset__INTC_NUMBER

#define USBUART_SOF_PRIOR          USBUART_sof_int__INTC_PRIOR_NUM
#define USBUART_SOF_MASK           USBUART_sof_int__INTC_MASK
#define USBUART_SOF_VECT_NUM       USBUART_sof_int__INTC_NUMBER

#define USBUART_EP_0_PRIOR         USBUART_ep_0__INTC_PRIOR_NUM
#define USBUART_EP_0_MASK          USBUART_ep_0__INTC_MASK
#define USBUART_EP_0_VECT_NUM      USBUART_ep_0__INTC_NUMBER

#define USBUART_EP_1_PRIOR         USBUART_ep_1__INTC_PRIOR_NUM
#define USBUART_EP_1_MASK          USBUART_ep_1__INTC_MASK
#define USBUART_EP_1_VECT_NUM      USBUART_ep_1__INTC_NUMBER

#define USBUART_EP_2_PRIOR         USBUART_ep_2__INTC_PRIOR_NUM
#define USBUART_EP_2_MASK          USBUART_ep_2__INTC_MASK
#define USBUART_EP_2_VECT_NUM      USBUART_ep_2__INTC_NUMBER

#define USBUART_EP_3_PRIOR         USBUART_ep_3__INTC_PRIOR_NUM
#define USBUART_EP_3_MASK          USBUART_ep_3__INTC_MASK
#define USBUART_EP_3_VECT_NUM      USBUART_ep_3__INTC_NUMBER

#define USBUART_EP_4_PRIOR         USBUART_ep_4__INTC_PRIOR_NUM
#define USBUART_EP_4_MASK          USBUART_ep_4__INTC_MASK
#define USBUART_EP_4_VECT_NUM      USBUART_ep_4__INTC_NUMBER

#define USBUART_EP_5_PRIOR         USBUART_ep_5__INTC_PRIOR_NUM
#define USBUART_EP_5_MASK          USBUART_ep_5__INTC_MASK
#define USBUART_EP_5_VECT_NUM      USBUART_ep_5__INTC_NUMBER

#define USBUART_EP_6_PRIOR         USBUART_ep_6__INTC_PRIOR_NUM
#define USBUART_EP_6_MASK          USBUART_ep_6__INTC_MASK
#define USBUART_EP_6_VECT_NUM      USBUART_ep_6__INTC_NUMBER

#define USBUART_EP_7_PRIOR         USBUART_ep_7__INTC_PRIOR_NUM
#define USBUART_EP_7_MASK          USBUART_ep_7__INTC_MASK
#define USBUART_EP_7_VECT_NUM      USBUART_ep_7__INTC_NUMBER

#define USBUART_EP_8_PRIOR         USBUART_ep_8__INTC_PRIOR_NUM
#define USBUART_EP_8_MASK          USBUART_ep_8__INTC_MASK
#define USBUART_EP_8_VECT_NUM      USBUART_ep_8__INTC_NUMBER

#define USBUART_DP_INTC_PRIOR      USBUART_dp_int__INTC_PRIOR_NUM
#define USBUART_DP_INTC_MASK       USBUART_dp_int__INTC_MASK
#define USBUART_DP_INTC_VECT_NUM   USBUART_dp_int__INTC_NUMBER

/* ARB ISR should have higher priority from EP_X ISR, therefore it is defined to highest (0) */
#define USBUART_ARB_PRIOR          (0u)
#define USBUART_ARB_MASK           USBUART_arb_int__INTC_MASK
#define USBUART_ARB_VECT_NUM       USBUART_arb_int__INTC_NUMBER

/***************************************
 *  Endpoint 0 offsets (Table 9-2)
 **************************************/

#define USBUART_bmRequestType      USBUART_EP0_DR0_PTR
#define USBUART_bRequest           USBUART_EP0_DR1_PTR
#define USBUART_wValue             USBUART_EP0_DR2_PTR
#define USBUART_wValueHi           USBUART_EP0_DR3_PTR
#define USBUART_wValueLo           USBUART_EP0_DR2_PTR
#define USBUART_wIndex             USBUART_EP0_DR4_PTR
#define USBUART_wIndexHi           USBUART_EP0_DR5_PTR
#define USBUART_wIndexLo           USBUART_EP0_DR4_PTR
#define USBUART_length             USBUART_EP0_DR6_PTR
#define USBUART_lengthHi           USBUART_EP0_DR7_PTR
#define USBUART_lengthLo           USBUART_EP0_DR6_PTR


/***************************************
*       Register Constants
***************************************/
#define USBUART_VDDD_MV                    CYDEV_VDDD_MV
#define USBUART_3500MV                     (3500u)

#define USBUART_CR1_REG_ENABLE             (0x01u)
#define USBUART_CR1_ENABLE_LOCK            (0x02u)
#define USBUART_CR1_BUS_ACTIVITY_SHIFT     (0x02u)
#define USBUART_CR1_BUS_ACTIVITY           ((uint8)(0x01u << USBUART_CR1_BUS_ACTIVITY_SHIFT))
#define USBUART_CR1_TRIM_MSB_EN            (0x08u)

#define USBUART_EP0_CNT_DATA_TOGGLE        (0x80u)
#define USBUART_EPX_CNT_DATA_TOGGLE        (0x80u)
#define USBUART_EPX_CNT0_MASK              (0x0Fu)
#define USBUART_EPX_CNTX_MSB_MASK          (0x07u)
#define USBUART_EPX_CNTX_ADDR_SHIFT        (0x04u)
#define USBUART_EPX_CNTX_ADDR_OFFSET       (0x10u)
#define USBUART_EPX_CNTX_CRC_COUNT         (0x02u)
#define USBUART_EPX_DATA_BUF_MAX           (512u)

#define USBUART_CR0_ENABLE                 (0x80u)

/* A 100 KHz clock is used for BUS reset count. Recommended is to count 10 pulses */
#define USBUART_BUS_RST_COUNT              (0x0au)

#define USBUART_USBIO_CR1_IOMODE           (0x20u)
#define USBUART_USBIO_CR1_USBPUEN          (0x04u)
#define USBUART_USBIO_CR1_DP0              (0x02u)
#define USBUART_USBIO_CR1_DM0              (0x01u)

#define USBUART_USBIO_CR0_TEN              (0x80u)
#define USBUART_USBIO_CR0_TSE0             (0x40u)
#define USBUART_USBIO_CR0_TD               (0x20u)
#define USBUART_USBIO_CR0_RD               (0x01u)

#define USBUART_FASTCLK_IMO_CR_USBCLK_ON   (0x40u)
#define USBUART_FASTCLK_IMO_CR_XCLKEN      (0x20u)
#define USBUART_FASTCLK_IMO_CR_FX2ON       (0x10u)

#define USBUART_ARB_EPX_CFG_RESET          (0x08u)
#define USBUART_ARB_EPX_CFG_CRC_BYPASS     (0x04u)
#define USBUART_ARB_EPX_CFG_DMA_REQ        (0x02u)
#define USBUART_ARB_EPX_CFG_IN_DATA_RDY    (0x01u)

#define USBUART_ARB_EPX_SR_IN_BUF_FULL     (0x01u)
#define USBUART_ARB_EPX_SR_DMA_GNT         (0x02u)
#define USBUART_ARB_EPX_SR_BUF_OVER        (0x04u)
#define USBUART_ARB_EPX_SR_BUF_UNDER       (0x08u)

#define USBUART_ARB_CFG_AUTO_MEM           (0x10u)
#define USBUART_ARB_CFG_MANUAL_DMA         (0x20u)
#define USBUART_ARB_CFG_AUTO_DMA           (0x40u)
#define USBUART_ARB_CFG_CFG_CPM            (0x80u)

#if(USBUART_EP_MM == USBUART__EP_DMAAUTO)
    #define USBUART_ARB_EPX_INT_MASK           (0x1Du)
#else
    #define USBUART_ARB_EPX_INT_MASK           (0x1Fu)
#endif /* End USBUART_EP_MM == USBUART__EP_DMAAUTO */
#define USBUART_ARB_INT_MASK       (uint8)((USBUART_DMA1_REMOVE ^ 1u) | \
                                            (uint8)((USBUART_DMA2_REMOVE ^ 1u) << 1u) | \
                                            (uint8)((USBUART_DMA3_REMOVE ^ 1u) << 2u) | \
                                            (uint8)((USBUART_DMA4_REMOVE ^ 1u) << 3u) | \
                                            (uint8)((USBUART_DMA5_REMOVE ^ 1u) << 4u) | \
                                            (uint8)((USBUART_DMA6_REMOVE ^ 1u) << 5u) | \
                                            (uint8)((USBUART_DMA7_REMOVE ^ 1u) << 6u) | \
                                            (uint8)((USBUART_DMA8_REMOVE ^ 1u) << 7u) )

#define USBUART_SIE_EP_INT_EP1_MASK        (0x01u)
#define USBUART_SIE_EP_INT_EP2_MASK        (0x02u)
#define USBUART_SIE_EP_INT_EP3_MASK        (0x04u)
#define USBUART_SIE_EP_INT_EP4_MASK        (0x08u)
#define USBUART_SIE_EP_INT_EP5_MASK        (0x10u)
#define USBUART_SIE_EP_INT_EP6_MASK        (0x20u)
#define USBUART_SIE_EP_INT_EP7_MASK        (0x40u)
#define USBUART_SIE_EP_INT_EP8_MASK        (0x80u)

#define USBUART_PM_ACT_EN_FSUSB            USBUART_USB__PM_ACT_MSK
#define USBUART_PM_STBY_EN_FSUSB           USBUART_USB__PM_STBY_MSK
#define USBUART_PM_AVAIL_EN_FSUSBIO        (0x10u)

#define USBUART_PM_USB_CR0_REF_EN          (0x01u)
#define USBUART_PM_USB_CR0_PD_N            (0x02u)
#define USBUART_PM_USB_CR0_PD_PULLUP_N     (0x04u)

#define USBUART_USB_CLK_ENABLE             (0x01u)

#define USBUART_DM_MASK                    USBUART_Dm__0__MASK
#define USBUART_DP_MASK                    USBUART_Dp__0__MASK

#define USBUART_DYN_RECONFIG_ENABLE        (0x01u)
#define USBUART_DYN_RECONFIG_EP_SHIFT      (0x01u)
#define USBUART_DYN_RECONFIG_RDY_STS       (0x10u)


#endif /* End CY_USBFS_USBUART_H */


/* [] END OF FILE */
