erebus-labs/PSU-VOC-SENSOR-2K14/Code/master_pcb/Erebus_Sensor.cydsn/codegentemp/RTC_INT.c

/*******************************************************************************
* File Name: RTC_INT.c
* Version 2.0
*
* Description:
*  This file contains the Interrupt Service Routine (ISR) for the RTC component.
*  This interrupt routine has entry pointes to overflow on time or date.
*
********************************************************************************
* Copyright 2008-2013, Cypress Semiconductor Corporation.  All rights reserved.
* You may use this file only in accordance with the license, terms, conditions,
* disclaimers, and limitations in the end user license agreement accompanying
* the software package with which this file was provided.
*******************************************************************************/

#include "RTC.h"
#include "CyLib.h"

/* Function Prototypes */
static void RTC_EverySecondHandler(void);
static void RTC_EveryMinuteHandler(void);
static void RTC_EveryHourHandler(void);
static void RTC_EveryDayHandler(void);
static void RTC_EveryWeekHandler(void);
static void RTC_EveryMonthHandler(void);
static void RTC_EveryYearHandler(void);


/*******************************************************************************
*  Place your includes, defines and code here
*******************************************************************************/
/* `#START RTC_ISR_DEFINITION` */
#include "globals.h"
#include "sample_handler.h"
#include "utility.h"
/* `#END` */


/*******************************************************************************
* Function Name:   RTC_EverySecondHandler
********************************************************************************
*
* Summary:
*  This function is called every second.
*
* Parameters:
*  None.
*
* Return:
*  None.
*
*******************************************************************************/
static void RTC_EverySecondHandler(void)
{
    /*  Place your every second handler code here. */
    /* `#START EVERY_SECOND_HANDLER_CODE` */
       
    if (mem_full_flag){
        return;
    }
    
    if (sample_unit == SAMPLE_SEC && sample_enable_flag){
        ++sample_interrupt_count;

        if (sample_interrupt_count == sample_interval)
        {
            take_sample_waiting = 1;
            sample_interrupt_count = 0;
        }
    }
        
    ++low_batt_blink_count;
    if ((low_batt_blink_count >= LOWBATT_BLINK_INTERVAL) && low_power_flag){
        low_batt_blink_count = 0;
        low_battery_blink_waiting = 1;
    }

    
    /* `#END` */
}


/*******************************************************************************
* Function Name:   RTC_EveryMinuteHandler
********************************************************************************
*
* Summary:
*  This function is called every minute.
*
* Parameters:
*  None.
*
* Return:
*  None.
*
*******************************************************************************/
static void RTC_EveryMinuteHandler(void)
{
    /*  Place your every minute handler code here. */
    /* `#START EVERY_MINUTE_HANDLER_CODE` */
    
    if (mem_full_flag){
        return;
    }
        
    if (sample_unit == SAMPLE_MIN && sample_enable_flag){
        ++sample_interrupt_count;

        if (sample_interrupt_count == sample_interval)
        {
            take_sample_waiting = 1;
            sample_interrupt_count = 0;
        }
    }
    
    ++battery_check_count;
    if (battery_check_count == BATT_CHECK_INTERVAL){
        battery_check_count = 0;
        battery_check_waiting = 1;
    }
    
    /* `#END` */
}


/*******************************************************************************
* Function Name:   RTC_EveryHourHandler
********************************************************************************
*
* Summary:
*  This function is called every hour.
*
* Parameters:
*  None.
*
* Return:
*  None.
*
*******************************************************************************/
static void RTC_EveryHourHandler(void)
{
    /*  Place your every hour handler code here. */
    /* `#START EVERY_HOUR_HANDLER_CODE` */
    
    if (mem_full_flag){
        return;
    }
        
    if (sample_enable_flag){
        ++sample_interrupt_count;

        if (sample_interrupt_count == sample_interval)
        {
            take_sample_waiting = 1;
            sample_interrupt_count = 0;
        }
    }
    /* `#END` */
}


/*******************************************************************************
* Function Name:   RTC_EveryDayHandler
********************************************************************************
*
* Summary:
*  This function is called every day.
*
* Parameters:
*  None.
*
* Return:
*  None.
*
*******************************************************************************/
static void RTC_EveryDayHandler(void)
{
    /*  Place your everyday handler code here. */
    /* `#START EVERY_DAY_HANDLER_CODE` */
    
    if (mem_full_flag){
        return;
    }
    
    if (sample_enable_flag){
        ++sample_interrupt_count;

        if (sample_interrupt_count == sample_interval)
        {
            take_sample_waiting = 1;
            sample_interrupt_count = 0;
        }
    }
    /* `#END` */
}


/*******************************************************************************
* Function Name:   RTC_EveryWeekHandler
********************************************************************************
*
* Summary:
*  This function is called every week.
*
* Parameters:
*  None.
*
* Return:
*  None.
*
*******************************************************************************/
static void RTC_EveryWeekHandler(void)
{
    /*  Place your every week handler code here. */
    /* `#START EVERY_WEEK_HANDLER_CODE` */
    /* `#END` */
}


/*******************************************************************************
* Function Name:   RTC_EveryMonthHandler
********************************************************************************
*
* Summary:
*  This function is called every month.
*
* Parameters:
*  None.
*
* Return:
*  None.
*
*******************************************************************************/
static void RTC_EveryMonthHandler(void)
{
    /*  Place your every month handler code here. */
    /* `#START EVERY_MONTH_HANDLER_CODE` */
    /* `#END` */
}


/*******************************************************************************
* Function Name:   RTC_EveryYearHandler
********************************************************************************
*
* Summary:
*  This function is called every year.
*
* Parameters:
*  None.
*
* Return:
*  None.
*
*******************************************************************************/
static void RTC_EveryYearHandler(void)
{
    /*  Place your every year handler code here. */
    /* `#START EVERY_YEAR_HANDLER_CODE` */
    /* `#END` */
}


/*******************************************************************************
* Function Name: RTC_ISR
********************************************************************************
*
* Summary:
*  This ISR is executed on 1PPS (one pulse per second) event.
*  Global interrupt must be enabled to invoke this ISR.
*  This interrupt trigs every second.
*
* Parameters:
*  None.
*
* Return:
*  None.
*
* Global variables:
* RTC_currentTimeDate, RTC_dstTimeDateStart,
*  RTC_dstTimeDateStop, RTC_dstTimeDateStart,
*  RTC_alarmCfgTimeDate, RTC_statusDateTime,
*  RTC_dstStartStatus, RTC_dstStartStatus,
*  RTC_dstStopStatus, RTC_alarmCurStatus: global
*  variables are used for the time/date, DST and alarm update procedure.
*
*  RTC_dstTimeDateStart and RTC_currentTimeDate:
*  are modified with the updated values.
*
*  RTC_statusDateTime, RTC_dstStartStatus,
*  RTC_dstStartStatus, RTC_dstStopStatus,
*  RTC_alarmCurStatus: global variables could be modified while
*  current time/date is updated.
*
* Side Effects:
*  Clears all interrupt status bits (react_int, limact_int, onepps_int, ctw_int,
*  and  ftw_int) in Power Manager Interrupt Status Register. If an interrupt
*  gets generated at the same time as a clear, the bit will remain set (which
*  causes another interrupt).
*
*******************************************************************************/
CY_ISR(RTC_ISR)
{
    uint8 RTC_tmp;

    /* Clear OPPS interrupt status flag */
    (void) CyPmReadStatus(CY_PM_ONEPPS_INT);

    /* Increment seconds counter */
    RTC_currentTimeDate.Sec++;

    /* Check if minute elapsed */
    if(RTC_currentTimeDate.Sec > RTC_MINUTE_ELAPSED)
    {
        /* Inc Min */
        RTC_currentTimeDate.Min++;

        /* Clear Sec */
        RTC_currentTimeDate.Sec = 0u;

        if(RTC_currentTimeDate.Min > RTC_HOUR_ELAPSED)
        {
            /* Inc HOUR */
            RTC_currentTimeDate.Hour++;

            /* Clear Min */
            RTC_currentTimeDate.Min = 0u;

            /* Day roll over */
            if(RTC_currentTimeDate.Hour > RTC_DAY_ELAPSED)
            {
                /* Inc DayOfMonth */
                RTC_currentTimeDate.DayOfMonth++;

                /* Clear Hour */
                RTC_currentTimeDate.Hour = 0u;

                /* Inc DayOfYear */
                RTC_currentTimeDate.DayOfYear++;

                /* Inc DayOfWeek */
                RTC_currentTimeDate.DayOfWeek++;

                /* Check DayOfWeek */
                if(RTC_currentTimeDate.DayOfWeek > RTC_WEEK_ELAPSED)
                {
                    /* start new week */
                    RTC_currentTimeDate.DayOfWeek = 1u;
                }

                /* Day of month roll over.
                * Check if day of month greater than 29 in February of leap year or
                * if day of month greater than 28 NOT in February of NON leap year or
                * if day of month greater than it should be in every month in non leap year
                */
                if(((0u != (RTC_statusDateTime & RTC_STATUS_LY)) &&
                    (RTC_currentTimeDate.Month == RTC_FEBRUARY)  &&
                    (RTC_currentTimeDate.DayOfMonth >
                             (RTC_daysInMonths[RTC_currentTimeDate.Month - 1u] + 1u))) ||
                   ((0u != (RTC_statusDateTime & RTC_STATUS_LY))  &&
                    (RTC_currentTimeDate.Month != RTC_FEBRUARY) &&
                    (RTC_currentTimeDate.DayOfMonth >
                                    RTC_daysInMonths[RTC_currentTimeDate.Month - 1u])) ||
                   ((0u == (RTC_statusDateTime & RTC_STATUS_LY))  &&
                    (RTC_currentTimeDate.DayOfMonth >
                                    RTC_daysInMonths[RTC_currentTimeDate.Month - 1u])))
                {
                    /* Inc Month */
                    RTC_currentTimeDate.Month++;

                    /* Set first day of month */
                    RTC_currentTimeDate.DayOfMonth = 1u;

                    /* Year roll over */
                    if(RTC_currentTimeDate.Month > RTC_YEAR_ELAPSED)
                    {
                        /* Inc Year */
                        RTC_currentTimeDate.Year++;

                        /* Set first month of year */
                        RTC_currentTimeDate.Month = 1u;

                        /* Set first day of year */
                        RTC_currentTimeDate.DayOfYear = 1u;

                        /* Is this year leap */
                        if(1u == RTC_LEAP_YEAR(RTC_currentTimeDate.Year))
                        {
                            /* Set leap year flag */
                            RTC_statusDateTime |= RTC_STATUS_LY;
                        }
                        else    /* not leap year */
                        {
                            /* Clear leap year */
                            RTC_statusDateTime &= (uint8)(~RTC_STATUS_LY);
                        }

                        /* Alarm YEAR */
                        if(0u != RTC_IS_BIT_SET(RTC_alarmCfgMask,
                                                             RTC_ALARM_YEAR_MASK))
                        {
                            /* Years match */
                            if(RTC_alarmCfgTimeDate.Year == RTC_currentTimeDate.Year)
                            {
                                /* Rise year alarm */
                                RTC_alarmCurStatus |= RTC_ALARM_YEAR_MASK;
                            }
                            else    /* Years do not match */
                            {
                                /* Clear year alarm */
                                RTC_alarmCurStatus &= (uint8)(~RTC_ALARM_YEAR_MASK);
                            }
                        } /* do not alarm year */

                        /* Set Alarm flag event */
                        RTC_tmp = RTC_alarmCfgMask;
                        RTC_SET_ALARM(RTC_tmp,
                                                   RTC_alarmCurStatus,
                                                   RTC_statusDateTime);

                        /* Every Year */
                        if(0u != RTC_IS_BIT_SET(RTC_intervalCfgMask,
                                                             RTC_INTERVAL_YEAR_MASK))
                        {
                            RTC_EveryYearHandler();
                        }

                    } /* Month > 12 */

                    /* Alarm MONTH */
                    if(0u != RTC_IS_BIT_SET(RTC_alarmCfgMask,
                                                         RTC_ALARM_MONTH_MASK))
                    {
                        if(RTC_alarmCfgTimeDate.Month == RTC_currentTimeDate.Month)
                        {
                            /* Set month alarm */
                            RTC_alarmCurStatus |= RTC_ALARM_MONTH_MASK;
                        }
                        else
                        {
                            /* Clear month alarm */
                            RTC_alarmCurStatus &= (uint8)(~RTC_ALARM_MONTH_MASK);
                        }
                    }   /* Month alarm is masked */

                    #if (1u == RTC_DST_FUNC_ENABLE)
                        if(RTC_dstTimeDateStop.Month == RTC_currentTimeDate.Month)
                        {
                            RTC_dstStopStatus |= RTC_DST_MONTH;
                        }
                        else
                        {
                            RTC_dstStopStatus &= (uint8)(~RTC_DST_MONTH);
                        }

                        if(RTC_dstTimeDateStart.Month == RTC_currentTimeDate.Month)
                        {
                            RTC_dstStartStatus |= RTC_DST_MONTH;
                        }
                        else
                        {
                            RTC_dstStartStatus &= (uint8)(~RTC_DST_MONTH);
                        }
                    #endif /* 1u == RTC_DST_FUNC_ENABLE */

                    /* Set Alarm flag event */
                    RTC_tmp = RTC_alarmCfgMask;
                    RTC_SET_ALARM(RTC_tmp,
                                               RTC_alarmCurStatus,
                                               RTC_statusDateTime);

                    /* Every Month */
                    if(0u != RTC_IS_BIT_SET(RTC_intervalCfgMask,
                                                         RTC_INTERVAL_MONTH_MASK))
                    {
                        RTC_EveryMonthHandler();
                    }
                }   /* Day roll over */

                /* Alarm DAYOFWEEK */
                if(0u != RTC_IS_BIT_SET(RTC_alarmCfgMask,
                                                     RTC_ALARM_DAYOFWEEK_MASK))
                {
                    if(RTC_alarmCfgTimeDate.DayOfWeek == RTC_currentTimeDate.DayOfWeek)
                    {
                        /* Set day of week alarm */
                        RTC_alarmCurStatus |= RTC_ALARM_DAYOFWEEK_MASK;
                    }
                    else
                    {
                        /* Clear day of week alarm */
                        RTC_alarmCurStatus &= (uint8)(~RTC_ALARM_DAYOFWEEK_MASK);
                    }
                }   /* Day of week alarm is masked */

                /* Alarm DAYOFYEAR */
                if(0u != RTC_IS_BIT_SET(RTC_alarmCfgMask,
                                                     RTC_ALARM_DAYOFYEAR_MASK))
                {
                    if(RTC_alarmCfgTimeDate.DayOfYear == RTC_currentTimeDate.DayOfYear)
                    {
                        /* Set day of year alarm */
                        RTC_alarmCurStatus |= RTC_ALARM_DAYOFYEAR_MASK;
                    }
                    else
                    {
                        /* Clear day of year alarm */
                        RTC_alarmCurStatus &= (uint8)(~RTC_ALARM_DAYOFYEAR_MASK);
                    }
                }   /* Day of year alarm is masked */

                /* Alarm DAYOFMONTH */
                if(0u != RTC_IS_BIT_SET(RTC_alarmCfgMask,
                         RTC_ALARM_DAYOFMONTH_MASK))
                {
                    if(RTC_alarmCfgTimeDate.DayOfMonth == RTC_currentTimeDate.DayOfMonth)
                    {
                        /* Set day of month alarm */
                        RTC_alarmCurStatus |= RTC_ALARM_DAYOFMONTH_MASK;
                    }
                    else
                    {
                        /* Clear day of month alarm */
                        RTC_alarmCurStatus &= (uint8)(~RTC_ALARM_DAYOFMONTH_MASK);
                    }
                }   /* Day of month alarm is masked */

                #if (1u == RTC_DST_FUNC_ENABLE)
                    if(RTC_dstTimeDateStop.DayOfMonth == RTC_currentTimeDate.DayOfMonth)
                    {
                        RTC_dstStopStatus |= RTC_DST_DAYOFMONTH;
                    }
                    else
                    {
                        RTC_dstStopStatus &= (uint8)(~RTC_DST_DAYOFMONTH);
                    }

                    if(RTC_dstTimeDateStart.DayOfMonth == RTC_currentTimeDate.DayOfMonth)
                    {
                        RTC_dstStartStatus |= RTC_DST_DAYOFMONTH;
                    }
                    else
                    {
                        RTC_dstStartStatus &= (uint8)(~RTC_DST_DAYOFMONTH);
                    }
                #endif /* 1u == RTC_DST_FUNC_ENABLE */

                /* Set Alarm flag event */
                RTC_tmp = RTC_alarmCfgMask;
                RTC_SET_ALARM(RTC_tmp,
                                           RTC_alarmCurStatus,
                                           RTC_statusDateTime);

                /* Every Day */
                if(0u != RTC_IS_BIT_SET(RTC_intervalCfgMask,
                         RTC_INTERVAL_DAY_MASK))
                {
                    RTC_EveryDayHandler();
                }

                if(1u == RTC_currentTimeDate.DayOfWeek)
                {
                    /* Every Week */
                    if(0u != RTC_IS_BIT_SET(RTC_intervalCfgMask,
                                                         RTC_INTERVAL_WEEK_MASK))
                    {
                       RTC_EveryWeekHandler();
                    }
                }

            } /* End of day roll over */

            /* Status set PM/AM flag */
            if(RTC_currentTimeDate.Hour < RTC_HALF_OF_DAY_ELAPSED)
            {
                /* AM Hour 00:00-11:59, flag zero */
                RTC_statusDateTime &= (uint8)(~RTC_STATUS_AM_PM);
            }
            else
            {
                /* PM Hour 12:00-23:59, flag set */
                RTC_statusDateTime |= RTC_STATUS_AM_PM;
            }

            #if (1u == RTC_DST_FUNC_ENABLE)
                if(RTC_dstTimeDateStop.Hour == RTC_currentTimeDate.Hour)
                {
                    RTC_dstStopStatus |= RTC_DST_HOUR;
                }
                else
                {
                    RTC_dstStopStatus &= (uint8)(~RTC_DST_HOUR);
                }

                if(RTC_dstTimeDateStart.Hour == RTC_currentTimeDate.Hour)
                {
                    RTC_dstStartStatus |= RTC_DST_HOUR;
                }
                else
                {
                RTC_dstStartStatus &= (uint8)(~RTC_DST_HOUR);
                }

                /* DST Enable ? */
                if(0u != RTC_IS_BIT_SET(RTC_dstModeType, RTC_DST_ENABLE))
                {
                    if(0u != RTC_IS_BIT_SET(RTC_statusDateTime, RTC_STATUS_DST))
                    {
                        if(0u != RTC_IS_BIT_SET(RTC_dstStopStatus, RTC_DST_HOUR |
                                                       RTC_DST_DAYOFMONTH | RTC_DST_MONTH))
                        {
                            /* Substruct from current value of minutes, number of minutes
                            * in DST offset which is out of complete hour
                            */
                            RTC_currentTimeDate.Min -=
                                                RTC_dstOffsetMin % (RTC_HOUR_ELAPSED + 1u);

                            /* Is minute value negative? */
                            if(RTC_currentTimeDate.Min > RTC_HOUR_ELAPSED)
                            {
                                /* Convert to the positive.
                                * HOUR_ELAPSED -     (~currentTimeDate.Min    ) ==
                                * HOUR_ELAPSED + 1 - (~currentTimeDate.Min + 1)
                                */
                                RTC_currentTimeDate.Min = RTC_HOUR_ELAPSED -
                                                             ((uint8)(~RTC_currentTimeDate.Min));

                                RTC_currentTimeDate.Hour--;
                            }

                            RTC_currentTimeDate.Hour -= RTC_dstOffsetMin /
                                                                     (RTC_HOUR_ELAPSED + 1u);

                            /* Day roll over
                            * Is hour value negative? */
                            if(RTC_currentTimeDate.Hour > RTC_DAY_ELAPSED)
                            {
                                /* Convert to the positive.
                                * DAY_ELAPSED - (~currentTimeDate.Hour) ==
                                * DAY_ELAPSED + 1 - (~currentTimeDate.Hour + 1)
                                */
                                RTC_currentTimeDate.Hour = RTC_DAY_ELAPSED -
                                                              ((uint8)(~RTC_currentTimeDate.Hour));

                                /* Status set PM/AM flag */
                                if(RTC_currentTimeDate.Hour < RTC_HALF_OF_DAY_ELAPSED)
                                {
                                    /* AM Hour 00:00-11:59, flag zero */
                                    RTC_statusDateTime &= (uint8)(~RTC_STATUS_AM_PM);
                                }
                                else
                                {
                                    /* PM Hour 12:00-23:59, flag set */
                                    RTC_statusDateTime |= RTC_STATUS_AM_PM;
                                }

                                RTC_currentTimeDate.DayOfMonth--;
                                RTC_currentTimeDate.DayOfYear--;
                                RTC_currentTimeDate.DayOfWeek--;

                                if(0u == RTC_currentTimeDate.DayOfWeek)
                                {
                                    RTC_currentTimeDate.DayOfWeek = RTC_DAYS_IN_WEEK;
                                }

                                if(0u == RTC_currentTimeDate.DayOfMonth)
                                {
                                    RTC_currentTimeDate.Month--;
                                    if(0u == RTC_currentTimeDate.Month)
                                    {
                                        RTC_currentTimeDate.Month = RTC_DECEMBER;

                                        RTC_currentTimeDate.DayOfMonth =
                                            RTC_daysInMonths[RTC_currentTimeDate.Month - 1u];

                                        RTC_currentTimeDate.Year--;

                                        if(1u == RTC_LEAP_YEAR(RTC_currentTimeDate.Year))
                                        {
                                            /* LP - true, else - false */
                                            RTC_statusDateTime |= RTC_STATUS_LY;
                                            RTC_currentTimeDate.DayOfYear =
                                                                                    RTC_DAYS_IN_LEAP_YEAR;
                                        }
                                        else
                                        {
                                            RTC_statusDateTime &= (uint8)(~RTC_STATUS_LY);
                                            RTC_currentTimeDate.DayOfYear = RTC_DAYS_IN_YEAR;
                                        }
                                        RTC_EveryYearHandler();
                                    }
                                    else
                                    {
                                        /* Day of month roll over.
                                        * Check if day of month February 29 of leap year
                                        */
                                        if((0u != (RTC_statusDateTime & RTC_STATUS_LY)) &&
                                            (RTC_currentTimeDate.Month == RTC_FEBRUARY))
                                        {
                                            RTC_currentTimeDate.DayOfMonth =
                                            RTC_daysInMonths[RTC_currentTimeDate.Month - 1u]
                                            + 1u;
                                        }
                                        else
                                        {
                                            RTC_currentTimeDate.DayOfMonth =
                                            RTC_daysInMonths[RTC_currentTimeDate.Month - 1u];
                                        }
                                    }
                                    RTC_EveryMonthHandler();
                                }
                                RTC_EveryDayHandler();
                            }
                            RTC_statusDateTime &= (uint8)(~RTC_STATUS_DST);
                            RTC_dstStopStatus = 0u;
                        }
                    }
                    else
                    {
                        if(0u != RTC_IS_BIT_SET(RTC_dstStartStatus,
                                                      (RTC_DST_HOUR | RTC_DST_DAYOFMONTH |
                                                       RTC_DST_MONTH)))
                        {
                            /* Add Hour and Min */
                            RTC_currentTimeDate.Min +=
                                                RTC_dstOffsetMin % (RTC_HOUR_ELAPSED + 1u);

                            if(RTC_currentTimeDate.Min > RTC_HOUR_ELAPSED)
                            {
                                /* Adjust Min */
                                RTC_currentTimeDate.Min -= (RTC_HOUR_ELAPSED + 1u);
                                RTC_currentTimeDate.Hour++;
                            }

                            RTC_currentTimeDate.Hour += RTC_dstOffsetMin /
                                                                     (RTC_HOUR_ELAPSED + 1u);

                            if(RTC_currentTimeDate.Hour > RTC_DAY_ELAPSED)
                            {
                                /* Adjust hour, add day */
                                RTC_currentTimeDate.Hour -= (RTC_DAY_ELAPSED + 1u);

                                /* Status set PM/AM flag */
                                if(RTC_currentTimeDate.Hour < RTC_HALF_OF_DAY_ELAPSED)
                                {
                                    /* AM Hour 00:00-11:59, flag zero */
                                    RTC_statusDateTime &= (uint8)(~RTC_STATUS_AM_PM);
                                }
                                else
                                {
                                    /* PM Hour 12:00-23:59, flag set */
                                    RTC_statusDateTime |= RTC_STATUS_AM_PM;
                                }

                                RTC_currentTimeDate.DayOfMonth++;
                                RTC_currentTimeDate.DayOfYear++;
                                RTC_currentTimeDate.DayOfWeek++;

                                if(RTC_currentTimeDate.DayOfWeek > RTC_WEEK_ELAPSED)
                                {
                                    RTC_currentTimeDate.DayOfWeek = 1u;
                                }

                                /* Day of month roll over.
                                * Check if day of month greater than 29 in February of leap year or
                                * if day of month greater than 28 NOT in February of NON leap year or
                                * if day of month greater than it should be in every month in non leap year
                                */
                                if(((0u != (RTC_statusDateTime & RTC_STATUS_LY)) &&
                                    (RTC_currentTimeDate.Month == RTC_FEBRUARY)  &&
                                    (RTC_currentTimeDate.DayOfMonth >
                                  (RTC_daysInMonths[RTC_currentTimeDate.Month - 1u] + 1u))) ||
                                   ((0u != (RTC_statusDateTime & RTC_STATUS_LY)) &&
                                    (RTC_currentTimeDate.Month != RTC_FEBRUARY)  &&
                                    (RTC_currentTimeDate.DayOfMonth >
                                     RTC_daysInMonths[RTC_currentTimeDate.Month - 1u])) ||
                                   ((0u == (RTC_statusDateTime & RTC_STATUS_LY)) &&
                                    (RTC_currentTimeDate.DayOfMonth >
                                     RTC_daysInMonths[RTC_currentTimeDate.Month - 1u])))
                                {
                                    RTC_currentTimeDate.Month++;
                                    RTC_currentTimeDate.DayOfMonth = 1u;
                                    if(RTC_currentTimeDate.Month > RTC_YEAR_ELAPSED)
                                    {
                                        RTC_currentTimeDate.Month = RTC_JANUARY;
                                        RTC_currentTimeDate.Year++;

                                        if(1u == RTC_LEAP_YEAR(RTC_currentTimeDate.Year))
                                        {
                                            /* LP - true, else - false */
                                            RTC_statusDateTime |= RTC_STATUS_LY;
                                        }
                                        else
                                        {
                                            RTC_statusDateTime &= (uint8)(~RTC_STATUS_LY);
                                        }
                                        RTC_currentTimeDate.DayOfYear = 1u;

                                        RTC_EveryYearHandler();
                                    }
                                    RTC_EveryMonthHandler();
                                }
                                RTC_EveryDayHandler();
                            }
                            RTC_statusDateTime |= RTC_STATUS_DST;
                            RTC_dstStartStatus = 0u;

                            /* Month */
                            if(RTC_dstTimeDateStop.Month == RTC_currentTimeDate.Month)
                            {
                                RTC_dstStopStatus |= RTC_DST_MONTH;
                            }
                            else
                            {
                                RTC_dstStopStatus &= (uint8)(~RTC_DST_MONTH);
                            }

                            /* DayOfMonth */
                            if(RTC_dstTimeDateStop.DayOfMonth ==
                                                                            RTC_currentTimeDate.DayOfMonth)
                            {
                                RTC_dstStopStatus |= RTC_DST_DAYOFMONTH;
                            }
                            else
                            {
                                RTC_dstStopStatus &= (uint8)(~RTC_DST_DAYOFMONTH);
                            }
                        }
                    }

                    /* Alarm DAYOFWEEK */
                    if(0u != RTC_IS_BIT_SET(RTC_alarmCfgMask,
                                                         RTC_ALARM_DAYOFWEEK_MASK))
                    {
                        if(RTC_alarmCfgTimeDate.DayOfWeek == RTC_currentTimeDate.DayOfWeek)
                        {
                            RTC_alarmCurStatus |= RTC_ALARM_DAYOFWEEK_MASK;
                        }
                        else
                        {
                            RTC_alarmCurStatus &= (uint8)(~RTC_ALARM_DAYOFWEEK_MASK);
                        }
                    }

                    /* Alarm DAYOFYEAR */
                    if(0u != RTC_IS_BIT_SET(RTC_alarmCfgMask,
                                                         RTC_ALARM_DAYOFYEAR_MASK))
                    {
                        if(RTC_alarmCfgTimeDate.DayOfYear == RTC_currentTimeDate.DayOfYear)
                        {
                            RTC_alarmCurStatus |= RTC_ALARM_DAYOFYEAR_MASK;
                        }
                        else
                        {
                            RTC_alarmCurStatus &= (uint8)(~RTC_ALARM_DAYOFYEAR_MASK);
                        }
                    }

                    /* Alarm DAYOFMONTH */
                    if(0u != RTC_IS_BIT_SET(RTC_alarmCfgMask,
                                                         RTC_ALARM_DAYOFMONTH_MASK))
                    {
                        if(RTC_alarmCfgTimeDate.DayOfMonth == RTC_currentTimeDate.DayOfMonth)
                        {
                            RTC_alarmCurStatus |= RTC_ALARM_DAYOFMONTH_MASK;
                        }
                        else
                        {
                            RTC_alarmCurStatus &= (uint8)(~RTC_ALARM_DAYOFMONTH_MASK);
                        }
                    }

                    /* Alarm MONTH */
                    if(0u != RTC_IS_BIT_SET(RTC_alarmCfgMask,
                                                         RTC_ALARM_MONTH_MASK))
                    {
                        if(RTC_alarmCfgTimeDate.Month == RTC_currentTimeDate.Month)
                        {
                            RTC_alarmCurStatus |= RTC_ALARM_MONTH_MASK;
                        }
                        else
                        {
                            RTC_alarmCurStatus &= (uint8)(~RTC_ALARM_MONTH_MASK);
                        }
                    }

                    /* Alarm YEAR */
                    if(0u != RTC_IS_BIT_SET(RTC_alarmCfgMask,
                                                         RTC_ALARM_YEAR_MASK))
                    {
                        if(RTC_alarmCfgTimeDate.Year == RTC_currentTimeDate.Year)
                        {
                            RTC_alarmCurStatus |= RTC_ALARM_YEAR_MASK;
                        }
                        else
                        {
                            RTC_alarmCurStatus &= (uint8)(~RTC_ALARM_YEAR_MASK);
                        }
                    }

                    /* Set Alarm flag event */
                    RTC_tmp = RTC_alarmCfgMask;
                    RTC_SET_ALARM(RTC_tmp,
                                               RTC_alarmCurStatus,
                                               RTC_statusDateTime);
                }
            #endif /* 1u == RTC_DST_FUNC_ENABLE */

            /* Alarm HOUR */
            if(0u != RTC_IS_BIT_SET(RTC_alarmCfgMask, RTC_ALARM_HOUR_MASK))
            {
                if(RTC_alarmCfgTimeDate.Hour == RTC_currentTimeDate.Hour)
                {
                    RTC_alarmCurStatus |= RTC_ALARM_HOUR_MASK;
                }
                else
                {
                    RTC_alarmCurStatus &= (uint8)(~RTC_ALARM_HOUR_MASK);
                }
            }

            /* Set Alarm flag event */
            RTC_tmp = RTC_alarmCfgMask;
            RTC_SET_ALARM(RTC_tmp,
                                       RTC_alarmCurStatus,
                                       RTC_statusDateTime);

            /* Every Hour */
            if(0u != RTC_IS_BIT_SET(RTC_intervalCfgMask, RTC_INTERVAL_HOUR_MASK))
            {
                RTC_EveryHourHandler();
            }
        } /* Min > 59 = Hour */

        /* Alarm MIN */
        if(0u != RTC_IS_BIT_SET(RTC_alarmCfgMask, RTC_ALARM_MIN_MASK))
        {
            if(RTC_alarmCfgTimeDate.Min == RTC_currentTimeDate.Min)
            {
                RTC_alarmCurStatus |= RTC_ALARM_MIN_MASK;
            }
            else
            {
                RTC_alarmCurStatus &= (uint8)(~RTC_ALARM_MIN_MASK);
            }
        }

        /* Set Alarm flag event */
        RTC_tmp = RTC_alarmCfgMask;
        RTC_SET_ALARM(RTC_tmp,
                                   RTC_alarmCurStatus,
                                   RTC_statusDateTime);

        /* Every Min */
        if(0u != RTC_IS_BIT_SET(RTC_intervalCfgMask, RTC_INTERVAL_MIN_MASK))
        {
            RTC_EveryMinuteHandler();
        }
    } /* Sec */

    /* Alarm SEC */
    if(0u != RTC_IS_BIT_SET(RTC_alarmCfgMask, RTC_ALARM_SEC_MASK))
    {
        if(RTC_alarmCfgTimeDate.Sec == RTC_currentTimeDate.Sec)
        {
            RTC_alarmCurStatus |= RTC_ALARM_SEC_MASK;
        }
        else
        {
            RTC_alarmCurStatus &= (uint8)(~RTC_ALARM_SEC_MASK);
        }
    }

    /* Set Alarm flag event */
    RTC_tmp = RTC_alarmCfgMask;
    RTC_SET_ALARM(RTC_tmp, RTC_alarmCurStatus, RTC_statusDateTime);

    /* Execute every second handler if needed */
    if(0u != RTC_IS_BIT_SET(RTC_intervalCfgMask, RTC_INTERVAL_SEC_MASK))
    {
        RTC_EverySecondHandler();
    }

}


/* [] END OF FILE */
