erebus-labs/PSU-VOC-SENSOR-2K14/Code/master_pcb/Erebus_Sensor.cydsn/codegentemp/USBUART_audio.c

/*******************************************************************************
* File Name: USBUART_audio.c
* Version 2.60
*
* Description:
*  USB AUDIO Class request handler.
*
* Note:
*
********************************************************************************
* Copyright 2008-2013, Cypress Semiconductor Corporation.  All rights reserved.
* You may use this file only in accordance with the license, terms, conditions,
* disclaimers, and limitations in the end user license agreement accompanying
* the software package with which this file was provided.
*******************************************************************************/

#include "USBUART.h"

#if defined(USBUART_ENABLE_AUDIO_CLASS)

#include "USBUART_audio.h"
#include "USBUART_pvt.h"
#if defined(USBUART_ENABLE_MIDI_STREAMING) 
    #include "USBUART_midi.h"
#endif /* End USBUART_ENABLE_MIDI_STREAMING*/


/***************************************
* Custom Declarations
***************************************/

/* `#START CUSTOM_DECLARATIONS` Place your declaration here */

/* `#END` */


#if !defined(USER_SUPPLIED_AUDIO_HANDLER)


/***************************************
*    AUDIO Variables
***************************************/

#if defined(USBUART_ENABLE_AUDIO_STREAMING)
    volatile uint8 USBUART_currentSampleFrequency[USBUART_MAX_EP][USBUART_SAMPLE_FREQ_LEN];
    volatile uint8 USBUART_frequencyChanged;
    volatile uint8 USBUART_currentMute;
    volatile uint8 USBUART_currentVolume[USBUART_VOLUME_LEN];
    volatile uint8 USBUART_minimumVolume[USBUART_VOLUME_LEN] = {USBUART_VOL_MIN_LSB,
                                                                                  USBUART_VOL_MIN_MSB};
    volatile uint8 USBUART_maximumVolume[USBUART_VOLUME_LEN] = {USBUART_VOL_MAX_LSB,
                                                                                  USBUART_VOL_MAX_MSB};
    volatile uint8 USBUART_resolutionVolume[USBUART_VOLUME_LEN] = {USBUART_VOL_RES_LSB,
                                                                                     USBUART_VOL_RES_MSB};
#endif /* End USBUART_ENABLE_AUDIO_STREAMING */


/*******************************************************************************
* Function Name: USBUART_DispatchAUDIOClassRqst
********************************************************************************
*
* Summary:
*  This routine dispatches class requests
*
* Parameters:
*  None.
*
* Return:
*  requestHandled
*
* Global variables:
*   USBUART_currentSampleFrequency: Contains the current audio Sample
*       Frequency. It is set by the Host using SET_CUR request to the endpoint.
*   USBUART_frequencyChanged: This variable is used as a flag for the
*       user code, to be aware that Host has been sent request for changing
*       Sample Frequency. Sample frequency will be sent on the next OUT
*       transaction. It is contains endpoint address when set. The following
*       code is recommended for detecting new Sample Frequency in main code:
*       if((USBUART_frequencyChanged != 0) &&
*       (USBUART_transferState == USBUART_TRANS_STATE_IDLE))
*       {
*          USBUART_frequencyChanged = 0;
*       }
*       USBUART_transferState variable is checked to be sure that
*             transfer completes.
*   USBUART_currentMute: Contains mute configuration set by Host.
*   USBUART_currentVolume: Contains volume level set by Host.
*
* Reentrant:
*  No.
*
*******************************************************************************/
uint8 USBUART_DispatchAUDIOClassRqst(void) 
{
    uint8 requestHandled = USBUART_FALSE;

    #if defined(USBUART_ENABLE_AUDIO_STREAMING)
        uint8 epNumber;
        epNumber = CY_GET_REG8(USBUART_wIndexLo) & USBUART_DIR_UNUSED;
    #endif /* End USBUART_ENABLE_AUDIO_STREAMING */

    if ((CY_GET_REG8(USBUART_bmRequestType) & USBUART_RQST_DIR_MASK) == USBUART_RQST_DIR_D2H)
    {
        /* Control Read */
        if((CY_GET_REG8(USBUART_bmRequestType) & USBUART_RQST_RCPT_MASK) == \
                                                                                    USBUART_RQST_RCPT_EP)
        {
            /* Endpoint */
            switch (CY_GET_REG8(USBUART_bRequest))
            {
                case USBUART_GET_CUR:
                #if defined(USBUART_ENABLE_AUDIO_STREAMING)
                    if(CY_GET_REG8(USBUART_wValueHi) == USBUART_SAMPLING_FREQ_CONTROL)
                    {
                         /* Endpoint Control Selector is Sampling Frequency */
                        USBUART_currentTD.wCount = USBUART_SAMPLE_FREQ_LEN;
                        USBUART_currentTD.pData  = USBUART_currentSampleFrequency[epNumber];
                        requestHandled   = USBUART_InitControlRead();
                    }
                #endif /* End USBUART_ENABLE_AUDIO_STREAMING */

                /* `#START AUDIO_READ_REQUESTS` Place other request handler here */

                /* `#END` */
                    break;
                default:
                    break;
            }
        }
        else if((CY_GET_REG8(USBUART_bmRequestType) & USBUART_RQST_RCPT_MASK) == \
                                                                                    USBUART_RQST_RCPT_IFC)
        {
            /* Interface or Entity ID */
            switch (CY_GET_REG8(USBUART_bRequest))
            {
                case USBUART_GET_CUR:
                #if defined(USBUART_ENABLE_AUDIO_STREAMING)
                    if(CY_GET_REG8(USBUART_wValueHi) == USBUART_MUTE_CONTROL)
                    {
                        /* `#START MUTE_CONTROL_GET_REQUEST` Place multi-channel handler here */

                        /* `#END` */
                        
                         /* Entity ID Control Selector is MUTE */
                        USBUART_currentTD.wCount = 1u;
                        USBUART_currentTD.pData  = &USBUART_currentMute;
                        requestHandled   = USBUART_InitControlRead();
                    }
                    else if(CY_GET_REG8(USBUART_wValueHi) == USBUART_VOLUME_CONTROL)
                    {
                        /* `#START VOLUME_CONTROL_GET_REQUEST` Place multi-channel handler here */

                        /* `#END` */

                        /* Entity ID Control Selector is VOLUME, */
                        USBUART_currentTD.wCount = USBUART_VOLUME_LEN;
                        USBUART_currentTD.pData  = USBUART_currentVolume;
                        requestHandled   = USBUART_InitControlRead();
                    }
                    else
                    {
                        /* `#START OTHER_GET_CUR_REQUESTS` Place other request handler here */

                        /* `#END` */
                    }
                    break;
                case USBUART_GET_MIN:    /* GET_MIN */
                    if(CY_GET_REG8(USBUART_wValueHi) == USBUART_VOLUME_CONTROL)
                    {
                        /* Entity ID Control Selector is VOLUME, */
                        USBUART_currentTD.wCount = USBUART_VOLUME_LEN;
                        USBUART_currentTD.pData  = &USBUART_minimumVolume[0];
                        requestHandled   = USBUART_InitControlRead();
                    }
                    break;
                case USBUART_GET_MAX:    /* GET_MAX */
                    if(CY_GET_REG8(USBUART_wValueHi) == USBUART_VOLUME_CONTROL)
                    {
                        /* Entity ID Control Selector is VOLUME, */
                        USBUART_currentTD.wCount = USBUART_VOLUME_LEN;
                        USBUART_currentTD.pData  = &USBUART_maximumVolume[0];
                        requestHandled   = USBUART_InitControlRead();
                    }
                    break;
                case USBUART_GET_RES:    /* GET_RES */
                    if(CY_GET_REG8(USBUART_wValueHi) == USBUART_VOLUME_CONTROL)
                    {
                         /* Entity ID Control Selector is VOLUME, */
                        USBUART_currentTD.wCount = USBUART_VOLUME_LEN;
                        USBUART_currentTD.pData  = &USBUART_resolutionVolume[0];
                        requestHandled   = USBUART_InitControlRead();
                    }
                    break;
                /* The contents of the status message is reserved for future use.
                *  For the time being, a null packet should be returned in the data stage of the
                *  control transfer, and the received null packet should be ACKed.
                */
                case USBUART_GET_STAT:
                        USBUART_currentTD.wCount = 0u;
                        requestHandled   = USBUART_InitControlWrite();

                #endif /* End USBUART_ENABLE_AUDIO_STREAMING */

                /* `#START AUDIO_WRITE_REQUESTS` Place other request handler here */

                /* `#END` */
                    break;
                default:
                    break;
            }
        }
        else
        {   /* USBUART_RQST_RCPT_OTHER */
        }
    }
    else if ((CY_GET_REG8(USBUART_bmRequestType) & USBUART_RQST_DIR_MASK) == \
                                                                                    USBUART_RQST_DIR_H2D)
    {
        /* Control Write */
        if((CY_GET_REG8(USBUART_bmRequestType) & USBUART_RQST_RCPT_MASK) == \
                                                                                    USBUART_RQST_RCPT_EP)
        {
            /* Endpoint */
            switch (CY_GET_REG8(USBUART_bRequest))
            {
                case USBUART_SET_CUR:
                #if defined(USBUART_ENABLE_AUDIO_STREAMING)
                    if(CY_GET_REG8(USBUART_wValueHi) == USBUART_SAMPLING_FREQ_CONTROL)
                    {
                         /* Endpoint Control Selector is Sampling Frequency */
                        USBUART_currentTD.wCount = USBUART_SAMPLE_FREQ_LEN;
                        USBUART_currentTD.pData  = USBUART_currentSampleFrequency[epNumber];
                        requestHandled   = USBUART_InitControlWrite();
                        USBUART_frequencyChanged = epNumber;
                    }
                #endif /* End USBUART_ENABLE_AUDIO_STREAMING */

                /* `#START AUDIO_SAMPLING_FREQ_REQUESTS` Place other request handler here */

                /* `#END` */
                    break;
                default:
                    break;
            }
        }
        else if((CY_GET_REG8(USBUART_bmRequestType) & USBUART_RQST_RCPT_MASK) == \
                                                                                    USBUART_RQST_RCPT_IFC)
        {
            /* Interface or Entity ID */
            switch (CY_GET_REG8(USBUART_bRequest))
            {
                case USBUART_SET_CUR:
                #if defined(USBUART_ENABLE_AUDIO_STREAMING)
                    if(CY_GET_REG8(USBUART_wValueHi) == USBUART_MUTE_CONTROL)
                    {
                        /* `#START MUTE_SET_REQUEST` Place multi-channel handler here */

                        /* `#END` */

                        /* Entity ID Control Selector is MUTE */
                        USBUART_currentTD.wCount = 1u;
                        USBUART_currentTD.pData  = &USBUART_currentMute;
                        requestHandled   = USBUART_InitControlWrite();
                    }
                    else if(CY_GET_REG8(USBUART_wValueHi) == USBUART_VOLUME_CONTROL)
                    {
                        /* `#START VOLUME_CONTROL_SET_REQUEST` Place multi-channel handler here */

                        /* `#END` */

                        /* Entity ID Control Selector is VOLUME */
                        USBUART_currentTD.wCount = USBUART_VOLUME_LEN;
                        USBUART_currentTD.pData  = USBUART_currentVolume;
                        requestHandled   = USBUART_InitControlWrite();
                    }
                    else
                    {
                        /* `#START OTHER_SET_CUR_REQUESTS` Place other request handler here */

                        /* `#END` */
                    }
                #endif /* End USBUART_ENABLE_AUDIO_STREAMING */

                /* `#START AUDIO_CONTROL_SEL_REQUESTS` Place other request handler here */

                /* `#END` */
                    break;
                default:
                    break;
            }
        }
        else
        {   /* USBUART_RQST_RCPT_OTHER */
        }
    }
    else
    {   /* requestHandled is initialized as FALSE by default */
    }

    return(requestHandled);
}


#endif /* USER_SUPPLIED_AUDIO_HANDLER */
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
