erebus-labs/PSU-VOC-SENSOR-2K14/(commit log)

2014-01-13 Flowchart/State Diagram
    This is just meant to show the general workflow of the system.
2014-01-14 Added "flexible" to objective. Lessened approval slots.
2014-01-18 Temp Sensor
2014-01-20 Added microcontroller specifications for top 3 candidates
    [Microcontroller_Specs.xlsx]
2014-01-22 Updated uController specs
    [Microcontroller_Specs.xlsx]
2014-01-23 Updated Microcontroller_Specs.xlsx with PCB costs
    [Microcontroller_Specs.xlsx]
2014-01-31 Removed obsolete documents
    [Microcontroller_Specs.xlsx]
2014-01-31 Possible emperature sensor
2014-01-31 Temperature sensor
    Cheaper version of previous one.
2014-02-16 Added Highlights to ADC Section
2014-02-16 Added Cypress ADC Example
2014-02-16 Added ADC Datasheet with Highlights
2014-02-16 Added Figaro Sensor Datasheets with Highlights.
2014-02-23 Early version of main board schematic
    [Main_Board.sch]
2014-03-03 Initial push of project files
    [EEPROM_Design01.sdf, Erebus_Sensor.sdf]
2014-03-14 Initial Push of Max Code Folder
    [ADCtoEEPROM.sdf, Em_EEPROM_Example01.sdf]
2014-03-14 Added dev board user guide
2014-03-15 LED blink project added - blink rate modified interrupt on VBUS pin
    [Erebus_Sensor.sdf]
2014-03-21 Mac Code Update
    [ADCtoEEPROM.sdf]
2014-03-24 Updated Scott Project files, added datasheets, initial push of Python Script
    [EEPROM_Design01.sdf, Erebus_Sensor.sdf]
2014-03-27 Added USB communication protocol and EEPROM access functions
    [Erebus_Sensor.sdf]
2014-03-27 Repush of Code
    [ADCtoEEPROM.sdf]
2014-03-27 Repush Repush
    [ADCtoEEPROM.sdf]
2014-03-27 Created Demo Build. Merged Code
    [ADCtoEEPROM.sdf, Erebus_Sensor.sdf]
2014-03-28 Push Code
    [Erebus_Sensor.sdf]
2014-03-28 Added Interrupt Documentation
2014-03-28 Implemented EEPROM variables, added ErebusSensor class to Python scripts
    [Erebus_Sensor.sdf]
2014-03-28 Fixed Data dump methods
    [Erebus_Sensor.sdf]
2014-03-29 Updated Schematic
    Grounds and voltages are not set yet. Most are place holders for the
    moment.
    [Main_Board.sch]
2014-03-30 Update serialnum.py to include LICENSE from source
    Since external distribution may occur with current code base - copying over license for serial enumeration code segment, but limiting scope to this file.
2014-04-01 Added files for Bryan
    Added code to folder for testing power management and RTC interrupt
    controls.
    [Erebus_Sensor.sdf]
2014-04-02 Initial Push
    [BOM.ods]
2014-04-02 Implemented EEPROM variable pointers
    [Erebus_Sensor.sdf]
2014-04-02 Changed incoming stream parsing to count bytes instead of data samples
2014-04-02 Initial push of master project copy
    [Erebus_Sensor.sdf]
2014-04-09 Update push
    [BOM.ods, BOM.xls]
2014-04-10 Added hard_reset() and EEPROM variables, removed blinking LED
    [Erebus_Sensor.sdf, USB_UART01.sdf]
2014-04-10 Updated master to match Scott code from commit 5fe109704ac546addd07589f49c463d76ea794e6
    [Erebus_Sensor.sdf, USB_UART01.sdf]
2014-04-10 Updated PM code, added reference doc
    Added RTC interrupt mask functions
    Added RTC sample unit check
    Added Sample code
    Added C reference document
    [Erebus_Sensor.sdf]
2014-04-13 Updated GUI Layout: Added buttons, frames, and menu
2014-04-14 Restructured GUI file layout. Began integrating sensor class with GUI - sensor now connects.
2014-04-15 Add switcher circuit
2014-04-15 BOM and schematic update
    Still missing push button interface and sensor breakouts
    [BOM.ods, BOM.xls]
2014-04-18 Power Management & Sampling
    Added sample interval counter
    Added interrupt mask for sample units
    Added sleep functionality
    Added take sample functionality
    [Erebus_Sensor.sdf]
2014-04-20 File Cleaning
    [BOM.ods, BOM.xls]
2014-04-23 Misc changes to power mgmt code
2014-04-26 Added get configuration and apply configuration callbacks to GUI, added code for multiple sample block transfer <-- untested
2014-04-26 Massive changes to master. Rearranged layout, added multiple sample block data support, added button interrupts, added send configuration routine, added data sample block headers
    [Erebus_Sensor.sdf, USB_UART01.sdf]
2014-04-26 Small fix on pin1 of psoc
    [BOM.xls]
2014-04-26 Changed command format to single byte, changes settings to single bytes
    [Erebus_Sensor.sdf, USB_UART01.sdf]
2014-04-28 Fixed applying and retrieving settings changes
    [Erebus_Sensor.sdf]
2014-04-28 Created BreadBoardBuild in Master folder. Began Pin assign
    USB is Set. VDDD VDDA VDDIO Set. Questions on JTAG
2014-04-28 Fixed multiple sample block transfer and button interrupts
    [Erebus_Sensor.sdf]
2014-04-28 Fixed multiple sample block transfers
    [gui.py, interface.py]
2014-04-29 Mostly updates with some sensor stuff
    [BOM.ods, BOM.xls, Gas_Sensor.brd, Gas_Sensor.sch, Light_Sensor.sch, Light_Sensor_Layout.brd, Light_Sensor_Layout.sch, Main_Board.sch]
2014-04-30 Fixed timestamps on data samples
    [Erebus_Sensor.sdf]
2014-04-30 Fixed transfers of data blocks that span multiple UART buffer lengths of 64 bytes
    [interface.py]
2014-05-01 Updates for pin assignments
    [BOM.ods, BOM.xls, Main_Board.sch, Main_Board_SW.sch]
2014-05-02 Fixed sample function not being called Changed sleep function call values to match Cypress defined variables Changed sleep time to "none"
    Sample counter not correctly detecting when sample should occur based on given interval
    [cyfitter.h, main.c]
2014-05-02 Removed LED test code from everywhere but the sample function
2014-05-02 Pin updates and initial board push
    [Main_Board_SW.brd, Main_Board_SW.sch]
2014-05-02 Button Updates
    [Main_Board_SW.brd, Main_Board_SW.sch]
2014-05-02 Sleep functionality working Sample functionality working
    Removed unneeded interval unit masks
    standardized function names
2014-05-02 New Build in BreadBoardBuild
    [Erebus_Sensor.sdf]
2014-05-02 Fixed interface.py handling of multi-packet data transfers, cleaned up unnecessary files
    [interface.py]
2014-05-02 Fixed multi-packet data dumps with extra interlocking and zero-length packets
    [Erebus_Sensor.sdf]
2014-05-06 Cleaned up some power code
    Added initial poster template with base design
2014-05-07 Broken code checkpoint. LED controls added, debouncers removed, sleep code ifdef'd off
    [Erebus_Sensor.sdf]
2014-05-07 Fixed PWM/LEDs. Fixed Debouncing. Wake from sleep still broken.
    [Erebus_Sensor.sdf]
2014-05-08 Switching Layout Placed
    [Main_Board_SW.brd]
2014-05-08 Fixed sample start/stop with sleep. Added RGB LED Control. Reorganized code tree and added macro and global header files.
    [Erebus_Sensor.sdf]
2014-05-08 Layout Update
    [Gas_Sensor.brd, Gas_Sensor.sch, LDO.brd, LDO.sch, Light_Sensor.sch, Light_Sensor_Layout.brd, Light_Sensor_Layout.sch, Main_Board.sch]
2014-05-08 Updated Sensor Module PCBs
    Switched Ethernet I/O. Rerouted PCB
    [Gas_Sensor.brd, Gas_Sensor.sch, Light_Sensor_Layout.brd, Light_Sensor_Layout.sch]
2014-05-08 Began PCB Verify. Slight Modifications to Gas Sensor Module during verify.
    [BOM.xls, Gas_Sensor.brd, Gas_Sensor.sch, Light_Sensor_Layout.sch]
2014-05-09 LDO Layout
    [LDO.brd, LDO.sch]
2014-05-10 Added Drill Holes. Moved Traces. Moved Silkscreen References
    [Main_Board_SW.brd, Main_Board_SW.sch]
2014-05-10 pull req
    [Gas_Sensor.brd]
2014-05-11 Added low power LED blinking. Added more 3rd party docs.
    [Erebus_Sensor.sdf]
2014-05-11 Layout for final inspection
    [BOM.ods, BOM.xls, Gas_Sensor.brd, Gas_Sensor.sch, LDO.brd, LDO.sch, Light_Sensor_Layout.brd, Light_Sensor_Layout.sch]
2014-05-12 Added Project Report outline
    Updated Poster
    +Team Info
    +Picture of schematic
    +Picture of board layout
2014-05-12 Manufacturer part number updates
    [BOM.ods, BOM.xls]
2014-05-12 PCB Verify Push. Status: In Progress
    [BOM.xls, LDO.brd, Main_Board_SW2.brd, Main_Board_SW2.sch]
2014-05-12 Updated Switcher Board
    [Main_Board_SW2.brd]
2014-05-12 PCB Push
    [BOM.xls, Main_Board_SW2.brd, Main_Board_SW2.sch]
2014-05-13 PCB Verified. Add Battery Sense
    [BOM.xls, Gas_Sensor.sch, LDO.brd, Main_Board_SW.brd, Main_Board_SW.sch, Main_Board_SW2.brd, Main_Board_SW2.sch]
2014-05-13 Batter Sense
    [Main_Board_SW2.brd]
2014-05-13 Hopeful pull
    [BOM.ods]
2014-05-13 Added Battery Sense to LDO
    [LDO.brd, LDO.sch]
2014-05-13 Updated Board PNGs
    [LDO.brd]
2014-05-13 Last layout sync of night
    [Main_Board_SW2.brd, Main_Board_SW2.sch]
2014-05-15 Dimensions for each of the boards
    [Light_Sensor_Layout.brd]
2014-05-15 Updated poster
    [Erebus_Sensor.sdf]
2014-05-17 Added board enclosure files
2014-05-19 Implemented reset code in GUI. Removed save/restore settings options.
    [gui.py, interface.py]
2014-05-19 Updated logo
    Updated Poster.pptx
    + Added Overview
    + Added references
    =Updated schematic printouts
    =Updated team info
    Added board enclosures (box) files
2014-05-20 Restored zero-length packet on sample export. Data persistence implementation complete. Pointer wrapping and memory full condition untested.
    [Erebus_Sensor.sdf]
2014-05-20 Added sucess messages to reset and data export
    [gui.py]
2014-05-20 Merged host/device replies, switch order of command characters. Moved next command in data dump.
2014-05-20 Verified data persistence and wear levelling. Refactored and organized code.
    [Erebus_Sensor.sdf]
2014-05-26 Cleaned up stuff
    Made Schematics easier to read
    Split Supplies in BOM and made names match references
    Renamed parts on sensor
    [BOM.ods, BOM.xls, Gas_Sensor.brd, Gas_Sensor.sch, LDO.sch, Light_Sensor_Layout.brd, Light_Sensor_Layout.sch, Main_Board_SW2.brd]
2014-05-27 Fixed indentation errors in GUI script
    [gui.py, interface.py]
2014-05-29 Pushed up old file that got over worte
    [BOM.ods]
2014-05-30 Created Dev Board Master and Master. Updated IO for PCB
    [Erebus_Sensor.sdf]
2014-05-31 Master Update.
    LED Color Correction
    Start/Stop Interrupt PICU
    Battery Sense
    [Erebus_Sensor.sdf]
2014-05-31 Fixed misnamed reset function call
    [interface.py]
2014-06-02 Removed Bryan's code folder
    [Erebus_Sensor.sdf, USB_UART01.sdf]
2014-06-02 Removed Scott's code folder
    [Erebus_Sensor.sdf]
2014-06-02 Removed Max's code folder
    [ADCtoEEPROM.sdf, Em_EEPROM_Example01.sdf]
2014-06-02 Removed DemoBuild code folder
    [Erebus_Sensor.sdf]
2014-06-02 Removed BreadBoardBuild code folder
    [Erebus_Sensor.sdf]
2014-06-02 Renamed master to master_pcb
    [Erebus_Sensor.sdf]
2014-06-02 Updated master_pcb with correct pin assignments
    [Erebus_Sensor.sdf]
2014-06-02 Renamed Dev Board Master to master_devboard
    [Erebus_Sensor.sdf]
2014-06-02 Removed every second battery check used for debugging
2014-06-02 Refactored button masks and PICU register out of RTC interrupt file
2014-06-02 Updated master_devboard with fixes from master_pcb
    [Erebus_Sensor.sdf]
2014-06-02 Cleaned build files from master_pcb folder
    [Erebus_Sensor.sdf]
2014-06-02 Updated budget with PCB and Digikey order info
2014-06-02 Pull Request
    [BOM.ods]
2014-06-02 Added Cypress USBUART Windows drivers
2014-06-03 Cost for single unit
    [BomForOneCompleteSwitchingBuild.ods]
2014-06-03 Added sensor and power section to design specs.
    [BomForOneCompleteSwitchingBuild.xls]
2014-06-04 User Manual
    [BomForOneCompleteSwitchingBuild.ods]
2014-06-05 Presentation updated to rough draft
    Added new box layout file (wip)
    [BOM.xls]
2014-06-05 Reorganized Documents Directory
    [BOM.ods, BOM.xls, BOM_SwitchingSupply.xls, BomForOneCompleteSwitchingBuild.ods, BomForOneCompleteSwitchingBuild.xls]
2014-06-05 Fixed layout of BOM
    [BOM_SwitchingSupply.xls]
2014-06-05 Updated Budget with final BOM costs
2014-06-05 Changed sensor #1 to Gas sensor, added sensor #2: Custom sensor
2014-06-06 Removed dev board build
    [Erebus_Sensor.sdf]
2014-06-06 Pushed The Test Plan! Update Format.
    [TestPlanTestSheets.xlsx]
2014-06-06 Boo Boo fix on Gas Sensor
    [Gas_Sensor.brd, Gas_Sensor.sch]
2014-06-06 Added static keyword to necessary functions, reordered function definitions so prototypes could be removed, fixed loop in update_settings(), moved header inclusions to *.c files
    [Erebus_Sensor.sdf]
2014-06-18 Updated enclosure files added Old files moved to folder
2014-06-18 Moved sensor and USB port holes down to accommodate problems with first run cutouts. Sensor port worked ok, but washers had to be added to the board to lift the USB port high enough for a cable to fi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
2014-06-18 Fixed the holes... again...
