erebus-labs/PSU-VOC-SENSOR-2K14/(notices)

Notices in the files:
parts and their libraries:
supressor: Copyright (C) 2009, Bob Starr
